Kaihongho/Powder_model_design/README.md

1. 目前最新的三轴平台是GANTRY44_AUTO_BUCKET.SLDPRT
