Kaihongho/Powder_model_design/drawings/B-001_overall.png

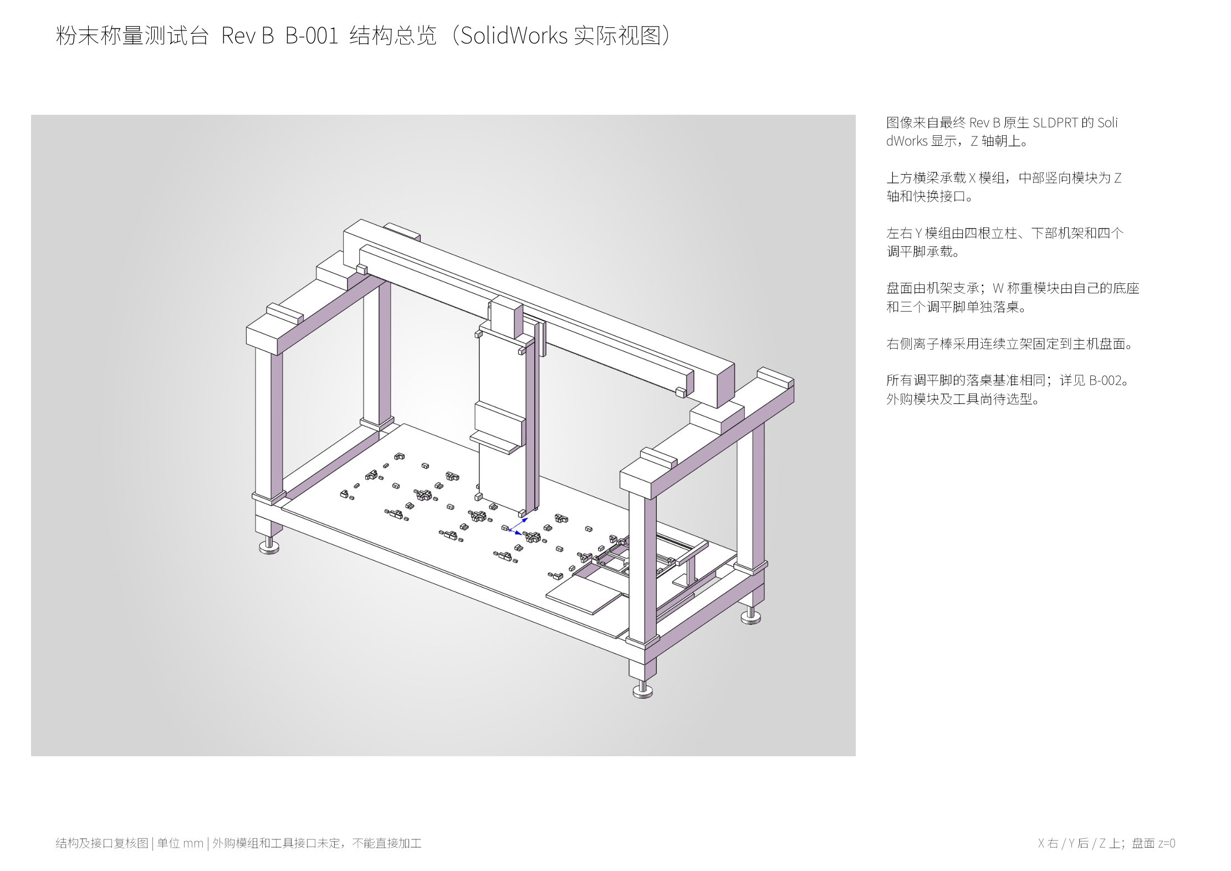
drawings/B-001_overall.png
