Kaihongho/Powder_model_design/drawings/B-002_support.png

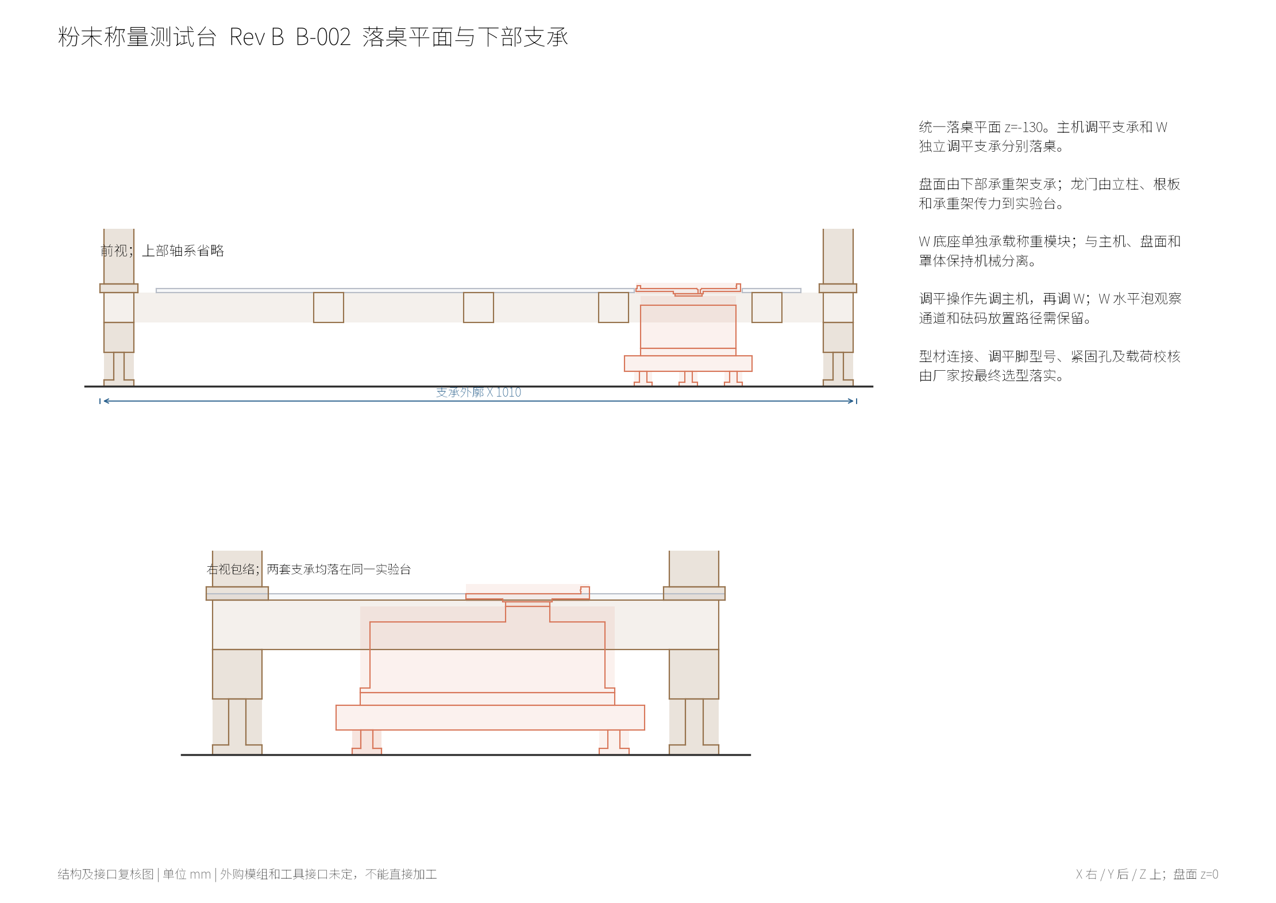
drawings/B-002_support.png
