Kaihongho/Powder_model_design/drawings/B-003_layout.png

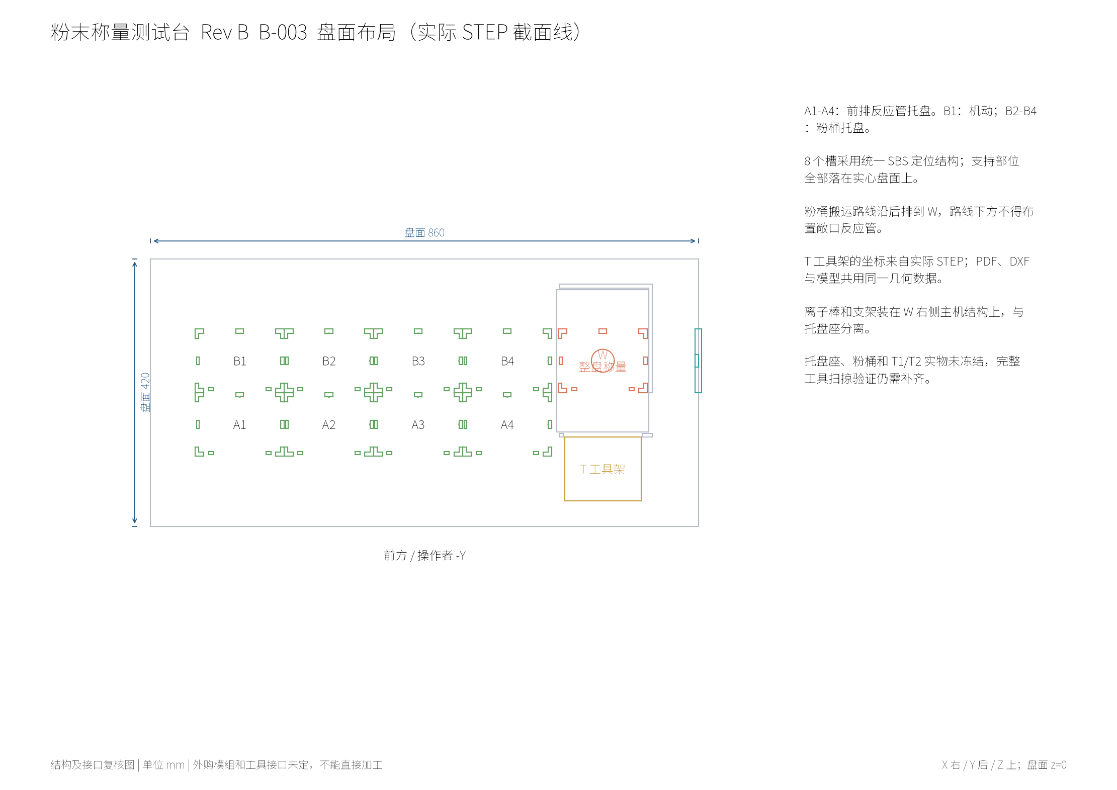
drawings/B-003_layout.png
