Kaihongho/Powder_model_design/drawings/B-004_weighing.png

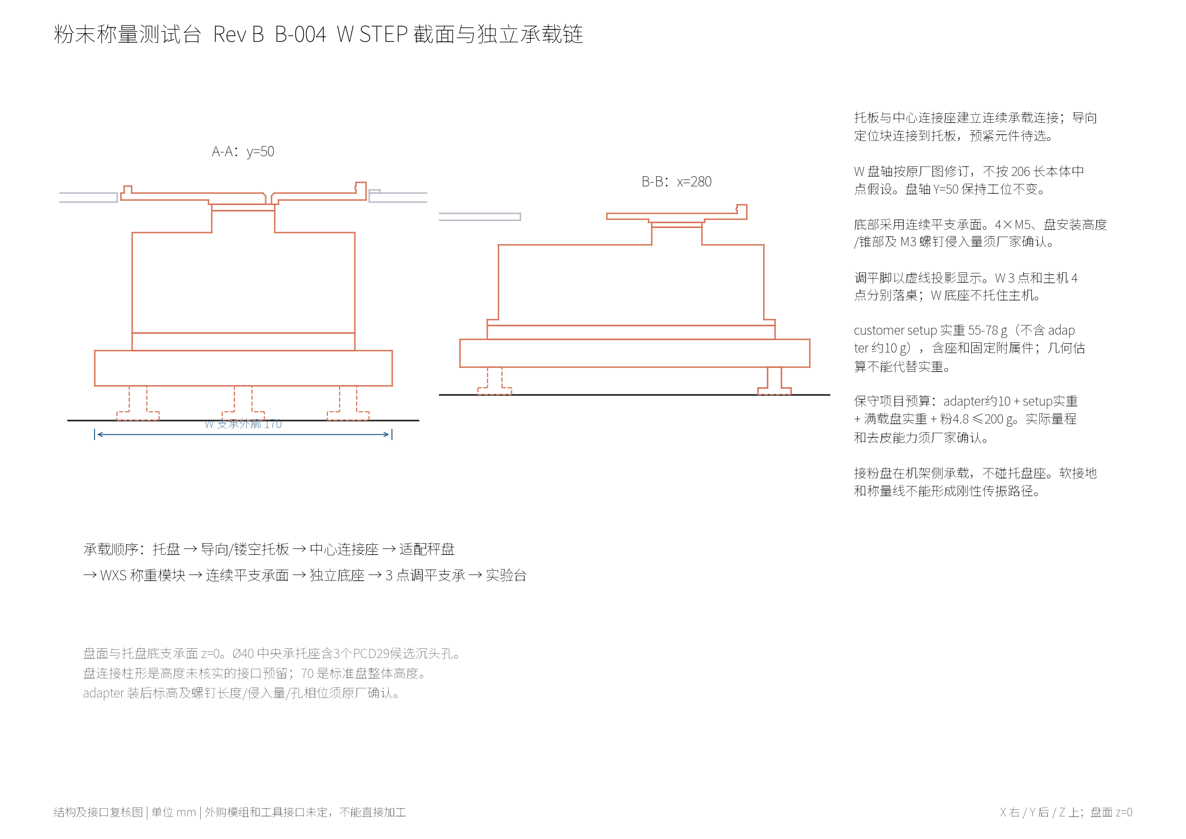
drawings/B-004_weighing.png
