Kaihongho/Powder_model_design/drawings/B-005_motion.png

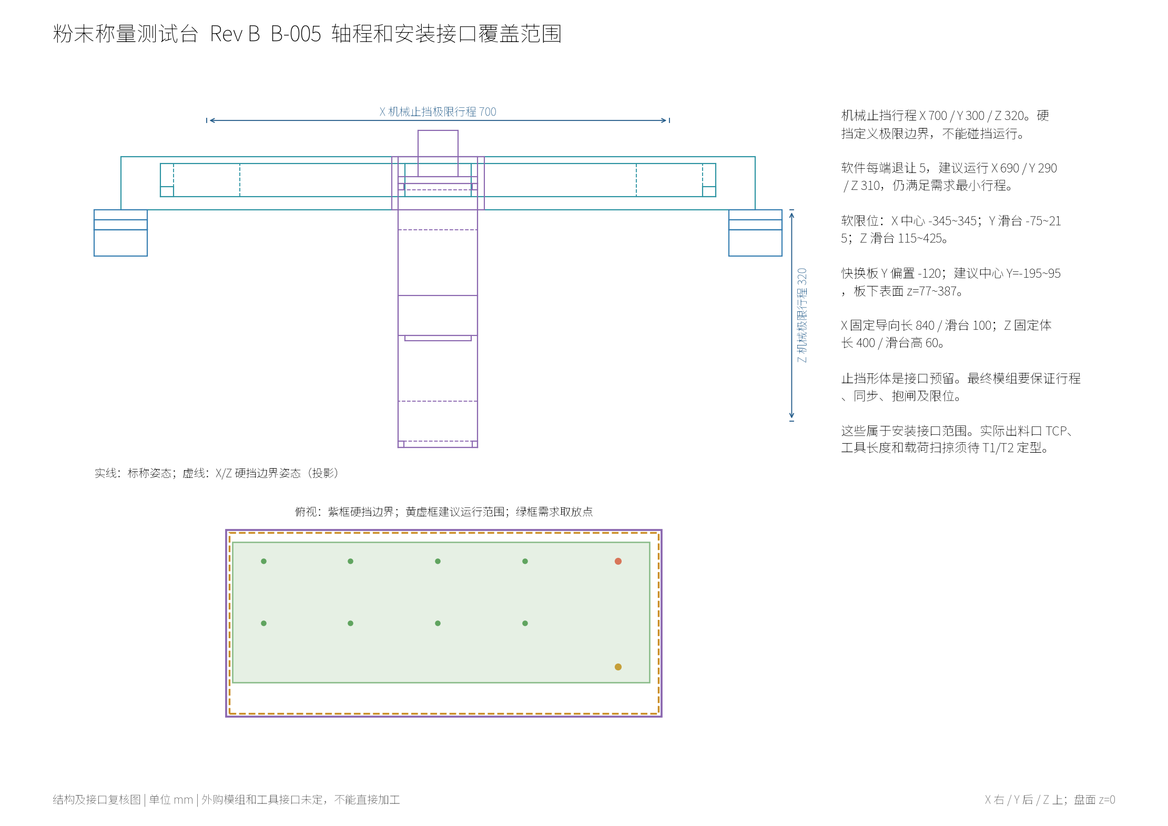
drawings/B-005_motion.png
