Kaihongho/Powder_model_design/drawings/B-006_connections.png

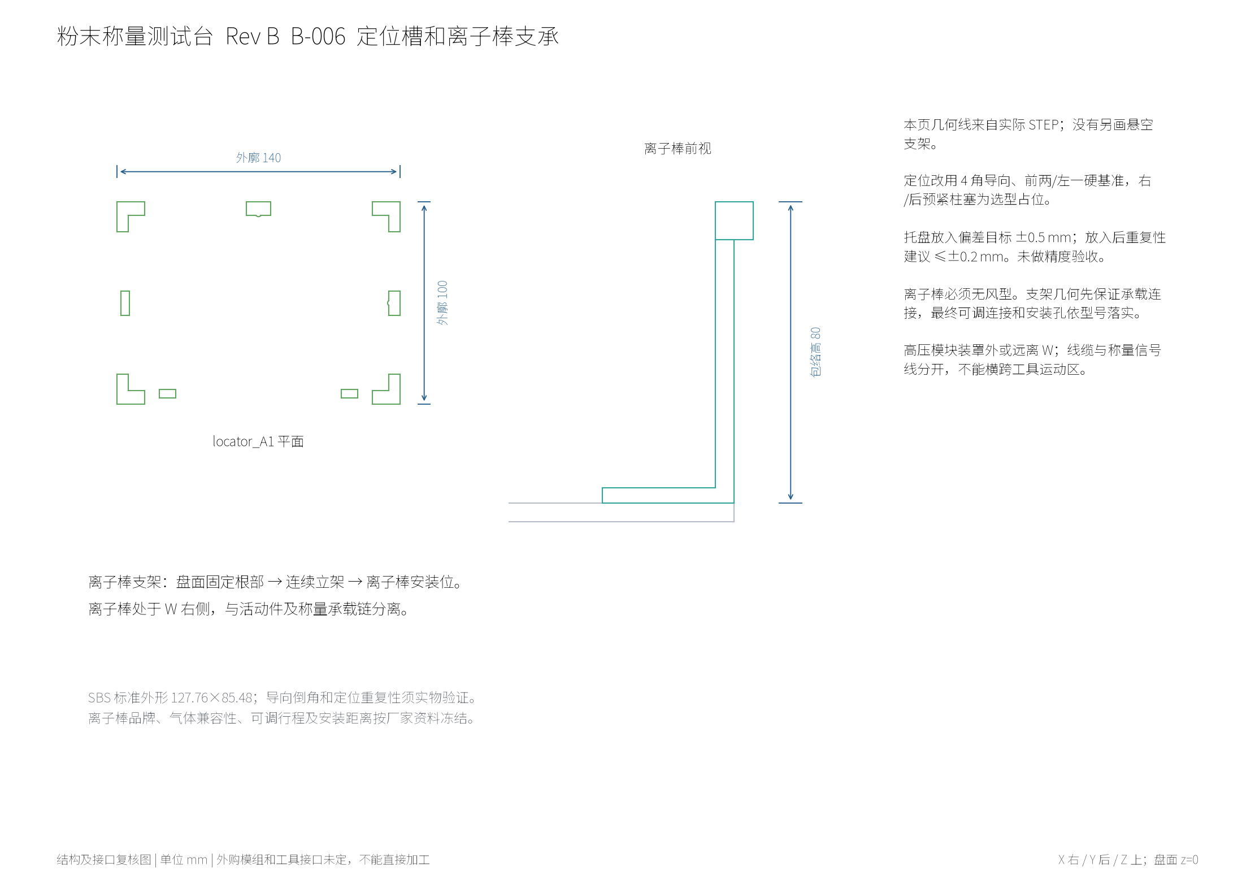
drawings/B-006_connections.png
