Kaihongho/Powder_model_design/drawings/B-007_review.png

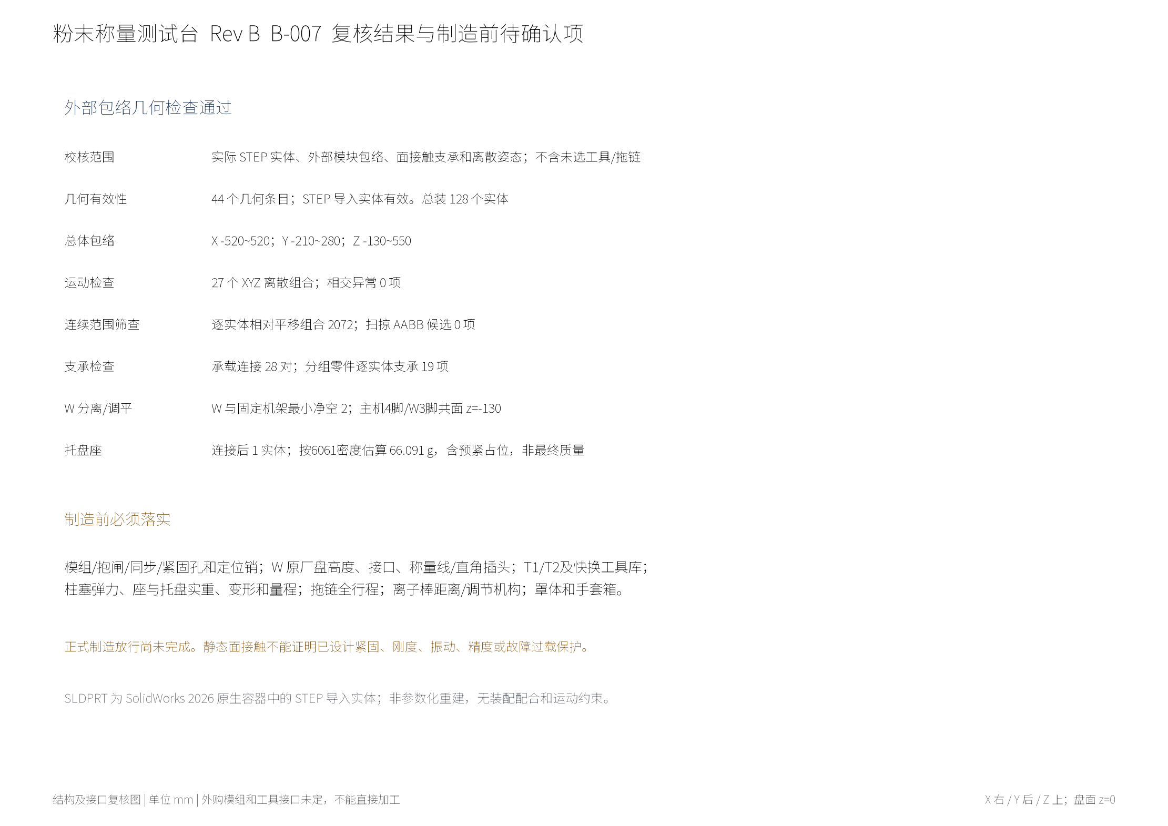
drawings/B-007_review.png
