Kaihongho/Powder_model_design/drawings/native_overall.png

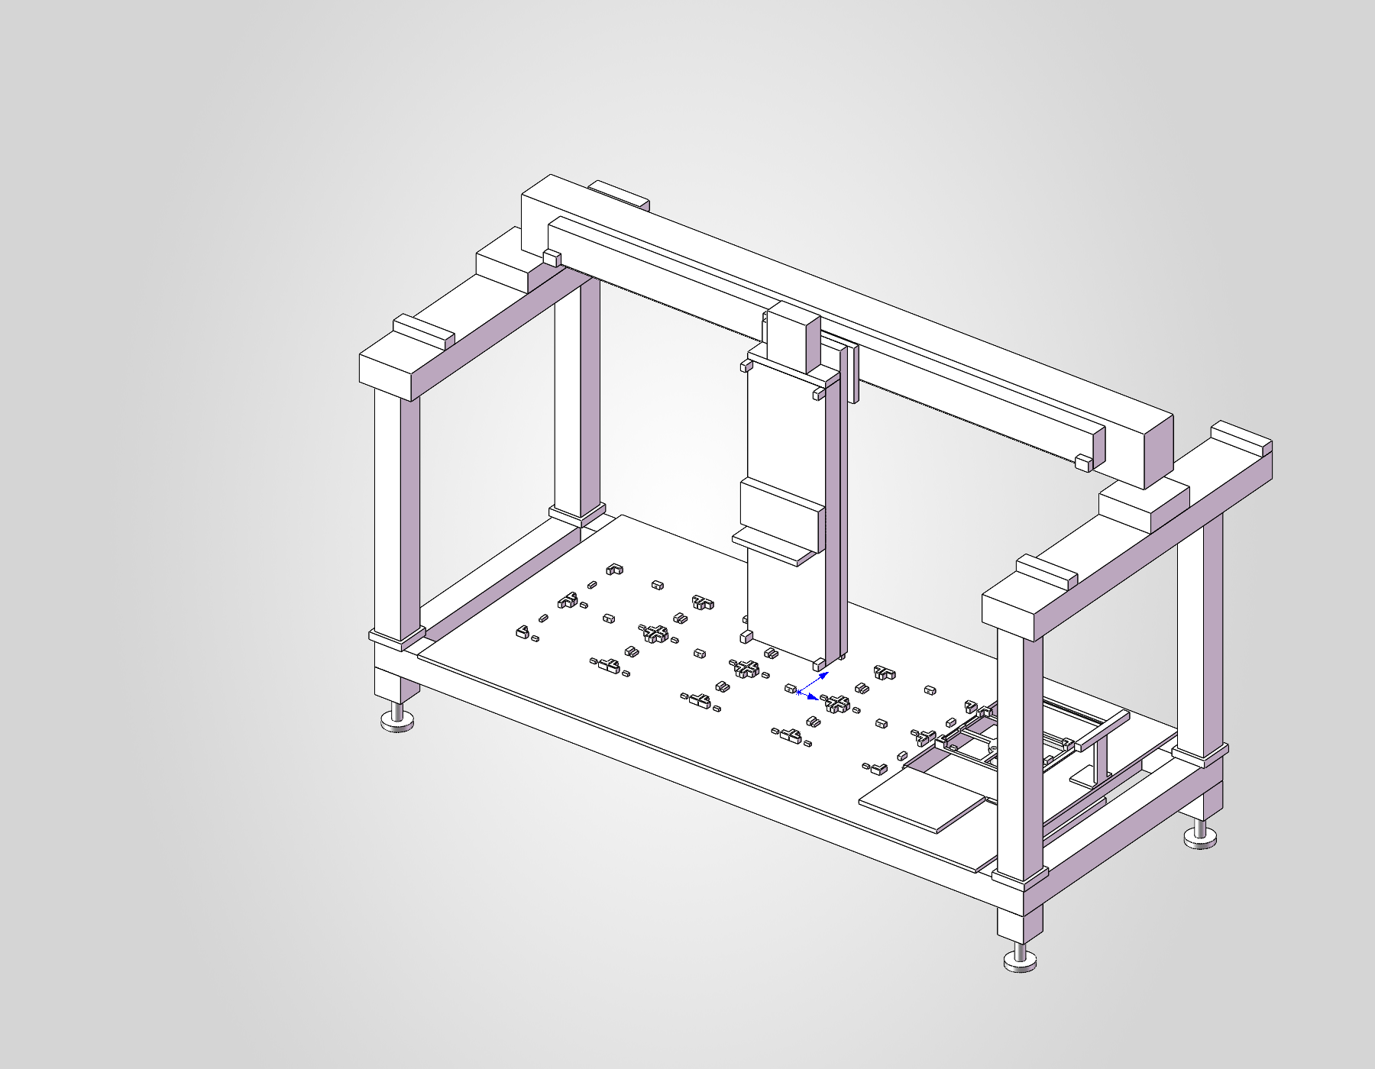
drawings/native_overall.png
