Kaihongho/Powder_model_design/粉桶图纸与说明/T2_取放步骤.png

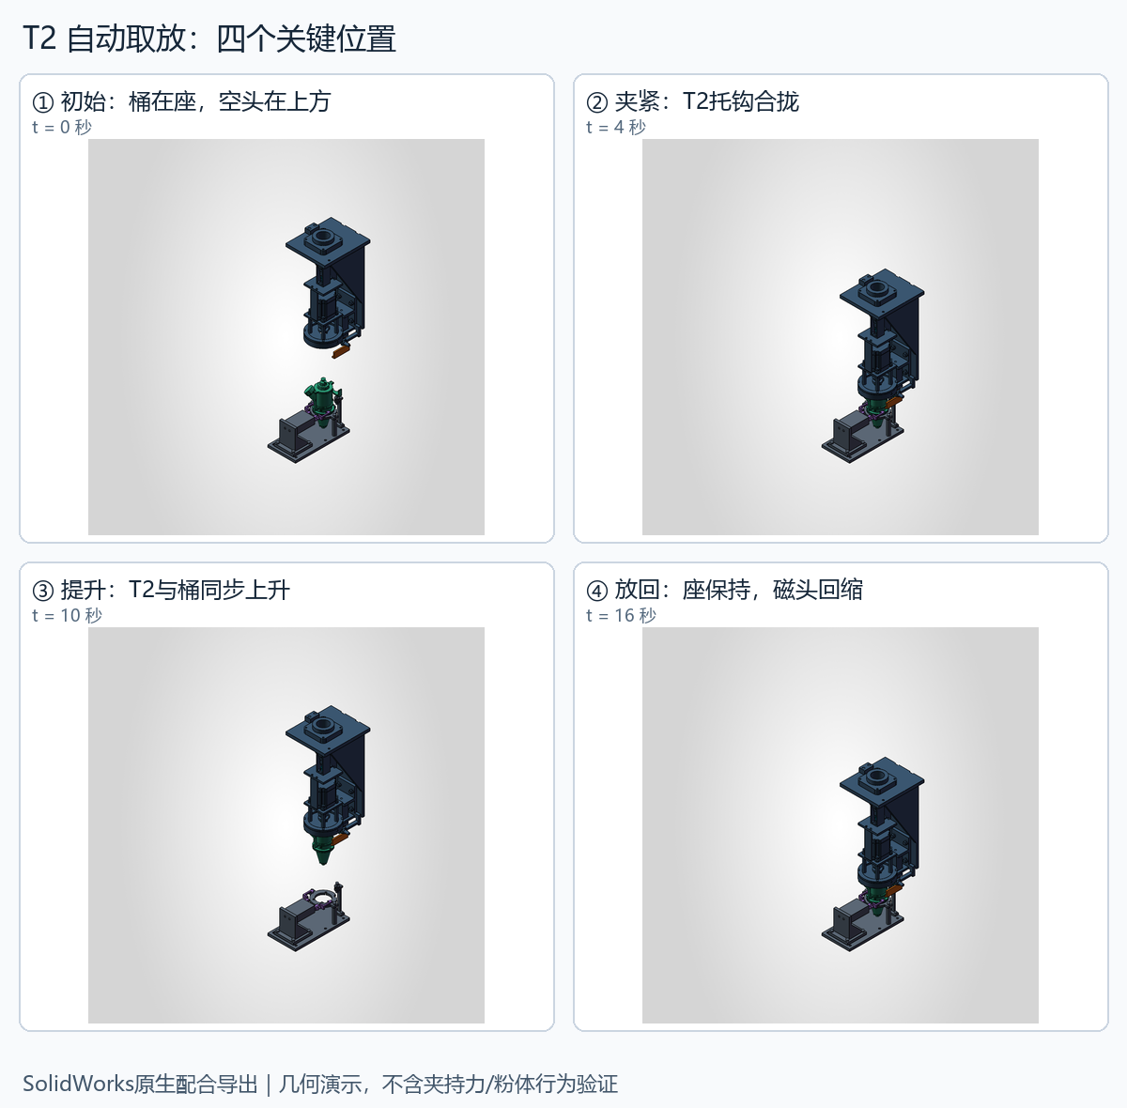
粉桶图纸与说明/T2_取放步骤.png
