Kaihongho/Powder_model_design/粉桶图纸与说明/T2_自动取放演示.gif

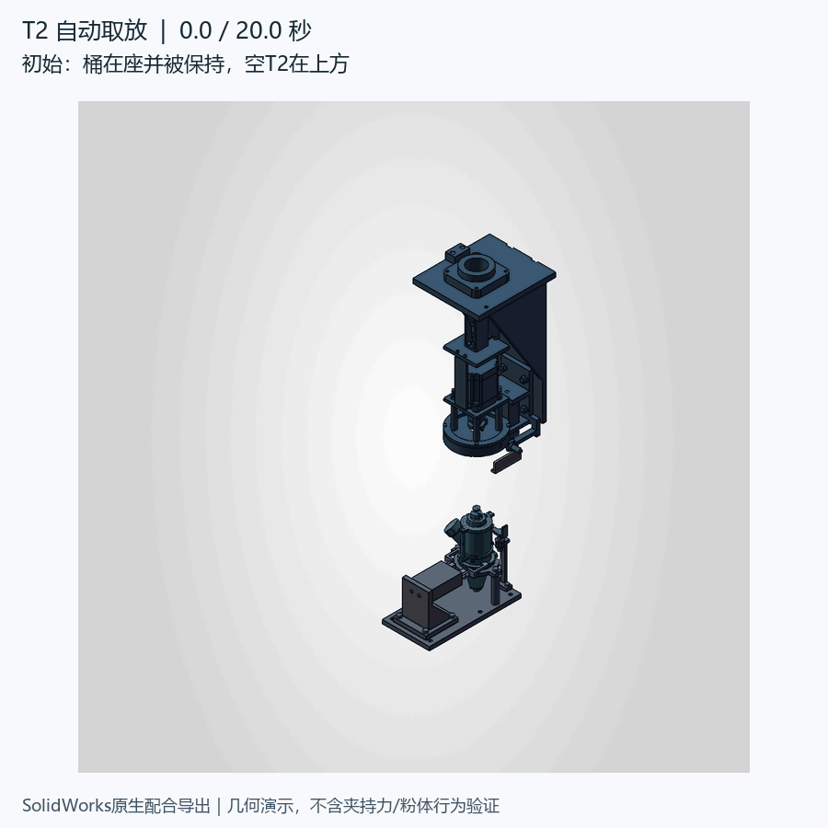
粉桶图纸与说明/T2_自动取放演示.gif
