Kaihongho/Powder_model_design/粉桶图纸与说明/T2接口承载架.png

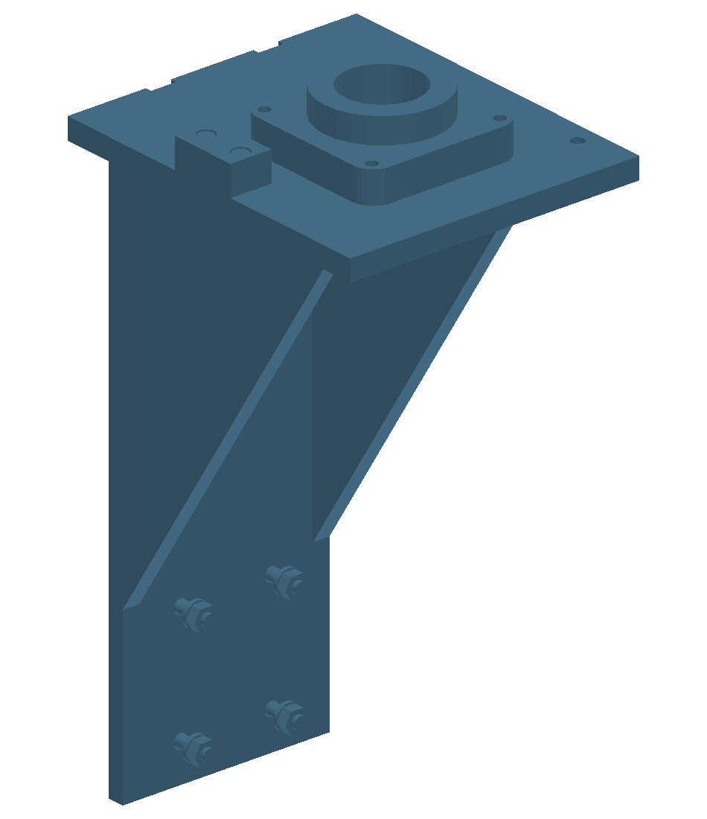
粉桶图纸与说明/T2接口承载架.png
