Kaihongho/Powder_model_design/粉桶图纸与说明/valve_rotation_overview.png

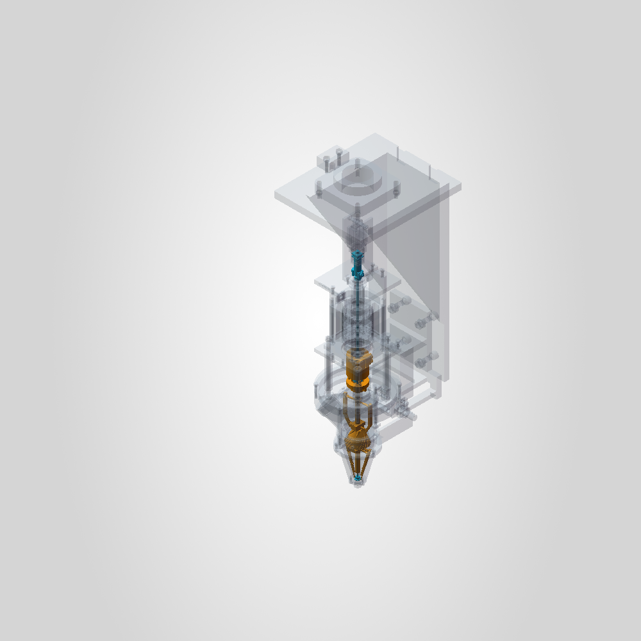
粉桶图纸与说明/valve_rotation_overview.png
