Kaihongho/Powder_model_design/粉桶图纸与说明/上部驱动与夹持.png

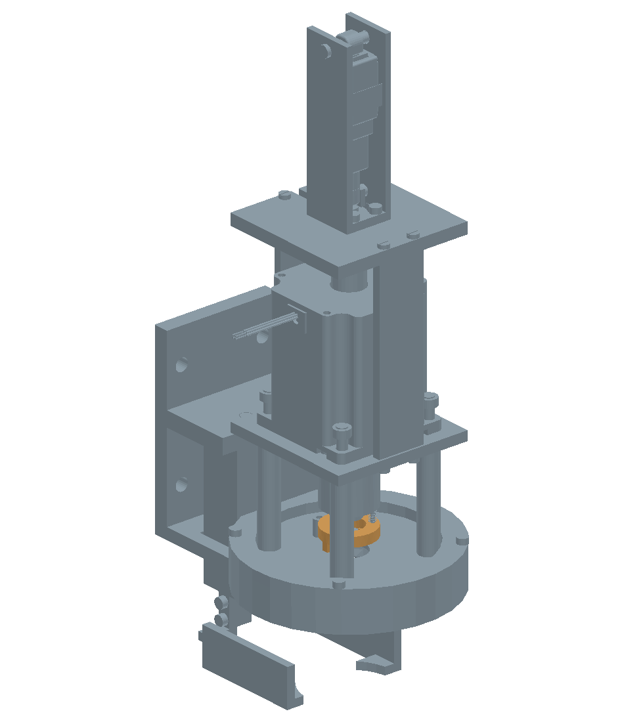
粉桶图纸与说明/上部驱动与夹持.png
