Kaihongho/Powder_model_design/粉桶图纸与说明/下部粉桶闭盖.png

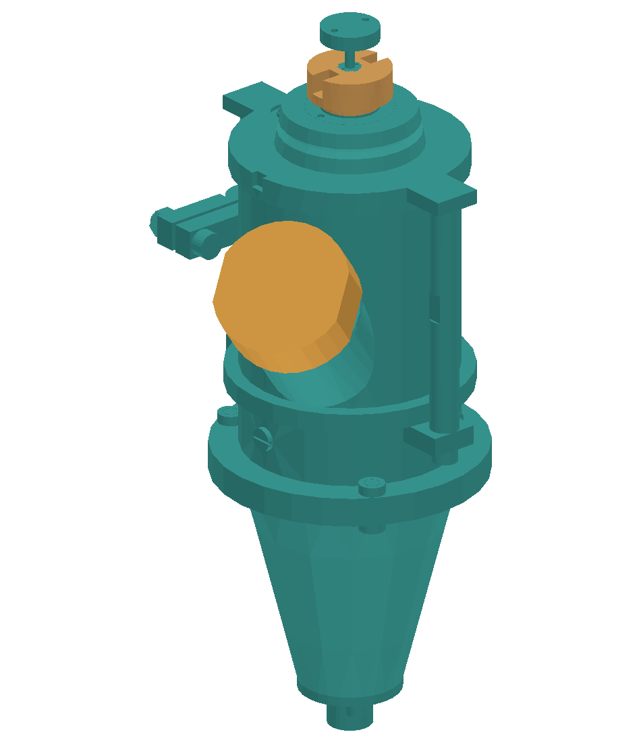
粉桶图纸与说明/下部粉桶闭盖.png
