Kaihongho/Powder_model_design/粉桶图纸与说明/对接总成.png

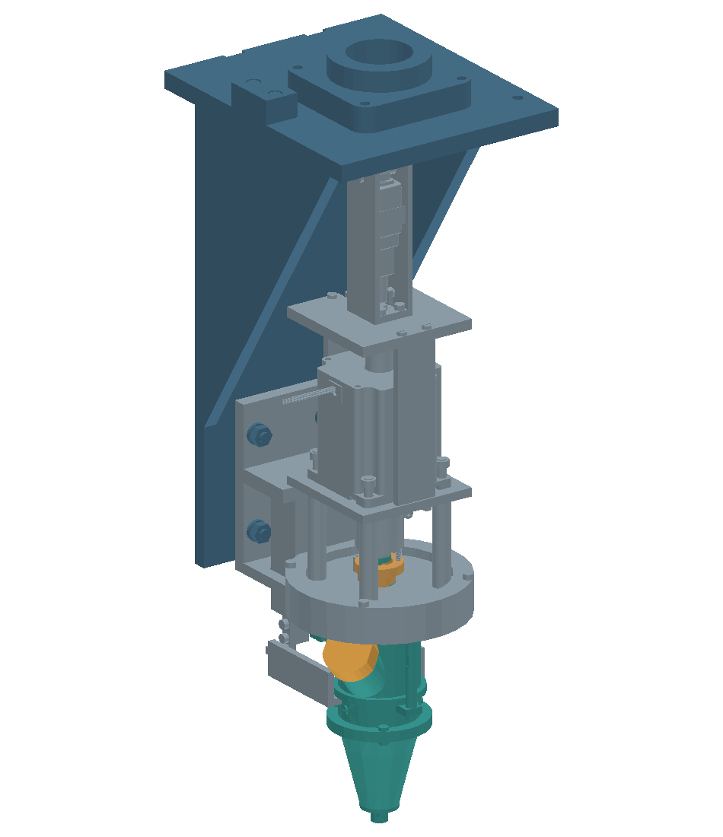
粉桶图纸与说明/对接总成.png
