Kaihongho/Powder_model_design/龙门架_BOM.xlsx

Sheet: 整机BOM
4.4 三轴龙门架 BOM
范围：龙门架、随Z驱动头支承、自动夹桶及随桶保持件。内部摆盘不在本次范围。
数量按采购件/套统计。模组固定体与滑台合为成套；原桶原件不与夹具聚合STEP重复计数。
机架定制项 | 21 | 轴模组成套数 | 4 |  | 原桶保留件成套数 | 1
分类 | 编号 | 名称 | 数量 | 单位 | 规格与接口（mm） | 材料 | 制造/采购状态 | 来源与模型编号
机架定制 | F_side_lower_L | 侧框下横管（左） | 1 | 件 | 外廓 X/Y/Z：60 × 969 × 60 mm。焊接侧框;焊缝详图定义, 不用贴面代替连接 | Q235B矩形管60×60×4 | 名义几何；工艺公差待冻结 | gantry44_manifest.json；F_side_lower_L.step
机架定制 | F_post_L_front | 立柱（前） | 1 | 件 | 外廓 X/Y/Z：60 × 60 × 528 mm。四周连续角焊缝a4;组焊去应力后精加工顶面 | Q235B矩形管60×60×4 | 名义几何；工艺公差待冻结 | gantry44_manifest.json；F_post_L_front.step
机架定制 | F_post_L_rear | 立柱（后） | 1 | 件 | 外廓 X/Y/Z：60 × 60 × 528 mm。四周连续角焊缝a4;组焊去应力后精加工顶面 | Q235B矩形管60×60×4 | 名义几何；工艺公差待冻结 | gantry44_manifest.json；F_post_L_rear.step
机架定制 | F_top_rail_L | Y轴上承梁（左） | 1 | 件 | 外廓 X/Y/Z：80 × 700 × 80 mm。与两柱焊接, 前后柱均承载 | Q235B矩形管80×80×4 | 名义几何；工艺公差待冻结 | gantry44_manifest.json；F_top_rail_L.step
机架定制 | F_top_cap_L | Y轴安装盖板（左） | 1 | 件 | 外廓 X/Y/Z：120 × 720 × 12 mm。焊后同装夹加工两侧安装平面;槽母/螺栓实装固定模组 | Q235B机加工盖板 | 名义几何；工艺公差待冻结 | gantry44_manifest.json；F_top_cap_L.step
机架定制 | F_foot_boss_L_front | 调平脚螺母套（前） | 1 | 件 | 外廓 X/Y/Z：24 × 24 × 20 mm。 | 钢焊接M12螺母套 | 名义几何；工艺公差待冻结 | gantry44_manifest.json；F_foot_boss_L_front.step
机架定制 | F_foot_boss_L_rear | 调平脚螺母套（后） | 1 | 件 | 外廓 X/Y/Z：24 × 24 × 20 mm。 | 钢焊接M12螺母套 | 名义几何；工艺公差待冻结 | gantry44_manifest.json；F_foot_boss_L_rear.step
机架定制 | F_side_lower_R | 侧框下横管（右） | 1 | 件 | 外廓 X/Y/Z：60 × 969 × 60 mm。焊接侧框;焊缝详图定义, 不用贴面代替连接 | Q235B矩形管60×60×4 | 名义几何；工艺公差待冻结 | gantry44_manifest.json；F_side_lower_R.step
机架定制 | F_post_R_front | 立柱（前） | 1 | 件 | 外廓 X/Y/Z：60 × 60 × 528 mm。四周连续角焊缝a4;组焊去应力后精加工顶面 | Q235B矩形管60×60×4 | 名义几何；工艺公差待冻结 | gantry44_manifest.json；F_post_R_front.step
机架定制 | F_post_R_rear | 立柱（后） | 1 | 件 | 外廓 X/Y/Z：60 × 60 × 528 mm。四周连续角焊缝a4;组焊去应力后精加工顶面 | Q235B矩形管60×60×4 | 名义几何；工艺公差待冻结 | gantry44_manifest.json；F_post_R_rear.step
机架定制 | F_top_rail_R | Y轴上承梁（右） | 1 | 件 | 外廓 X/Y/Z：80 × 700 × 80 mm。与两柱焊接, 前后柱均承载 | Q235B矩形管80×80×4 | 名义几何；工艺公差待冻结 | gantry44_manifest.json；F_top_rail_R.step
机架定制 | F_top_cap_R | Y轴安装盖板（右） | 1 | 件 | 外廓 X/Y/Z：120 × 720 × 12 mm。焊后同装夹加工两侧安装平面;槽母/螺栓实装固定模组 | Q235B机加工盖板 | 名义几何；工艺公差待冻结 | gantry44_manifest.json；F_top_cap_R.step
机架定制 | F_foot_boss_R_front | 调平脚螺母套（前） | 1 | 件 | 外廓 X/Y/Z：24 × 24 × 20 mm。 | 钢焊接M12螺母套 | 名义几何；工艺公差待冻结 | gantry44_manifest.json；F_foot_boss_R_front.step
机架定制 | F_foot_boss_R_rear | 调平脚螺母套（后） | 1 | 件 | 外廓 X/Y/Z：24 × 24 × 20 mm。 | 钢焊接M12螺母套 | 名义几何；工艺公差待冻结 | gantry44_manifest.json；F_foot_boss_R_rear.step
机架定制 | F_cross_lower_front | 底部横梁（前） | 1 | 件 | 外廓 X/Y/Z：1140 × 60 × 60 mm。两端a4连续角焊缝 | Q235B矩形管60×60×4 | 名义几何；工艺公差待冻结 | gantry44_manifest.json；F_cross_lower_front.step
机架定制 | F_cross_lower_rear | 底部横梁（后） | 1 | 件 | 外廓 X/Y/Z：1140 × 60 × 60 mm。两端a4连续角焊缝 | Q235B矩形管60×60×4 | 名义几何；工艺公差待冻结 | gantry44_manifest.json；F_cross_lower_rear.step
机架定制 | B_sole_L | X横梁端底板（左） | 1 | 件 | 外廓 X/Y/Z：140 × 150 × 12 mm。6061焊接箱梁端底板;沉孔M5从箱梁贯通工具孔安装 | 6061-T6 | 名义几何；工艺公差待冻结 | gantry44_manifest.json；B_sole_L.step
机架定制 | B_sole_R | X横梁端底板（右） | 1 | 件 | 外廓 X/Y/Z：140 × 150 × 12 mm。6061焊接箱梁端底板;沉孔M5从箱梁贯通工具孔安装 | 6061-T6 | 名义几何；工艺公差待冻结 | gantry44_manifest.json；B_sole_R.step
机架定制 | B_crossbeam | X轴承载箱梁 | 1 | 件 | 外廓 X/Y/Z：1330 × 80 × 120 mm。箱形截面120×80×5;6061焊接区按退火强度校核,去应力后加工安装面;两端底板a4焊接 | 6061-T6 | 名义几何；工艺公差待冻结 | gantry44_manifest.json；B_crossbeam.step
机架定制 | A_Z_fixed_backplate | Z固定背板 | 1 | 件 | 外廓 X/Y/Z：110 × 12 × 575 mm。110×575×12;两列Z底槽M6,4×M5连接X滑台;无需重钻厂家件 | 6061-T6 | 名义几何；工艺公差待冻结 | gantry44_manifest.json；A_Z_fixed_backplate.step
机架定制 | A_Z_tool_drop | Z端带筋下伸座 | 1 | 件 | 外廓 X/Y/Z：100 × 30 × 290 mm。整体铣削带筋下伸座,不以零件悬空获得工作高度;全行程端点TCP=25..345 | 6061-T6 | 名义几何；工艺公差待冻结 | gantry44_manifest.json；A_Z_tool_drop.step
机架标准件 | Ybase_M6x18 | Y模组底座圆柱头螺钉 | 12 | 件 | M6 × 18 | 钢 | 等级/表面处理/扭矩待冻结 | gantry44_manifest.json：Ybase_M6x18；按实例计数
外购待定 | F_level_foot | 调平支脚 | 4 | 件 | M12脚杆、脚垫Ø60；需按整机重量选额定载荷 | 钢/防滑脚垫 | 供应商型号/承载待确认 | gantry44_manifest.json：F_level_foot；按实例计数
机架标准件 | F_locknut_M12 | 调平脚锁紧螺母 | 4 | 件 | M12 | 钢 | 等级/表面处理/扭矩待冻结 | gantry44_manifest.json：F_locknut_M12；按实例计数
机架标准件 | Yslide_M5x20 | Y滑台连接螺钉 | 12 | 件 | M5 × 20 | 钢 | 等级/表面处理/扭矩待冻结 | gantry44_manifest.json：Yslide_M5x20；按实例计数
机架标准件 | Xbase_M6x12 | X模组底座螺钉 | 10 | 件 | M6 × 12 | 钢 | 等级/表面处理/扭矩待冻结 | gantry44_manifest.json：Xbase_M6x12；按实例计数
机架标准件 | Xbase_washer | X模组底座平垫 | 10 | 件 | M6；几何尺寸以分件STEP为准 | 钢 | 等级/表面处理/扭矩待冻结 | gantry44_manifest.json：Xbase_washer；按实例计数
机架标准件 | XZ_M5x25 | X滑台与Z背板连接螺钉 | 4 | 件 | M5 × 25 | 钢 | 等级/表面处理/扭矩待冻结 | gantry44_manifest.json：XZ_M5x25；按实例计数
机架标准件 | Zbase_M6x18 | Z模组底座螺钉 | 8 | 件 | M6 × 18 | 钢 | 等级/表面处理/扭矩待冻结 | gantry44_manifest.json：Zbase_M6x18；按实例计数
机架标准件 | Zslide_M4x20 | Z滑台与下伸座螺钉 | 6 | 件 | M4 × 20 | 钢 | 等级/表面处理/扭矩待冻结 | gantry44_manifest.json：Zslide_M4x20；按实例计数
机架标准件 | Tool_M6x40 | 夹具背板与下伸座螺钉 | 4 | 件 | M6 × 40 | 钢 | 等级/表面处理/扭矩待冻结 | gantry44_manifest.json：Tool_M6x40；按实例计数
机架标准件 | Tool_M6_nut | 夹具接口螺母 | 4 | 件 | M6 | 钢 | 等级/表面处理/扭矩待冻结 | gantry44_manifest.json：Tool_M6_nut；按实例计数
机架标准件 | Tool_M6_washer | 夹具接口平垫 | 4 | 件 | M6；几何尺寸以分件STEP为准 | 钢 | 等级/表面处理/扭矩待冻结 | gantry44_manifest.json：Tool_M6_washer；按实例计数
接口定制 | FSL80_slot_nut | FSL80轴向装入槽母 | 22 | 件 | M6，20 × 9.4 × 4 mm；厂家装入后封端 | 钢 | 材料/螺纹承载/扭矩待厂家确认 | gantry44_manifest.json：FSL80_slot_nut；按实例计数
接口定制 | FSL60_slot_nut | FSL60轴向装入槽母 | 8 | 件 | M6，长20/肩宽14.4/背宽10/厚4 mm；厂家装入 | 钢 | 材料/螺纹承载/扭矩待厂家确认 | gantry44_manifest.json：FSL60_slot_nut；按实例计数
外购轴模组 | AX-X | X轴成套模组 | 1 | 套 | FSL80 E800 10C7-BC-B60参考；工作行程700 mm；含壳体、滑台及配套电机 | 原厂混合材料 | 订货配置/力矩/原点限位待确认 | FSL80 E800 10C7-BC-B60.STEP；FUYU手册v3.1
外购轴模组 | AX-Y | 双Y轴成套模组 | 2 | 套 | 每套FSL80 E400参考；工作行程260 mm；两侧中心跨距1200 mm | 原厂混合材料 | 双Y同步/回零/电机配置待确认 | FSL80 E400 10C7-BC-B60.STEP；FUYU手册v3.1
外购轴模组 | AX-Z | Z轴成套模组（抱闸必选） | 1 | 套 | FSL60 E400参考；工作行程320 mm；订货必须带常闭失电制动 | 原厂混合材料 | 当前STEP未验证抱闸版；不可据此下单 | FSL60 E400 10C7-BC-B60.STEP；FUYU手册v3.1
原桶成套来源 | SRC-BUCKET | 原粉桶及驱动头保留部件 | 1 | 套 | 源有59种SLDPRT。装入时扣除原lid、dock_lock_ring、dock_lock_toggle，新增B/C件另列。 | 源混合材料未冻结 | 成套来源；内部驱动连接仍待验证 | burr_mill_doser_improved.SLDASM；原桶来源与替换表
夹具标准件 | C-F01 | 压盖圆柱头螺钉 | 4 | 件 | M3 × 18。 | 按采购 | 等级/扭矩待冻结 | clamp_manufacturing_dimensions.json；C-F01_cap_M3x18_0、C-F01_cap_M3x18_1、C-F01_cap_M3x18_2、C-F01_cap_M3x18_3
夹具标准件 | C-F02 | 电爪安装螺钉 | 2 | 件 | M3 × 10。 | 按采购 | 按Zimmer安装要求 | clamp_manufacturing_dimensions.json；C-F02_GEP_M3x10_-8、C-F02_GEP_M3x10_8
夹具标准件 | C-F03 | 电爪定位套 | 2 | 件 | Ø5 / 内Ø3.2 × 2.4 mm；两面各嵌1.2。 | 按采购 | 订货确认是否随电爪供货 | clamp_manufacturing_dimensions.json；C-F03_GEP_D5_sleeve_-8、C-F03_GEP_D5_sleeve_8
夹具标准件 | C-F07 | 平端内六角紧定螺钉 | 1 | 件 | ISO4026 M6 × 12；内六角3；进入原机头径向孔外段。 | 按采购 | 等级/防松扭矩待冻结 | clamp_manufacturing_dimensions.json；C-F07_ISO4026_M6x12_anti_rotation
夹具定制 | C-A01 | 头盘一体托座及电爪承载后背 | 1 | 件 | 内Ø90.2定位环，外Ø100；后面Y90；4×Ø6.6孔距44×55。 | 6061-T6候选 | 名义几何；制造公差待冻结 | clamp_manufacturing_dimensions.json；C-A01_head_capture_and_rear_bracket
夹具定制 | C-A02 | 头盘外缘压盖 | 1 | 件 | 内Ø78/外Ø100×5；4×Ø3.2孔PCD95。 | 6061-T6候选 | 名义几何；制造公差待冻结 | clamp_manufacturing_dimensions.json；C-A02_head_capture_cap
外购电爪 | C-P01 | 电动平行夹爪成套 | 1 | 套 | Zimmer GEP2006IL-03-B；含本体与两原爪；每爪行程6 mm。 | 按采购 | 二维接口建模；型号/负载最终核对 | clamp_manufacturing_dimensions.json；C-P01_GEP2006IL03_2D_INTERFACE（C-P03两原爪随套，不重复采购）
外购待定 | C-P02 | 桶在位M5探头 | 1 | 件 | CAD仅包络。端面中心线距桶2.104 mm，最小边缘间隙0.960 mm。 | 按采购 | 实际有效检测距离/型号未定 | clamp_manufacturing_dimensions.json；C-P02_M5_presence_sensor_PROCUREMENT_ENVELOPE
夹具标准件 | C-F04 | M5传感器锁母 | 2 | 件 | M5；配最终传感器外螺纹。 | 按采购 | 订货确认是否随传感器供货 | clamp_manufacturing_dimensions.json；C-F04_M5_sensor_nut_front、C-F04_M5_sensor_nut_rear
夹具定制 | C-A03_positive_capture_finger_-1 | 正向承托夹指（左） | 1 | 件 | 两件镜像；闭合内弧Ø44.6，托Ø50法兰；每爪开6 mm。 | 6061-T6候选 | 指长/偏心负载待Zimmer确认 | clamp_manufacturing_dimensions.json；C-A03_positive_capture_finger_-1
夹具标准件 | C-F05 | 夹指安装螺钉 | 4 | 件 | M3 × 10，每指2颗。 | 按采购 | 按Zimmer安装要求 | clamp_manufacturing_dimensions.json；C-F05_finger_M3x10_-1_0、C-F05_finger_M3x10_-1_1、C-F05_finger_M3x10_1_0、C-F05_finger_M3x10_1_1
夹具标准件 | C-F06 | 夹指定位套 | 4 | 件 | Ø5 / 内Ø3.2 × 2.4 mm，每指2件。 | 按采购 | 订货确认是否随电爪供货 | clamp_manufacturing_dimensions.json；C-F06_finger_D5_sleeve_-1_0、C-F06_finger_D5_sleeve_-1_1、C-F06_finger_D5_sleeve_1_0、C-F06_finger_D5_sleeve_1_1
夹具定制 | C-A03_positive_capture_finger_1 | 正向承托夹指（右） | 1 | 件 | 两件镜像；闭合内弧Ø44.6，托Ø50法兰；每爪开6 mm。 | 6061-T6候选 | 指长/偏心负载待Zimmer确认 | clamp_manufacturing_dimensions.json；C-A03_positive_capture_finger_1
随桶配套 | B-A02 | 随桶拉柱 | 2 | 件 | Ø6 × 48.5825；上下M3深10；扳手对边5。 | 304不锈钢候选 | 304候选；公差/防松待冻结 | clamp_manufacturing_dimensions.json；B-A02_bucket_tie_post_-1、B-A02_bucket_tie_post_1
随桶配套 | B-A03 | 随桶法兰保持托脚 | 2 | 件 | 10 × 9.7 × 4 mm；Ø3.2通孔；两件镜像，正向托法兰。 | 6061-T6候选 | 名义几何；制造公差待冻结 | clamp_manufacturing_dimensions.json；B-A03_bucket_retention_foot_-1、B-A03_bucket_retention_foot_1
随桶配套 | B-F01 | 上盖齐平沉头螺钉 | 2 | 件 | M3 × 10，90°沉头，顶面不得高于原盖贴合面。 | 按采购 | 材料/防松扭矩待冻结 | clamp_manufacturing_dimensions.json；B-F01_flush_M3x10_-1、B-F01_flush_M3x10_1
随桶配套 | B-F02 | 拉柱底部圆柱头螺钉 | 2 | 件 | M3 × 12。 | 按采购 | 材料/防松扭矩待冻结 | clamp_manufacturing_dimensions.json；B-F02_bottom_M3x12_-1、B-F02_bottom_M3x12_1
随桶配套 | B-A01 | AUTO-SWAP派生上盖 | 1 | 件 | 保留源内型/锥面/气孔；新增±Y外耳与2×M3沉头连接。 | 原粉路材料未冻结 | 替换原lid；粉路材料待确认 | clamp_manufacturing_dimensions.json；B-A01_lid_AUTO_SWAP_derived

Sheet: 独立停车座
独立单桶停车座 BOM
下表为一个停车座的独立物料，不装入本次龙门架总装。自动释放前必须先由停车座承载粉桶。
停车座位置、安装基础及4颗底座安装螺钉的长度/配套螺母待安装现场确定，不虚填。
分类 | 编号 | 名称 | 数量 | 单位 | 规格与接口（mm） | 材料 | 制造/采购状态 | 来源与模型编号
停车座定制 | D-A03 | 停车座立柱 | 2 | 件 | Ø12 × 53.3556；上下M5螺纹。 | 6061-T6候选 | 名义几何；公差待冻结 | clamp_manufacturing_dimensions.json；D-A03_support_post_-1、D-A03_support_post_1
停车座标准件 | D-F01 | 停车座顶部圆柱头螺钉 | 2 | 件 | M5 × 16。 | 按采购 | 等级/扭矩待冻结 | clamp_manufacturing_dimensions.json；D-F01_top_M5x16_-1、D-F01_top_M5x16_1
停车座标准件 | D-F02 | 停车座底部沉孔螺钉 | 2 | 件 | M5 × 16圆柱头；底板沉孔内，不得凸出底面。 | 按采购 | 等级/扭矩待冻结 | clamp_manufacturing_dimensions.json；D-F02_bottom_M5x16_-1、D-F02_bottom_M5x16_1
停车座定制 | D-A01 | 独立停车底板 | 1 | 件 | 100 × 90 × 8；4×Ø6.6安装孔，中心(±40,±32)。 | 6061-T6候选 | 名义几何；安装位置另定 | clamp_manufacturing_dimensions.json；D-A01_dock_base
停车座定制 | D-A02 | 停车法兰承托座 | 1 | 件 | 内Ø44.4/外Ø70×6；托原Ø56下法兰；3×Ø6避螺钉头。 | 6061-T6候选 | 名义几何；公差待冻结 | clamp_manufacturing_dimensions.json；D-A02_flange_support_seat

Sheet: 待确认采购
制造前需要冻结的采购与验收项
本表是BOM采购状态补充，已有编号不重复计数；新增未定项数量留空，不虚构品牌和型号。
供应商答复填入J列。未获得真实型号和接口图前，相关几何不得标记为已验证。
编号 | 对应BOM | 功能项目 | 要求 | 必须确认的参数 | 当前缺口 | 接口/验收约束 | 依据 | 供应商答复
P01 | AX-Z（不另计套数） | Z轴常闭失电抱闸 | 必选 | 制动器或抱闸电机真实外形、失电保持力矩、额定负载和制动接线 | 缺厂家抱闸版图纸及断电实测 | 匹配Z整套配置 | 需求G4；axis_module_interfaces.json
P02 | AX-Y（不另计模组） | 双Y同步与独立回零 | 必选 | 闭环反馈、龙门校正、故障停机与回零策略；厂家决定具体电气配置 | 缺同步控制方案及带载验收 | 不得仅给两个电机相同脉冲 | 需求G1/G3；gantry_reference_audit.json
P03 | 新增电气成套 | 电机驱动器与运动控制器 | 必选 | 按X、双Y、Z及原桶电机的最终配置统一匹配；数量与型号暂无 | 缺轴电机选型/电气系统定义 | 热源远离天平W | 需求G6
P04 | C-P01（已计1套） | GEP夹爪采购与IO-Link | 必选 | 核对GEP2006IL-03-B；每爪6 mm；包括两原爪，定位套/螺钉供货范围需确认 | 缺指长定义/偏心力矩确认 | 每指CAD14.588 g，空间最远59.380 mm，仅几何参考 | Zimmer官方二维接口；clamp_manufacturing_dimensions.json
P05 | C-P02（已计1件） | 桶在位M5传感器 | 必选 | 最终型号取决于桶材料、有效检测距离、粉尘及接线；外形仅采购包络 | 中心线间隙2.104 mm；不能默认1 mm探头能检测 | 必须与爪位置形成双条件确认 | clamp_manufacturing_dimensions.json
P06 | 新增电气成套 | 原点、限位与故障检测 | 必选 | 清点模组现有接近开关，再确定补充数量/型号及安全接口 | 真实限位位置与控制原点尚未冻结 | 避免把STEP中一个开关当全套限位 | axis_module_interfaces.json
P07 | 新增安装配套 | 拖链、支架与运动电缆 | 必选 | 按实际线径、数量、弯曲半径和行程选择；不能只依空外廓下单 | 型号、长度、布线路径尚未定义 | 需追加全行程干涉核对 | 需求G1/G6；本轮未建模
P08 | SRC-BUCKET（成套内） | 原桶内部驱动与开阀执行器 | 待验证 | 旋转轴/联轴器正连接、轴向杆连接、实际执行器型号、出粉嘴固定 | 暂无开阀力/行程/阻力矩实测 | 不把原桶功能包络当已完工驱动 | new_bucket_audit.json
P09 | AX-X/Y/Z及夹具 | 整头载荷与重心验收 | 待验证 | C模块驱动头+夹具+满桶/附件暂按5 kg，另加下伸座/紧固件1.226 kg，Z外载预算6.226 kg | 缺实称；5 kg仅C模块采购目标，不是整个Z末端 | 不得用CAD统一密度估整套质量 | 需求G2；preliminary_load_budget.json
P10 | FSL80/60_slot_nut | 槽母强度及装入工艺 | 必选 | 20 mm长、4 mm厚；轴向封端前装入。厂家确认钢号/镀层/M6承载和扭矩 | 已有净空几何，承载未验证 | 不能按普通厚M6螺母扭矩直接拧紧 | axis_tnut_interfaces.json
P11 | 独立停车座 | 底座安装固定件 | 必选 | 4×Ø6.6安装孔，配M6；现场基础厚度决定长度及螺母/锚固形式 | 安装基础/位置暂无 | 不得悬空自动松爪 | clamp_manufacturing_dimensions.json
P12 | 整机验收 | 重复定位与热稳定性 | 待验证 | 热态末端重复定位目标≤±0.05 mm；按真实TCP、负载、行程现场测量 | 原轴目录±0.02 mm不等于整机验收 | 驱动器外置；电机热影响需实测 | 需求G3/G6；FUYU手册v3.1

Sheet: 原桶来源与替换
原桶成套来源与三项替换
59行为源SLDPRT种类清单。实例数来自装入派生模型的映射，既不是CAD实体数，也不是额外采购量。
原lid、dock_lock_ring、dock_lock_toggle在本方案装入数为0；新增B件与C夹具只在整机BOM计一次。
序号 | 原件编号 | 本方案处理 | 装入实例数 | 数量口径 | 采购归属 | 状态 | 源文件快照
1 | bm4_ring_burr | 保留原件 | 1 | 成套内实例 | SRC-BUCKET 已含，不另计采购 | 源几何参考；材料/功能未全验 | DISK_20261011_bm4_ring_burr.SLDPRT
2 | bm4_rotor_burr | 保留原件 | 1 | 成套内实例 | SRC-BUCKET 已含，不另计采购 | 源几何参考；材料/功能未全验 | DISK_20261011_bm4_rotor_burr.SLDPRT
3 | bm4_hopper | 保留原件 | 1 | 成套内实例 | SRC-BUCKET 已含，不另计采购 | 源几何参考；材料/功能未全验 | DISK_20261011_bm4_hopper.SLDPRT
4 | bm4_mill_carrier | 保留原件 | 1 | 成套内实例 | SRC-BUCKET 已含，不另计采购 | 源几何参考；材料/功能未全验 | DISK_20261011_bm4_mill_carrier.SLDPRT
5 | bm4_outlet_cone | 保留原件 | 1 | 成套内实例 | SRC-BUCKET 已含，不另计采购 | 源几何参考；材料/功能未全验 | DISK_20261011_bm4_outlet_cone.SLDPRT
6 | bm4_valve_seat | 保留原件 | 1 | 成套内实例 | SRC-BUCKET 已含，不另计采购 | 源几何参考；材料/功能未全验 | DISK_20261011_bm4_valve_seat.SLDPRT
7 | bm4_tube_adapter | 保留原件 | 1 | 成套内实例 | SRC-BUCKET 已含，不另计采购 | 源几何参考；材料/功能未全验 | DISK_20261011_bm4_tube_adapter.SLDPRT
8 | bm4_flange_bolt | 保留原件 | 3 | 成套内实例 | SRC-BUCKET 已含，不另计采购 | 源几何参考；材料/功能未全验 | DISK_20261011_bm4_flange_bolt.SLDPRT
9 | bm4_flange_nut | 保留原件 | 3 | 成套内实例 | SRC-BUCKET 已含，不另计采购 | 源几何参考；材料/功能未全验 | DISK_20261011_bm4_flange_nut.SLDPRT
10 | bm4_seat_bolt | 保留原件 | 3 | 成套内实例 | SRC-BUCKET 已含，不另计采购 | 源几何参考；材料/功能未全验 | DISK_20261011_bm4_seat_bolt.SLDPRT
11 | bm4_poppet | 保留原件 | 1 | 成套内实例 | SRC-BUCKET 已含，不另计采购 | 源几何参考；材料/功能未全验 | DISK_20261011_bm4_poppet.SLDPRT
12 | bm4_stem | 保留原件 | 1 | 成套内实例 | SRC-BUCKET 已含，不另计采购 | 源几何参考；材料/功能未全验 | DISK_20261011_bm4_stem.SLDPRT
13 | bm4_steel_head | 保留原件 | 1 | 成套内实例 | SRC-BUCKET 已含，不另计采购 | 源几何参考；材料/功能未全验 | DISK_20261011_bm4_steel_head.SLDPRT
14 | bm4_drive_sleeve | 保留原件 | 1 | 成套内实例 | SRC-BUCKET 已含，不另计采购 | 源几何参考；材料/功能未全验 | DISK_20261011_bm4_drive_sleeve.SLDPRT
15 | bm4_rotary_spindle | 保留原件 | 1 | 成套内实例 | SRC-BUCKET 已含，不另计采购 | 源几何参考；材料/功能未全验 | DISK_20261011_bm4_rotary_spindle.SLDPRT
16 | bm4_rotary_coupler | 保留原件 | 1 | 成套内实例 | SRC-BUCKET 已含，不另计采购 | 源几何参考；材料/功能未全验 | DISK_20261011_bm4_rotary_coupler.SLDPRT
17 | bm4_stem_lower_wiper | 保留原件 | 1 | 成套内实例 | SRC-BUCKET 已含，不另计采购 | 源几何参考；材料/功能未全验 | DISK_20261011_bm4_stem_lower_wiper.SLDPRT
18 | bm4_spring_cap | 保留原件 | 1 | 成套内实例 | SRC-BUCKET 已含，不另计采购 | 源几何参考；材料/功能未全验 | DISK_20261011_bm4_spring_cap.SLDPRT
19 | bm4_spring_lower_washer | 保留原件 | 1 | 成套内实例 | SRC-BUCKET 已含，不另计采购 | 源几何参考；材料/功能未全验 | DISK_20261011_bm4_spring_lower_washer.SLDPRT
20 | bm4_spring_upper_washer | 保留原件 | 1 | 成套内实例 | SRC-BUCKET 已含，不另计采购 | 源几何参考；材料/功能未全验 | DISK_20261011_bm4_spring_upper_washer.SLDPRT
21 | bm4_return_spring | 保留原件 | 1 | 成套内实例 | SRC-BUCKET 已含，不另计采购 | 源几何参考；材料/功能未全验 | DISK_20261011_bm4_return_spring.SLDPRT
22 | bm4_lid | 替换为 B-A01 | 0 | 成套内实例 | SRC-BUCKET 已含，不另计采购 | 源文件保留 | DISK_20261011_bm4_lid.SLDPRT
23 | bm4_sleeve_bushing | 保留原件 | 1 | 成套内实例 | SRC-BUCKET 已含，不另计采购 | 源几何参考；材料/功能未全验 | DISK_20261011_bm4_sleeve_bushing.SLDPRT
24 | bm4_sleeve_lip_seal | 保留原件 | 1 | 成套内实例 | SRC-BUCKET 已含，不另计采购 | 源几何参考；材料/功能未全验 | DISK_20261011_bm4_sleeve_lip_seal.SLDPRT
25 | bm4_thrust_washer | 保留原件 | 1 | 成套内实例 | SRC-BUCKET 已含，不另计采购 | 源几何参考；材料/功能未全验 | DISK_20261011_bm4_thrust_washer.SLDPRT
26 | bm4_lower_thrust_washer | 保留原件 | 1 | 成套内实例 | SRC-BUCKET 已含，不另计采购 | 源几何参考；材料/功能未全验 | DISK_20261011_bm4_lower_thrust_washer.SLDPRT
27 | bm4_axial_retainer | 保留原件 | 1 | 成套内实例 | SRC-BUCKET 已含，不另计采购 | 源几何参考；材料/功能未全验 | DISK_20261011_bm4_axial_retainer.SLDPRT
28 | bm4_rotor_lower_nut | 保留原件 | 1 | 成套内实例 | SRC-BUCKET 已含，不另计采购 | 源几何参考；材料/功能未全验 | DISK_20261011_bm4_rotor_lower_nut.SLDPRT
29 | bm4_rotor_upper_nut | 保留原件 | 1 | 成套内实例 | SRC-BUCKET 已含，不另计采购 | 源几何参考；材料/功能未全验 | DISK_20261011_bm4_rotor_upper_nut.SLDPRT
30 | bm4_blade_screw | 保留原件 | 12 | 成套内实例 | SRC-BUCKET 已含，不另计采购 | 源几何参考；材料/功能未全验 | DISK_20261011_bm4_blade_screw.SLDPRT
31 | bm4_hopper_blade | 保留原件 | 2 | 成套内实例 | SRC-BUCKET 已含，不另计采购 | 源几何参考；材料/功能未全验 | DISK_20261011_bm4_hopper_blade.SLDPRT
32 | bm4_hopper_frame | 保留原件 | 2 | 成套内实例 | SRC-BUCKET 已含，不另计采购 | 源几何参考；材料/功能未全验 | DISK_20261011_bm4_hopper_frame.SLDPRT
33 | bm4_nozzle_blade | 保留原件 | 2 | 成套内实例 | SRC-BUCKET 已含，不另计采购 | 源几何参考；材料/功能未全验 | DISK_20261011_bm4_nozzle_blade.SLDPRT
34 | bm4_nozzle_frame | 保留原件 | 2 | 成套内实例 | SRC-BUCKET 已含，不另计采购 | 源几何参考；材料/功能未全验 | DISK_20261011_bm4_nozzle_frame.SLDPRT
35 | bm4_head_plate | 保留原件 | 1 | 成套内实例 | SRC-BUCKET 已含，不另计采购 | 源几何参考；材料/功能未全验 | DISK_20261011_bm4_head_plate.SLDPRT
36 | bm4_ball_plunger | 保留原件 | 3 | 成套内实例 | SRC-BUCKET 已含，不另计采购 | 源几何参考；材料/功能未全验 | DISK_20261011_bm4_ball_plunger.SLDPRT
37 | bm4_latch_ball | 保留原件 | 3 | 成套内实例 | SRC-BUCKET 已含，不另计采购 | 源几何参考；材料/功能未全验 | DISK_20261011_bm4_latch_ball.SLDPRT
38 | bm4_vent_adapter | 保留原件 | 1 | 成套内实例 | SRC-BUCKET 已含，不另计采购 | 源几何参考；材料/功能未全验 | DISK_20261011_bm4_vent_adapter.SLDPRT
39 | bm4_dock_lock_ring | 由 C 正锁夹具替换 | 0 | 成套内实例 | SRC-BUCKET 已含，不另计采购 | 源文件保留 | DISK_20261011_bm4_dock_lock_ring.SLDPRT
40 | bm4_dock_lock_toggle | 由 C 正锁夹具替换 | 0 | 成套内实例 | SRC-BUCKET 已含，不另计采购 | 源文件保留 | DISK_20261011_bm4_dock_lock_toggle.SLDPRT
41 | bm4_motor_23HS2065 | 保留原件 | 1 | 成套内实例 | SRC-BUCKET 已含，不另计采购 | 源几何参考；材料/功能未全验 | DISK_20261011_bm4_motor_23HS2065.SLDPRT
42 | bm4_motor_mount | 保留原件 | 1 | 成套内实例 | SRC-BUCKET 已含，不另计采购 | 源几何参考；材料/功能未全验 | DISK_20261011_bm4_motor_mount.SLDPRT
43 | bm4_motor_post | 保留原件 | 4 | 成套内实例 | SRC-BUCKET 已含，不另计采购 | 源几何参考；材料/功能未全验 | DISK_20261011_bm4_motor_post.SLDPRT
44 | bm4_motor_bolt | 保留原件 | 4 | 成套内实例 | SRC-BUCKET 已含，不另计采购 | 源几何参考；材料/功能未全验 | DISK_20261011_bm4_motor_bolt.SLDPRT
45 | bm4_motor_nut | 保留原件 | 4 | 成套内实例 | SRC-BUCKET 已含，不另计采购 | 源几何参考；材料/功能未全验 | DISK_20261011_bm4_motor_nut.SLDPRT
46 | bm4_floating_jaw | 保留原件 | 1 | 成套内实例 | SRC-BUCKET 已含，不另计采购 | 源几何参考；材料/功能未全验 | DISK_20261011_bm4_floating_jaw.SLDPRT
47 | bm4_motor_clamp | 保留原件 | 1 | 成套内实例 | SRC-BUCKET 已含，不另计采购 | 源几何参考；材料/功能未全验 | DISK_20261011_bm4_motor_clamp.SLDPRT
48 | bm4_clamp_bolt | 保留原件 | 1 | 成套内实例 | SRC-BUCKET 已含，不另计采购 | 源几何参考；材料/功能未全验 | DISK_20261011_bm4_clamp_bolt.SLDPRT
49 | bm4_clamp_nut | 保留原件 | 1 | 成套内实例 | SRC-BUCKET 已含，不另计采购 | 源几何参考；材料/功能未全验 | DISK_20261011_bm4_clamp_nut.SLDPRT
50 | bm4_guide_pin | 保留原件 | 3 | 成套内实例 | SRC-BUCKET 已含，不另计采购 | 源几何参考；材料/功能未全验 | DISK_20261011_bm4_guide_pin.SLDPRT
51 | bm4_jaw_spring | 保留原件 | 3 | 成套内实例 | SRC-BUCKET 已含，不另计采购 | 源几何参考；材料/功能未全验 | DISK_20261011_bm4_jaw_spring.SLDPRT
52 | bm4_actuator_bridge | 保留原件 | 1 | 成套内实例 | SRC-BUCKET 已含，不另计采购 | 源几何参考；材料/功能未全验 | DISK_20261011_bm4_actuator_bridge.SLDPRT
53 | bm4_bridge_rail | 保留原件 | 2 | 成套内实例 | SRC-BUCKET 已含，不另计采购 | 源几何参考；材料/功能未全验 | DISK_20261011_bm4_bridge_rail.SLDPRT
54 | bm4_bridge_bolt | 保留原件 | 8 | 成套内实例 | SRC-BUCKET 已含，不另计采购 | 源几何参考；材料/功能未全验 | DISK_20261011_bm4_bridge_bolt.SLDPRT
55 | bm4_z_actuator | 保留原件 | 1 | 成套内实例 | SRC-BUCKET 已含，不另计采购 | 源几何参考；材料/功能未全验 | DISK_20261011_bm4_z_actuator.SLDPRT
56 | bm4_hopper_rod | 保留原件 | 1 | 成套内实例 | SRC-BUCKET 已含，不另计采购 | 源几何参考；材料/功能未全验 | DISK_20261011_bm4_hopper_rod.SLDPRT
57 | bm4_axial_rod_socket | 保留原件 | 1 | 成套内实例 | SRC-BUCKET 已含，不另计采购 | 源几何参考；材料/功能未全验 | DISK_20261011_bm4_axial_rod_socket.SLDPRT
58 | bm4_actuator_rod | 保留原件 | 1 | 成套内实例 | SRC-BUCKET 已含，不另计采购 | 源几何参考；材料/功能未全验 | DISK_20261011_bm4_actuator_rod.SLDPRT
59 | bm4_ring_lock_screw | 保留原件 | 3 | 成套内实例 | SRC-BUCKET 已含，不另计采购 | 源几何参考；材料/功能未全验 | DISK_20261011_bm4_ring_lock_screw.SLDPRT
