Kaihongho/Powder_model_design/粉桶图纸与说明/PB15_BOM与待确认参数.xlsx

Sheet: 全分件BOM
PB15 粉桶装置分件 BOM
每行代表一个组件实例，数量均为1。多实体采购组件仍按1个组件计；各装配共用分件不重复累加。
组件实例合计 |  | 237 | 本轮日期 | 2026-10-15T00:00:00.000Z
来源：本轮冻结分件清单；旧BOM仅补充名称。文件列为相对此工作簿目录的路径，材料状态以E列为准。
分组 | 件号／实例 | 数量 | 名称／用途 | 材料及确认状态 | 来源 | STEP文件 | SLDPRT文件
T2接口承载结构 | T2_B_locator_-31_-31 | 1 | EQC20-B定位套 | 待确认：原件材料、牌号与表面处理 | 沿用 T214/PB12 分件 | ..\CAD\STEP\parts\T2_B_locator_-31_-31.step | ..\CAD\SolidWorks\parts\N15_T2_B_locator_-31_-31.SLDPRT
T2接口承载结构 | T2_B_locator_31_31 | 1 | EQC20-B定位套 | 待确认：原件材料、牌号与表面处理 | 沿用 T214/PB12 分件 | ..\CAD\STEP\parts\T2_B_locator_31_31.step | ..\CAD\SolidWorks\parts\N15_T2_B_locator_31_31.SLDPRT
T2接口承载结构 | T2_EQC20_B | 1 | EQC20-B快换工具侧 | 待确认：原件材料、牌号与表面处理 | 沿用 T214/PB12 分件 | ..\CAD\STEP\parts\T2_EQC20_B.step | ..\CAD\SolidWorks\parts\N15_T2_EQC20_B.SLDPRT
T2接口承载结构 | T2_presence_target | 1 | 工具在位钢靶块 | 待确认：原件材料、牌号与表面处理 | 沿用 T214/PB12 分件 | ..\CAD\STEP\parts\T2_presence_target.step | ..\CAD\SolidWorks\parts\N15_T2_presence_target.SLDPRT
T2接口承载结构 | T2_target_M4x16_10 | 1 | 工具在位靶M4×16螺钉 | 待确认：原件材料、牌号与表面处理 | 沿用 T214/PB12 分件 | ..\CAD\STEP\parts\T2_target_M4x16_10.step | ..\CAD\SolidWorks\parts\N15_T2_target_M4x16_10.SLDPRT
T2接口承载结构 | T2_target_M4x16_30 | 1 | 工具在位靶M4×16螺钉 | 待确认：原件材料、牌号与表面处理 | 沿用 T214/PB12 分件 | ..\CAD\STEP\parts\T2_target_M4x16_30.step | ..\CAD\SolidWorks\parts\N15_T2_target_M4x16_30.SLDPRT
T2接口承载结构 | T214_carrier | 1 | 加长T2承载架 | 候选：6061焊后加工；牌号与处理未冻结 | 沿用 T214/PB12 分件 | ..\CAD\STEP\parts\T214_carrier.step | ..\CAD\SolidWorks\parts\N15_T214_carrier.SLDPRT
T2接口承载结构 | T214_M6x25_-22_253 | 1 | M6×25圆柱头螺钉 | 候选：钢；牌号与处理未冻结 | 沿用 T214/PB12 分件 | ..\CAD\STEP\parts\T214_M6x25_-22_253.step | ..\CAD\SolidWorks\parts\N15_T214_M6x25_-22_253.SLDPRT
T2接口承载结构 | T214_M6x25_-22_308 | 1 | M6×25圆柱头螺钉 | 候选：钢；牌号与处理未冻结 | 沿用 T214/PB12 分件 | ..\CAD\STEP\parts\T214_M6x25_-22_308.step | ..\CAD\SolidWorks\parts\N15_T214_M6x25_-22_308.SLDPRT
T2接口承载结构 | T214_M6x25_22_253 | 1 | M6×25圆柱头螺钉 | 候选：钢；牌号与处理未冻结 | 沿用 T214/PB12 分件 | ..\CAD\STEP\parts\T214_M6x25_22_253.step | ..\CAD\SolidWorks\parts\N15_T214_M6x25_22_253.SLDPRT
T2接口承载结构 | T214_M6x25_22_308 | 1 | M6×25圆柱头螺钉 | 候选：钢；牌号与处理未冻结 | 沿用 T214/PB12 分件 | ..\CAD\STEP\parts\T214_M6x25_22_308.step | ..\CAD\SolidWorks\parts\N15_T214_M6x25_22_308.SLDPRT
T2接口承载结构 | T214_nut_-22_253 | 1 | 螺母 | 候选：钢；牌号与处理未冻结 | 沿用 T214/PB12 分件 | ..\CAD\STEP\parts\T214_nut_-22_253.step | ..\CAD\SolidWorks\parts\N15_T214_nut_-22_253.SLDPRT
T2接口承载结构 | T214_nut_-22_308 | 1 | 螺母 | 候选：钢；牌号与处理未冻结 | 沿用 T214/PB12 分件 | ..\CAD\STEP\parts\T214_nut_-22_308.step | ..\CAD\SolidWorks\parts\N15_T214_nut_-22_308.SLDPRT
T2接口承载结构 | T214_nut_22_253 | 1 | 螺母 | 候选：钢；牌号与处理未冻结 | 沿用 T214/PB12 分件 | ..\CAD\STEP\parts\T214_nut_22_253.step | ..\CAD\SolidWorks\parts\N15_T214_nut_22_253.SLDPRT
T2接口承载结构 | T214_nut_22_308 | 1 | 螺母 | 候选：钢；牌号与处理未冻结 | 沿用 T214/PB12 分件 | ..\CAD\STEP\parts\T214_nut_22_308.step | ..\CAD\SolidWorks\parts\N15_T214_nut_22_308.SLDPRT
T2接口承载结构 | T214_washer_-22_253 | 1 | 平垫圈 | 候选：钢；牌号与处理未冻结 | 沿用 T214/PB12 分件 | ..\CAD\STEP\parts\T214_washer_-22_253.step | ..\CAD\SolidWorks\parts\N15_T214_washer_-22_253.SLDPRT
T2接口承载结构 | T214_washer_-22_308 | 1 | 平垫圈 | 候选：钢；牌号与处理未冻结 | 沿用 T214/PB12 分件 | ..\CAD\STEP\parts\T214_washer_-22_308.step | ..\CAD\SolidWorks\parts\N15_T214_washer_-22_308.SLDPRT
T2接口承载结构 | T214_washer_22_253 | 1 | 平垫圈 | 候选：钢；牌号与处理未冻结 | 沿用 T214/PB12 分件 | ..\CAD\STEP\parts\T214_washer_22_253.step | ..\CAD\SolidWorks\parts\N15_T214_washer_22_253.SLDPRT
T2接口承载结构 | T214_washer_22_308 | 1 | 平垫圈 | 候选：钢；牌号与处理未冻结 | 沿用 T214/PB12 分件 | ..\CAD\STEP\parts\T214_washer_22_308.step | ..\CAD\SolidWorks\parts\N15_T214_washer_22_308.SLDPRT
上部驱动及夹持 | CL_C-A01_head_capture_and_rear_bracket | 1 | 机头承托环与M8探头支架 | 待确认：原件材料、牌号与表面处理 | 沿用 T214/PB12 分件 | ..\CAD\STEP\parts\CL_C-A01_head_capture_and_rear_bracket.step | ..\CAD\SolidWorks\parts\N15_CL_C-A01_head_capture_and_rear_bracket.SLDPRT
上部驱动及夹持 | CL_C-A02_head_capture_cap | 1 | 机头承托上盖 | 待确认：原件材料、牌号与表面处理 | 沿用 T214/PB12 分件 | ..\CAD\STEP\parts\CL_C-A02_head_capture_cap.step | ..\CAD\SolidWorks\parts\N15_CL_C-A02_head_capture_cap.SLDPRT
上部驱动及夹持 | CL_C-A03_positive_capture_finger_-1 | 1 | T2正向托钩 | 待确认：原件材料、牌号与表面处理 | 沿用 T214/PB12 分件 | ..\CAD\STEP\parts\CL_C-A03_positive_capture_finger_-1.step | ..\CAD\SolidWorks\parts\N15_CL_C-A03_positive_capture_finger_-1.SLDPRT
上部驱动及夹持 | CL_C-A03_positive_capture_finger_1 | 1 | T2正向托钩 | 待确认：原件材料、牌号与表面处理 | 沿用 T214/PB12 分件 | ..\CAD\STEP\parts\CL_C-A03_positive_capture_finger_1.step | ..\CAD\SolidWorks\parts\N15_CL_C-A03_positive_capture_finger_1.SLDPRT
上部驱动及夹持 | CL_C-F01_cap_M3x18_0 | 1 | M3×18圆柱头螺钉 | 待确认：原件材料、牌号与表面处理 | 沿用 T214/PB12 分件 | ..\CAD\STEP\parts\CL_C-F01_cap_M3x18_0.step | ..\CAD\SolidWorks\parts\N15_CL_C-F01_cap_M3x18_0.SLDPRT
上部驱动及夹持 | CL_C-F01_cap_M3x18_1 | 1 | M3×18圆柱头螺钉 | 待确认：原件材料、牌号与表面处理 | 沿用 T214/PB12 分件 | ..\CAD\STEP\parts\CL_C-F01_cap_M3x18_1.step | ..\CAD\SolidWorks\parts\N15_CL_C-F01_cap_M3x18_1.SLDPRT
上部驱动及夹持 | CL_C-F01_cap_M3x18_2 | 1 | M3×18圆柱头螺钉 | 待确认：原件材料、牌号与表面处理 | 沿用 T214/PB12 分件 | ..\CAD\STEP\parts\CL_C-F01_cap_M3x18_2.step | ..\CAD\SolidWorks\parts\N15_CL_C-F01_cap_M3x18_2.SLDPRT
上部驱动及夹持 | CL_C-F01_cap_M3x18_3 | 1 | M3×18圆柱头螺钉 | 待确认：原件材料、牌号与表面处理 | 沿用 T214/PB12 分件 | ..\CAD\STEP\parts\CL_C-F01_cap_M3x18_3.step | ..\CAD\SolidWorks\parts\N15_CL_C-F01_cap_M3x18_3.SLDPRT
上部驱动及夹持 | CL_C-F02_GEP_M3x10_-8 | 1 | M3×10圆柱头螺钉 | 待确认：原件材料、牌号与表面处理 | 沿用 T214/PB12 分件 | ..\CAD\STEP\parts\CL_C-F02_GEP_M3x10_-8.step | ..\CAD\SolidWorks\parts\N15_CL_C-F02_GEP_M3x10_-8.SLDPRT
上部驱动及夹持 | CL_C-F02_GEP_M3x10_8 | 1 | M3×10圆柱头螺钉 | 待确认：原件材料、牌号与表面处理 | 沿用 T214/PB12 分件 | ..\CAD\STEP\parts\CL_C-F02_GEP_M3x10_8.step | ..\CAD\SolidWorks\parts\N15_CL_C-F02_GEP_M3x10_8.SLDPRT
上部驱动及夹持 | CL_C-F03_GEP_D5_sleeve_-8 | 1 | 定位套 | 待确认：原件材料、牌号与表面处理 | 沿用 T214/PB12 分件 | ..\CAD\STEP\parts\CL_C-F03_GEP_D5_sleeve_-8.step | ..\CAD\SolidWorks\parts\N15_CL_C-F03_GEP_D5_sleeve_-8.SLDPRT
上部驱动及夹持 | CL_C-F03_GEP_D5_sleeve_8 | 1 | 定位套 | 待确认：原件材料、牌号与表面处理 | 沿用 T214/PB12 分件 | ..\CAD\STEP\parts\CL_C-F03_GEP_D5_sleeve_8.step | ..\CAD\SolidWorks\parts\N15_CL_C-F03_GEP_D5_sleeve_8.SLDPRT
上部驱动及夹持 | CL_C-F05_finger_M3x10_-1_0 | 1 | M3×10圆柱头螺钉 | 待确认：原件材料、牌号与表面处理 | 沿用 T214/PB12 分件 | ..\CAD\STEP\parts\CL_C-F05_finger_M3x10_-1_0.step | ..\CAD\SolidWorks\parts\N15_CL_C-F05_finger_M3x10_-1_0.SLDPRT
上部驱动及夹持 | CL_C-F05_finger_M3x10_-1_1 | 1 | M3×10圆柱头螺钉 | 待确认：原件材料、牌号与表面处理 | 沿用 T214/PB12 分件 | ..\CAD\STEP\parts\CL_C-F05_finger_M3x10_-1_1.step | ..\CAD\SolidWorks\parts\N15_CL_C-F05_finger_M3x10_-1_1.SLDPRT
上部驱动及夹持 | CL_C-F05_finger_M3x10_1_0 | 1 | M3×10圆柱头螺钉 | 待确认：原件材料、牌号与表面处理 | 沿用 T214/PB12 分件 | ..\CAD\STEP\parts\CL_C-F05_finger_M3x10_1_0.step | ..\CAD\SolidWorks\parts\N15_CL_C-F05_finger_M3x10_1_0.SLDPRT
上部驱动及夹持 | CL_C-F05_finger_M3x10_1_1 | 1 | M3×10圆柱头螺钉 | 待确认：原件材料、牌号与表面处理 | 沿用 T214/PB12 分件 | ..\CAD\STEP\parts\CL_C-F05_finger_M3x10_1_1.step | ..\CAD\SolidWorks\parts\N15_CL_C-F05_finger_M3x10_1_1.SLDPRT
上部驱动及夹持 | CL_C-F06_finger_D5_sleeve_-1_0 | 1 | 定位套 | 待确认：原件材料、牌号与表面处理 | 沿用 T214/PB12 分件 | ..\CAD\STEP\parts\CL_C-F06_finger_D5_sleeve_-1_0.step | ..\CAD\SolidWorks\parts\N15_CL_C-F06_finger_D5_sleeve_-1_0.SLDPRT
上部驱动及夹持 | CL_C-F06_finger_D5_sleeve_-1_1 | 1 | 定位套 | 待确认：原件材料、牌号与表面处理 | 沿用 T214/PB12 分件 | ..\CAD\STEP\parts\CL_C-F06_finger_D5_sleeve_-1_1.step | ..\CAD\SolidWorks\parts\N15_CL_C-F06_finger_D5_sleeve_-1_1.SLDPRT
上部驱动及夹持 | CL_C-F06_finger_D5_sleeve_1_0 | 1 | 定位套 | 待确认：原件材料、牌号与表面处理 | 沿用 T214/PB12 分件 | ..\CAD\STEP\parts\CL_C-F06_finger_D5_sleeve_1_0.step | ..\CAD\SolidWorks\parts\N15_CL_C-F06_finger_D5_sleeve_1_0.SLDPRT
上部驱动及夹持 | CL_C-F06_finger_D5_sleeve_1_1 | 1 | 定位套 | 待确认：原件材料、牌号与表面处理 | 沿用 T214/PB12 分件 | ..\CAD\STEP\parts\CL_C-F06_finger_D5_sleeve_1_1.step | ..\CAD\SolidWorks\parts\N15_CL_C-F06_finger_D5_sleeve_1_1.SLDPRT
上部驱动及夹持 | CL_C-F07_ISO4026_M6x12_anti_rotation | 1 | M6×12防转紧定螺钉 | 待确认：原件材料、牌号与表面处理 | 沿用 T214/PB12 分件 | ..\CAD\STEP\parts\CL_C-F07_ISO4026_M6x12_anti_rotation.step | ..\CAD\SolidWorks\parts\N15_CL_C-F07_ISO4026_M6x12_anti_rotation.SLDPRT
上部驱动及夹持 | CL_C-P01_GEP2006IL03_2D_INTERFACE | 1 | GEP2006IL-03-B电爪成套 | 待确认：原件材料、牌号与表面处理 | 沿用 T214/PB12 分件 | ..\CAD\STEP\parts\CL_C-P01_GEP2006IL03_2D_INTERFACE.step | ..\CAD\SolidWorks\parts\N15_CL_C-P01_GEP2006IL03_2D_INTERFACE.SLDPRT
上部驱动及夹持 | CL_C-P03_original_jaw_-1 | 1 | GEP原厂活动爪 | 待确认：原件材料、牌号与表面处理 | 沿用 T214/PB12 分件 | ..\CAD\STEP\parts\CL_C-P03_original_jaw_-1.step | ..\CAD\SolidWorks\parts\N15_CL_C-P03_original_jaw_-1.SLDPRT
上部驱动及夹持 | CL_C-P03_original_jaw_1 | 1 | GEP原厂活动爪 | 待确认：原件材料、牌号与表面处理 | 沿用 T214/PB12 分件 | ..\CAD\STEP\parts\CL_C-P03_original_jaw_1.step | ..\CAD\SolidWorks\parts\N15_CL_C-P03_original_jaw_1.SLDPRT
上部驱动及夹持 | CL_C14_IES215_M8_30_INTERFACE | 1 | IES215桶在位探头 | 待确认：原件材料、牌号与表面处理 | 沿用 T214/PB12 分件 | ..\CAD\STEP\parts\CL_C14_IES215_M8_30_INTERFACE.step | ..\CAD\SolidWorks\parts\N15_CL_C14_IES215_M8_30_INTERFACE.SLDPRT
上部驱动及夹持 | CL_C14_probe_M8_nut_inner | 1 | M8探头安装螺母 | 待确认：原件材料、牌号与表面处理 | 沿用 T214/PB12 分件 | ..\CAD\STEP\parts\CL_C14_probe_M8_nut_inner.step | ..\CAD\SolidWorks\parts\N15_CL_C14_probe_M8_nut_inner.SLDPRT
上部驱动及夹持 | CL_C14_probe_M8_nut_outer | 1 | M8探头安装螺母 | 待确认：原件材料、牌号与表面处理 | 沿用 T214/PB12 分件 | ..\CAD\STEP\parts\CL_C14_probe_M8_nut_outer.step | ..\CAD\SolidWorks\parts\N15_CL_C14_probe_M8_nut_outer.SLDPRT
上部驱动及夹持 | PB_actuator_bridge | 1 | 轴向上跨接板 | 待确认：原件材料、牌号与表面处理 | 沿用 T214/PB12 分件 | ..\CAD\STEP\parts\PB_actuator_bridge.step | ..\CAD\SolidWorks\parts\N15_PB_actuator_bridge.SLDPRT
上部驱动及夹持 | PB_ball_plunger_0 | 1 | 原球头柱塞 | 待确认：原件材料、牌号与表面处理 | 沿用 T214/PB12 分件 | ..\CAD\STEP\parts\PB_ball_plunger_0.step | ..\CAD\SolidWorks\parts\N15_PB_ball_plunger_0.SLDPRT
上部驱动及夹持 | PB_ball_plunger_120 | 1 | 原球头柱塞 | 待确认：原件材料、牌号与表面处理 | 沿用 T214/PB12 分件 | ..\CAD\STEP\parts\PB_ball_plunger_120.step | ..\CAD\SolidWorks\parts\N15_PB_ball_plunger_120.SLDPRT
上部驱动及夹持 | PB_ball_plunger_240 | 1 | 原球头柱塞 | 待确认：原件材料、牌号与表面处理 | 沿用 T214/PB12 分件 | ..\CAD\STEP\parts\PB_ball_plunger_240.step | ..\CAD\SolidWorks\parts\N15_PB_ball_plunger_240.SLDPRT
上部驱动及夹持 | PB_bridge_bolt_lower_0_0 | 1 | 上桥连接螺钉 | 待确认：原件材料、牌号与表面处理 | 沿用 T214/PB12 分件 | ..\CAD\STEP\parts\PB_bridge_bolt_lower_0_0.step | ..\CAD\SolidWorks\parts\N15_PB_bridge_bolt_lower_0_0.SLDPRT
上部驱动及夹持 | PB_bridge_bolt_lower_0_1 | 1 | 上桥连接螺钉 | 待确认：原件材料、牌号与表面处理 | 沿用 T214/PB12 分件 | ..\CAD\STEP\parts\PB_bridge_bolt_lower_0_1.step | ..\CAD\SolidWorks\parts\N15_PB_bridge_bolt_lower_0_1.SLDPRT
上部驱动及夹持 | PB_bridge_bolt_lower_1_0 | 1 | 上桥连接螺钉 | 待确认：原件材料、牌号与表面处理 | 沿用 T214/PB12 分件 | ..\CAD\STEP\parts\PB_bridge_bolt_lower_1_0.step | ..\CAD\SolidWorks\parts\N15_PB_bridge_bolt_lower_1_0.SLDPRT
上部驱动及夹持 | PB_bridge_bolt_lower_1_1 | 1 | 上桥连接螺钉 | 待确认：原件材料、牌号与表面处理 | 沿用 T214/PB12 分件 | ..\CAD\STEP\parts\PB_bridge_bolt_lower_1_1.step | ..\CAD\SolidWorks\parts\N15_PB_bridge_bolt_lower_1_1.SLDPRT
上部驱动及夹持 | PB_bridge_bolt_upper_0_0 | 1 | 上桥连接螺钉 | 待确认：原件材料、牌号与表面处理 | 沿用 T214/PB12 分件 | ..\CAD\STEP\parts\PB_bridge_bolt_upper_0_0.step | ..\CAD\SolidWorks\parts\N15_PB_bridge_bolt_upper_0_0.SLDPRT
上部驱动及夹持 | PB_bridge_bolt_upper_0_1 | 1 | 上桥连接螺钉 | 待确认：原件材料、牌号与表面处理 | 沿用 T214/PB12 分件 | ..\CAD\STEP\parts\PB_bridge_bolt_upper_0_1.step | ..\CAD\SolidWorks\parts\N15_PB_bridge_bolt_upper_0_1.SLDPRT
上部驱动及夹持 | PB_bridge_bolt_upper_1_0 | 1 | 上桥连接螺钉 | 待确认：原件材料、牌号与表面处理 | 沿用 T214/PB12 分件 | ..\CAD\STEP\parts\PB_bridge_bolt_upper_1_0.step | ..\CAD\SolidWorks\parts\N15_PB_bridge_bolt_upper_1_0.SLDPRT
上部驱动及夹持 | PB_bridge_bolt_upper_1_1 | 1 | 上桥连接螺钉 | 待确认：原件材料、牌号与表面处理 | 沿用 T214/PB12 分件 | ..\CAD\STEP\parts\PB_bridge_bolt_upper_1_1.step | ..\CAD\SolidWorks\parts\N15_PB_bridge_bolt_upper_1_1.SLDPRT
上部驱动及夹持 | PB_bridge_rail_0 | 1 | 上桥侧轨 | 待确认：原件材料、牌号与表面处理 | 沿用 T214/PB12 分件 | ..\CAD\STEP\parts\PB_bridge_rail_0.step | ..\CAD\SolidWorks\parts\N15_PB_bridge_rail_0.SLDPRT
上部驱动及夹持 | PB_bridge_rail_1 | 1 | 上桥侧轨 | 待确认：原件材料、牌号与表面处理 | 沿用 T214/PB12 分件 | ..\CAD\STEP\parts\PB_bridge_rail_1.step | ..\CAD\SolidWorks\parts\N15_PB_bridge_rail_1.SLDPRT
上部驱动及夹持 | PB_floating_jaw | 1 | 弹性浮动端面爪 | 待确认：原件材料、牌号与表面处理 | 沿用 T214/PB12 分件 | ..\CAD\STEP\parts\PB_floating_jaw.step | ..\CAD\SolidWorks\parts\N15_PB_floating_jaw.SLDPRT
上部驱动及夹持 | PB_guide_pin_0 | 1 | 浮动爪肩销 | 待确认：原件材料、牌号与表面处理 | 沿用 T214/PB12 分件 | ..\CAD\STEP\parts\PB_guide_pin_0.step | ..\CAD\SolidWorks\parts\N15_PB_guide_pin_0.SLDPRT
上部驱动及夹持 | PB_guide_pin_1 | 1 | 浮动爪肩销 | 待确认：原件材料、牌号与表面处理 | 沿用 T214/PB12 分件 | ..\CAD\STEP\parts\PB_guide_pin_1.step | ..\CAD\SolidWorks\parts\N15_PB_guide_pin_1.SLDPRT
上部驱动及夹持 | PB_guide_pin_2 | 1 | 浮动爪肩销 | 待确认：原件材料、牌号与表面处理 | 沿用 T214/PB12 分件 | ..\CAD\STEP\parts\PB_guide_pin_2.step | ..\CAD\SolidWorks\parts\N15_PB_guide_pin_2.SLDPRT
上部驱动及夹持 | PB_head_plate | 1 | 快换机头基板 | 待确认：原件材料、牌号与表面处理 | 沿用 T214/PB12 分件 | ..\CAD\STEP\parts\PB_head_plate.step | ..\CAD\SolidWorks\parts\N15_PB_head_plate.SLDPRT
上部驱动及夹持 | PB_jaw_spring_0 | 1 | 浮动爪弹簧 | 待确认：原件材料、牌号与表面处理 | 沿用 T214/PB12 分件 | ..\CAD\STEP\parts\PB_jaw_spring_0.step | ..\CAD\SolidWorks\parts\N15_PB_jaw_spring_0.SLDPRT
上部驱动及夹持 | PB_jaw_spring_1 | 1 | 浮动爪弹簧 | 待确认：原件材料、牌号与表面处理 | 沿用 T214/PB12 分件 | ..\CAD\STEP\parts\PB_jaw_spring_1.step | ..\CAD\SolidWorks\parts\N15_PB_jaw_spring_1.SLDPRT
上部驱动及夹持 | PB_jaw_spring_2 | 1 | 浮动爪弹簧 | 待确认：原件材料、牌号与表面处理 | 沿用 T214/PB12 分件 | ..\CAD\STEP\parts\PB_jaw_spring_2.step | ..\CAD\SolidWorks\parts\N15_PB_jaw_spring_2.SLDPRT
上部驱动及夹持 | PB_latch_ball_0 | 1 | 原定位球 | 待确认：原件材料、牌号与表面处理 | 沿用 T214/PB12 分件 | ..\CAD\STEP\parts\PB_latch_ball_0.step | ..\CAD\SolidWorks\parts\N15_PB_latch_ball_0.SLDPRT
上部驱动及夹持 | PB_latch_ball_120 | 1 | 原定位球 | 待确认：原件材料、牌号与表面处理 | 沿用 T214/PB12 分件 | ..\CAD\STEP\parts\PB_latch_ball_120.step | ..\CAD\SolidWorks\parts\N15_PB_latch_ball_120.SLDPRT
上部驱动及夹持 | PB_latch_ball_240 | 1 | 原定位球 | 待确认：原件材料、牌号与表面处理 | 沿用 T214/PB12 分件 | ..\CAD\STEP\parts\PB_latch_ball_240.step | ..\CAD\SolidWorks\parts\N15_PB_latch_ball_240.SLDPRT
上部驱动及夹持 | PB_motor_23HS2065 | 1 | 旋转步进电机23HS2065 | 待确认：原件材料、牌号与表面处理 | 沿用 T214/PB12 分件 | ..\CAD\STEP\parts\PB_motor_23HS2065.step | ..\CAD\SolidWorks\parts\N15_PB_motor_23HS2065.SLDPRT
上部驱动及夹持 | PB_motor_bolt_0 | 1 | 加长电机连接螺钉 | 待确认：原件材料、牌号与表面处理 | 沿用 T214/PB12 分件 | ..\CAD\STEP\parts\PB_motor_bolt_0.step | ..\CAD\SolidWorks\parts\N15_PB_motor_bolt_0.SLDPRT
上部驱动及夹持 | PB_motor_bolt_1 | 1 | 加长电机连接螺钉 | 待确认：原件材料、牌号与表面处理 | 沿用 T214/PB12 分件 | ..\CAD\STEP\parts\PB_motor_bolt_1.step | ..\CAD\SolidWorks\parts\N15_PB_motor_bolt_1.SLDPRT
上部驱动及夹持 | PB_motor_bolt_2 | 1 | 加长电机连接螺钉 | 待确认：原件材料、牌号与表面处理 | 沿用 T214/PB12 分件 | ..\CAD\STEP\parts\PB_motor_bolt_2.step | ..\CAD\SolidWorks\parts\N15_PB_motor_bolt_2.SLDPRT
上部驱动及夹持 | PB_motor_bolt_3 | 1 | 加长电机连接螺钉 | 待确认：原件材料、牌号与表面处理 | 沿用 T214/PB12 分件 | ..\CAD\STEP\parts\PB_motor_bolt_3.step | ..\CAD\SolidWorks\parts\N15_PB_motor_bolt_3.SLDPRT
上部驱动及夹持 | PB_motor_clamp | 1 | 加长开缝电机夹毂 | 待确认：原件材料、牌号与表面处理 | 沿用 T214/PB12 分件 | ..\CAD\STEP\parts\PB_motor_clamp.step | ..\CAD\SolidWorks\parts\N15_PB_motor_clamp.SLDPRT
上部驱动及夹持 | PB_motor_mount | 1 | 电机安装板 | 待确认：原件材料、牌号与表面处理 | 沿用 T214/PB12 分件 | ..\CAD\STEP\parts\PB_motor_mount.step | ..\CAD\SolidWorks\parts\N15_PB_motor_mount.SLDPRT
上部驱动及夹持 | PB_motor_nut_0 | 1 | 电机安装螺母 | 待确认：原件材料、牌号与表面处理 | 沿用 T214/PB12 分件 | ..\CAD\STEP\parts\PB_motor_nut_0.step | ..\CAD\SolidWorks\parts\N15_PB_motor_nut_0.SLDPRT
上部驱动及夹持 | PB_motor_nut_1 | 1 | 电机安装螺母 | 待确认：原件材料、牌号与表面处理 | 沿用 T214/PB12 分件 | ..\CAD\STEP\parts\PB_motor_nut_1.step | ..\CAD\SolidWorks\parts\N15_PB_motor_nut_1.SLDPRT
上部驱动及夹持 | PB_motor_nut_2 | 1 | 电机安装螺母 | 待确认：原件材料、牌号与表面处理 | 沿用 T214/PB12 分件 | ..\CAD\STEP\parts\PB_motor_nut_2.step | ..\CAD\SolidWorks\parts\N15_PB_motor_nut_2.SLDPRT
上部驱动及夹持 | PB_motor_nut_3 | 1 | 电机安装螺母 | 待确认：原件材料、牌号与表面处理 | 沿用 T214/PB12 分件 | ..\CAD\STEP\parts\PB_motor_nut_3.step | ..\CAD\SolidWorks\parts\N15_PB_motor_nut_3.SLDPRT
上部驱动及夹持 | PB_motor_post_0 | 1 | 加长电机隔柱 | 待确认：原件材料、牌号与表面处理 | 沿用 T214/PB12 分件 | ..\CAD\STEP\parts\PB_motor_post_0.step | ..\CAD\SolidWorks\parts\N15_PB_motor_post_0.SLDPRT
上部驱动及夹持 | PB_motor_post_1 | 1 | 加长电机隔柱 | 待确认：原件材料、牌号与表面处理 | 沿用 T214/PB12 分件 | ..\CAD\STEP\parts\PB_motor_post_1.step | ..\CAD\SolidWorks\parts\N15_PB_motor_post_1.SLDPRT
上部驱动及夹持 | PB_motor_post_2 | 1 | 加长电机隔柱 | 待确认：原件材料、牌号与表面处理 | 沿用 T214/PB12 分件 | ..\CAD\STEP\parts\PB_motor_post_2.step | ..\CAD\SolidWorks\parts\N15_PB_motor_post_2.SLDPRT
上部驱动及夹持 | PB_motor_post_3 | 1 | 加长电机隔柱 | 待确认：原件材料、牌号与表面处理 | 沿用 T214/PB12 分件 | ..\CAD\STEP\parts\PB_motor_post_3.step | ..\CAD\SolidWorks\parts\N15_PB_motor_post_3.SLDPRT
上部驱动及夹持 | PB_PB12_actuator_drawrod_M3 | 1 | M3一体拉杆 | 待确认：原件材料、牌号与表面处理 | 沿用 T214/PB12 分件 | ..\CAD\STEP\parts\PB_PB12_actuator_drawrod_M3.step | ..\CAD\SolidWorks\parts\N15_PB_PB12_actuator_drawrod_M3.SLDPRT
上部驱动及夹持 | PB_PB12_actuator_front_fork | 1 | L12前端叉 | 待确认：原件材料、牌号与表面处理 | 沿用 T214/PB12 分件 | ..\CAD\STEP\parts\PB_PB12_actuator_front_fork.step | ..\CAD\SolidWorks\parts\N15_PB_PB12_actuator_front_fork.SLDPRT
上部驱动及夹持 | PB_PB12_front_pin_locknut | 1 | 前端肩销锁母 | 待确认：原件材料、牌号与表面处理 | 沿用 T214/PB12 分件 | ..\CAD\STEP\parts\PB_PB12_front_pin_locknut.step | ..\CAD\SolidWorks\parts\N15_PB_PB12_front_pin_locknut.SLDPRT
上部驱动及夹持 | PB_PB12_front_shoulder_pin | 1 | 前端Ø4肩销 | 待确认：原件材料、牌号与表面处理 | 沿用 T214/PB12 分件 | ..\CAD\STEP\parts\PB_PB12_front_shoulder_pin.step | ..\CAD\SolidWorks\parts\N15_PB_PB12_front_shoulder_pin.SLDPRT
上部驱动及夹持 | PB_PB12_L12_fixed_01 | 1 | Actuonix L12-10-100-12-P | 待确认：原件材料、牌号与表面处理 | 沿用 T214/PB12 分件 | ..\CAD\STEP\parts\PB_PB12_L12_fixed_01.step | ..\CAD\SolidWorks\parts\N15_PB_PB12_L12_fixed_01.SLDPRT
上部驱动及夹持 | PB_PB12_L12_fixed_02 | 1 | Actuonix L12-10-100-12-P | 待确认：原件材料、牌号与表面处理 | 沿用 T214/PB12 分件 | ..\CAD\STEP\parts\PB_PB12_L12_fixed_02.step | ..\CAD\SolidWorks\parts\N15_PB_PB12_L12_fixed_02.SLDPRT
上部驱动及夹持 | PB_PB12_L12_fixed_03 | 1 | Actuonix L12-10-100-12-P | 待确认：原件材料、牌号与表面处理 | 沿用 T214/PB12 分件 | ..\CAD\STEP\parts\PB_PB12_L12_fixed_03.step | ..\CAD\SolidWorks\parts\N15_PB_PB12_L12_fixed_03.SLDPRT
上部驱动及夹持 | PB_PB12_L12_fixed_04 | 1 | Actuonix L12-10-100-12-P | 待确认：原件材料、牌号与表面处理 | 沿用 T214/PB12 分件 | ..\CAD\STEP\parts\PB_PB12_L12_fixed_04.step | ..\CAD\SolidWorks\parts\N15_PB_PB12_L12_fixed_04.SLDPRT
上部驱动及夹持 | PB_PB12_L12_fixed_05 | 1 | Actuonix L12-10-100-12-P | 待确认：原件材料、牌号与表面处理 | 沿用 T214/PB12 分件 | ..\CAD\STEP\parts\PB_PB12_L12_fixed_05.step | ..\CAD\SolidWorks\parts\N15_PB_PB12_L12_fixed_05.SLDPRT
上部驱动及夹持 | PB_PB12_L12_fixed_06 | 1 | Actuonix L12-10-100-12-P | 待确认：原件材料、牌号与表面处理 | 沿用 T214/PB12 分件 | ..\CAD\STEP\parts\PB_PB12_L12_fixed_06.step | ..\CAD\SolidWorks\parts\N15_PB_PB12_L12_fixed_06.SLDPRT
上部驱动及夹持 | PB_PB12_L12_fixed_07 | 1 | Actuonix L12-10-100-12-P | 待确认：原件材料、牌号与表面处理 | 沿用 T214/PB12 分件 | ..\CAD\STEP\parts\PB_PB12_L12_fixed_07.step | ..\CAD\SolidWorks\parts\N15_PB_PB12_L12_fixed_07.SLDPRT
上部驱动及夹持 | PB_PB12_L12_fixed_08 | 1 | Actuonix L12-10-100-12-P | 待确认：原件材料、牌号与表面处理 | 沿用 T214/PB12 分件 | ..\CAD\STEP\parts\PB_PB12_L12_fixed_08.step | ..\CAD\SolidWorks\parts\N15_PB_PB12_L12_fixed_08.SLDPRT
上部驱动及夹持 | PB_PB12_L12_fixed_12 | 1 | Actuonix L12-10-100-12-P | 待确认：原件材料、牌号与表面处理 | 沿用 T214/PB12 分件 | ..\CAD\STEP\parts\PB_PB12_L12_fixed_12.step | ..\CAD\SolidWorks\parts\N15_PB_PB12_L12_fixed_12.SLDPRT
上部驱动及夹持 | PB_PB12_L12_mount_M3_-6_-10 | 1 | L12桥架M3安装螺钉 | 待确认：原件材料、牌号与表面处理 | 沿用 T214/PB12 分件 | ..\CAD\STEP\parts\PB_PB12_L12_mount_M3_-6_-10.step | ..\CAD\SolidWorks\parts\N15_PB_PB12_L12_mount_M3_-6_-10.SLDPRT
上部驱动及夹持 | PB_PB12_L12_mount_M3_-6_10 | 1 | L12桥架M3安装螺钉 | 待确认：原件材料、牌号与表面处理 | 沿用 T214/PB12 分件 | ..\CAD\STEP\parts\PB_PB12_L12_mount_M3_-6_10.step | ..\CAD\SolidWorks\parts\N15_PB_PB12_L12_mount_M3_-6_10.SLDPRT
上部驱动及夹持 | PB_PB12_L12_mount_M3_6_-10 | 1 | L12桥架M3安装螺钉 | 待确认：原件材料、牌号与表面处理 | 沿用 T214/PB12 分件 | ..\CAD\STEP\parts\PB_PB12_L12_mount_M3_6_-10.step | ..\CAD\SolidWorks\parts\N15_PB_PB12_L12_mount_M3_6_-10.SLDPRT
上部驱动及夹持 | PB_PB12_L12_mount_M3_6_10 | 1 | L12桥架M3安装螺钉 | 待确认：原件材料、牌号与表面处理 | 沿用 T214/PB12 分件 | ..\CAD\STEP\parts\PB_PB12_L12_mount_M3_6_10.step | ..\CAD\SolidWorks\parts\N15_PB_PB12_L12_mount_M3_6_10.SLDPRT
上部驱动及夹持 | PB_PB12_L12_moving_09 | 1 | Actuonix L12-10-100-12-P | 待确认：原件材料、牌号与表面处理 | 沿用 T214/PB12 分件 | ..\CAD\STEP\parts\PB_PB12_L12_moving_09.step | ..\CAD\SolidWorks\parts\N15_PB_PB12_L12_moving_09.SLDPRT
上部驱动及夹持 | PB_PB12_L12_moving_10 | 1 | Actuonix L12-10-100-12-P | 待确认：原件材料、牌号与表面处理 | 沿用 T214/PB12 分件 | ..\CAD\STEP\parts\PB_PB12_L12_moving_10.step | ..\CAD\SolidWorks\parts\N15_PB_PB12_L12_moving_10.SLDPRT
上部驱动及夹持 | PB_PB12_L12_moving_11 | 1 | Actuonix L12-10-100-12-P | 待确认：原件材料、牌号与表面处理 | 沿用 T214/PB12 分件 | ..\CAD\STEP\parts\PB_PB12_L12_moving_11.step | ..\CAD\SolidWorks\parts\N15_PB_PB12_L12_moving_11.SLDPRT
上部驱动及夹持 | PB_PB12_L12_support_bridge | 1 | L12支承桥架 | 待确认：原件材料、牌号与表面处理 | 沿用 T214/PB12 分件 | ..\CAD\STEP\parts\PB_PB12_L12_support_bridge.step | ..\CAD\SolidWorks\parts\N15_PB_PB12_L12_support_bridge.SLDPRT
上部驱动及夹持 | PB_PB12_Magma_4130003 | 1 | Magma 4130003电磁铁 | 待确认：原件材料、牌号与表面处理 | 沿用 T214/PB12 分件 | ..\CAD\STEP\parts\PB_PB12_Magma_4130003.step | ..\CAD\SolidWorks\parts\N15_PB_PB12_Magma_4130003.SLDPRT
上部驱动及夹持 | PB_PB12_rear_pin_locknut | 1 | 后端肩销锁母 | 待确认：原件材料、牌号与表面处理 | 沿用 T214/PB12 分件 | ..\CAD\STEP\parts\PB_PB12_rear_pin_locknut.step | ..\CAD\SolidWorks\parts\N15_PB_PB12_rear_pin_locknut.SLDPRT
上部驱动及夹持 | PB_PB12_rear_shoulder_pin | 1 | 后端Ø4肩销 | 待确认：原件材料、牌号与表面处理 | 沿用 T214/PB12 分件 | ..\CAD\STEP\parts\PB_PB12_rear_shoulder_pin.step | ..\CAD\SolidWorks\parts\N15_PB_PB12_rear_shoulder_pin.SLDPRT
上部驱动及夹持 | PB_PB12_rear_spacing_sleeve_L | 1 | 后销定位隔套 | 待确认：原件材料、牌号与表面处理 | 沿用 T214/PB12 分件 | ..\CAD\STEP\parts\PB_PB12_rear_spacing_sleeve_L.step | ..\CAD\SolidWorks\parts\N15_PB_PB12_rear_spacing_sleeve_L.SLDPRT
上部驱动及夹持 | PB_PB12_rear_spacing_sleeve_R | 1 | 后销定位隔套 | 待确认：原件材料、牌号与表面处理 | 沿用 T214/PB12 分件 | ..\CAD\STEP\parts\PB_PB12_rear_spacing_sleeve_R.step | ..\CAD\SolidWorks\parts\N15_PB_PB12_rear_spacing_sleeve_R.SLDPRT
上部驱动及夹持 | PB_PB12_stationary_wire_tube | 1 | 静止绝缘穿线管 | 待确认：原件材料、牌号与表面处理 | 沿用 T214/PB12 分件 | ..\CAD\STEP\parts\PB_PB12_stationary_wire_tube.step | ..\CAD\SolidWorks\parts\N15_PB_PB12_stationary_wire_tube.SLDPRT
上部驱动及夹持 | PB_PB12_wire_tube_antirotation_pin | 1 | 穿线管Ø2防转销 | 待确认：原件材料、牌号与表面处理 | 沿用 T214/PB12 分件 | ..\CAD\STEP\parts\PB_PB12_wire_tube_antirotation_pin.step | ..\CAD\SolidWorks\parts\N15_PB_PB12_wire_tube_antirotation_pin.SLDPRT
上部驱动及夹持 | PB_PB12_wire_tube_M12_nut | 1 | 穿线管M12锁紧螺母 | 待确认：原件材料、牌号与表面处理 | 沿用 T214/PB12 分件 | ..\CAD\STEP\parts\PB_PB12_wire_tube_M12_nut.step | ..\CAD\SolidWorks\parts\N15_PB_PB12_wire_tube_M12_nut.SLDPRT
上部驱动及夹持 | PB_rotation_clamp_bolt_0 | 1 | 开缝夹毂M3夹紧螺钉 | 待确认：原件材料、牌号与表面处理 | 沿用 T214/PB12 分件 | ..\CAD\STEP\parts\PB_rotation_clamp_bolt_0.step | ..\CAD\SolidWorks\parts\N15_PB_rotation_clamp_bolt_0.SLDPRT
上部驱动及夹持 | PB_rotation_clamp_bolt_1 | 1 | 开缝夹毂M3夹紧螺钉 | 待确认：原件材料、牌号与表面处理 | 沿用 T214/PB12 分件 | ..\CAD\STEP\parts\PB_rotation_clamp_bolt_1.step | ..\CAD\SolidWorks\parts\N15_PB_rotation_clamp_bolt_1.SLDPRT
上部驱动及夹持 | PB_rotation_clamp_nut_0 | 1 | 开缝夹毂M3螺母 | 待确认：原件材料、牌号与表面处理 | 沿用 T214/PB12 分件 | ..\CAD\STEP\parts\PB_rotation_clamp_nut_0.step | ..\CAD\SolidWorks\parts\N15_PB_rotation_clamp_nut_0.SLDPRT
上部驱动及夹持 | PB_rotation_clamp_nut_1 | 1 | 开缝夹毂M3螺母 | 待确认：原件材料、牌号与表面处理 | 沿用 T214/PB12 分件 | ..\CAD\STEP\parts\PB_rotation_clamp_nut_1.step | ..\CAD\SolidWorks\parts\N15_PB_rotation_clamp_nut_1.SLDPRT
上部驱动及夹持 | PB_vent_adapter | 1 | 通气接口 | 待确认：原件材料、牌号与表面处理 | 沿用 T214/PB12 分件 | ..\CAD\STEP\parts\PB_vent_adapter.step | ..\CAD\SolidWorks\parts\N15_PB_vent_adapter.SLDPRT
下部可换粉桶 | CL_B14_steel_presence_target | 1 | 随桶低碳钢夹环靶 | 候选：低碳钢；牌号与处理未冻结 | 沿用 T214/PB12 分件 | ..\CAD\STEP\parts\CL_B14_steel_presence_target.step | ..\CAD\SolidWorks\parts\N15_CL_B14_steel_presence_target.SLDPRT
下部可换粉桶 | CL_B14_target_M3_nut | 1 | 钢靶M3螺母 | 待确认：原件材料、牌号与表面处理 | 沿用 T214/PB12 分件 | ..\CAD\STEP\parts\CL_B14_target_M3_nut.step | ..\CAD\SolidWorks\parts\N15_CL_B14_target_M3_nut.SLDPRT
下部可换粉桶 | CL_B14_target_M3x14 | 1 | 钢靶M3×14夹紧螺钉 | 待确认：原件材料、牌号与表面处理 | 沿用 T214/PB12 分件 | ..\CAD\STEP\parts\CL_B14_target_M3x14.step | ..\CAD\SolidWorks\parts\N15_CL_B14_target_M3x14.SLDPRT
下部可换粉桶 | PB_B-A01_lid_AUTO_SWAP_derived | 1 | 派生外耳上盖及衬套接口 | 待确认：原件材料、牌号与表面处理 | 沿用 T214/PB12 分件 | ..\CAD\STEP\parts\PB_B-A01_lid_AUTO_SWAP_derived.step | ..\CAD\SolidWorks\parts\N15_PB_B-A01_lid_AUTO_SWAP_derived.SLDPRT
下部可换粉桶 | PB_B-A02_bucket_tie_post_-1 | 1 | 随桶拉柱 | 待确认：原件材料、牌号与表面处理 | 沿用 T214/PB12 分件 | ..\CAD\STEP\parts\PB_B-A02_bucket_tie_post_-1.step | ..\CAD\SolidWorks\parts\N15_PB_B-A02_bucket_tie_post_-1.SLDPRT
下部可换粉桶 | PB_B-A02_bucket_tie_post_1 | 1 | 随桶拉柱 | 待确认：原件材料、牌号与表面处理 | 沿用 T214/PB12 分件 | ..\CAD\STEP\parts\PB_B-A02_bucket_tie_post_1.step | ..\CAD\SolidWorks\parts\N15_PB_B-A02_bucket_tie_post_1.SLDPRT
下部可换粉桶 | PB_B-A03_bucket_retention_foot_-1 | 1 | 随桶法兰保持托脚 | 待确认：原件材料、牌号与表面处理 | 沿用 T214/PB12 分件 | ..\CAD\STEP\parts\PB_B-A03_bucket_retention_foot_-1.step | ..\CAD\SolidWorks\parts\N15_PB_B-A03_bucket_retention_foot_-1.SLDPRT
下部可换粉桶 | PB_B-A03_bucket_retention_foot_1 | 1 | 随桶法兰保持托脚 | 待确认：原件材料、牌号与表面处理 | 沿用 T214/PB12 分件 | ..\CAD\STEP\parts\PB_B-A03_bucket_retention_foot_1.step | ..\CAD\SolidWorks\parts\N15_PB_B-A03_bucket_retention_foot_1.SLDPRT
下部可换粉桶 | PB_B-F01_flush_M3x10_-1 | 1 | 上盖M3×10沉头螺钉 | 待确认：原件材料、牌号与表面处理 | 沿用 T214/PB12 分件 | ..\CAD\STEP\parts\PB_B-F01_flush_M3x10_-1.step | ..\CAD\SolidWorks\parts\N15_PB_B-F01_flush_M3x10_-1.SLDPRT
下部可换粉桶 | PB_B-F01_flush_M3x10_1 | 1 | 上盖M3×10沉头螺钉 | 待确认：原件材料、牌号与表面处理 | 沿用 T214/PB12 分件 | ..\CAD\STEP\parts\PB_B-F01_flush_M3x10_1.step | ..\CAD\SolidWorks\parts\N15_PB_B-F01_flush_M3x10_1.SLDPRT
下部可换粉桶 | PB_B-F02_bottom_M3x12_-1 | 1 | 托脚M3×12圆柱头螺钉 | 待确认：原件材料、牌号与表面处理 | 沿用 T214/PB12 分件 | ..\CAD\STEP\parts\PB_B-F02_bottom_M3x12_-1.step | ..\CAD\SolidWorks\parts\N15_PB_B-F02_bottom_M3x12_-1.SLDPRT
下部可换粉桶 | PB_B-F02_bottom_M3x12_1 | 1 | 托脚M3×12圆柱头螺钉 | 待确认：原件材料、牌号与表面处理 | 沿用 T214/PB12 分件 | ..\CAD\STEP\parts\PB_B-F02_bottom_M3x12_1.step | ..\CAD\SolidWorks\parts\N15_PB_B-F02_bottom_M3x12_1.SLDPRT
下部可换粉桶 | PB_drive_sleeve | 1 | 双D传动圆套 | 待确认：原件材料、牌号与表面处理 | 本轮改型，基于原分件 | ..\CAD\STEP\parts\PB_drive_sleeve.step | ..\CAD\SolidWorks\parts\N15_PB_drive_sleeve_R1.SLDPRT
下部可换粉桶 | PB_flange_bolt_0 | 1 | 法兰连接螺钉 | 待确认：原件材料、牌号与表面处理 | 沿用 T214/PB12 分件 | ..\CAD\STEP\parts\PB_flange_bolt_0.step | ..\CAD\SolidWorks\parts\N15_PB_flange_bolt_0.SLDPRT
下部可换粉桶 | PB_flange_bolt_1 | 1 | 法兰连接螺钉 | 待确认：原件材料、牌号与表面处理 | 沿用 T214/PB12 分件 | ..\CAD\STEP\parts\PB_flange_bolt_1.step | ..\CAD\SolidWorks\parts\N15_PB_flange_bolt_1.SLDPRT
下部可换粉桶 | PB_flange_bolt_2 | 1 | 法兰连接螺钉 | 待确认：原件材料、牌号与表面处理 | 沿用 T214/PB12 分件 | ..\CAD\STEP\parts\PB_flange_bolt_2.step | ..\CAD\SolidWorks\parts\N15_PB_flange_bolt_2.SLDPRT
下部可换粉桶 | PB_flange_nut_0 | 1 | 法兰连接螺母 | 待确认：原件材料、牌号与表面处理 | 沿用 T214/PB12 分件 | ..\CAD\STEP\parts\PB_flange_nut_0.step | ..\CAD\SolidWorks\parts\N15_PB_flange_nut_0.SLDPRT
下部可换粉桶 | PB_flange_nut_1 | 1 | 法兰连接螺母 | 待确认：原件材料、牌号与表面处理 | 沿用 T214/PB12 分件 | ..\CAD\STEP\parts\PB_flange_nut_1.step | ..\CAD\SolidWorks\parts\N15_PB_flange_nut_1.SLDPRT
下部可换粉桶 | PB_flange_nut_2 | 1 | 法兰连接螺母 | 待确认：原件材料、牌号与表面处理 | 沿用 T214/PB12 分件 | ..\CAD\STEP\parts\PB_flange_nut_2.step | ..\CAD\SolidWorks\parts\N15_PB_flange_nut_2.SLDPRT
下部可换粉桶 | PB_hopper | 1 | 上粉仓 | 待确认：原件材料、牌号与表面处理 | 本轮改型，基于原分件 | ..\CAD\STEP\parts\PB_hopper.step | ..\CAD\SolidWorks\parts\N15_PB_hopper_R1.SLDPRT
下部可换粉桶 | PB_hopper_blade_0 | 1 | 粉仓可换刮片 | 316L 候选，按粉料兼容性确认；本设计为非接触清扫片 | 本轮改型，基于原分件 | ..\CAD\STEP\parts\PB_hopper_blade_0.step | ..\CAD\SolidWorks\parts\N15_PB_hopper_blade_0.SLDPRT
下部可换粉桶 | PB_hopper_blade_180 | 1 | 粉仓可换刮片 | 316L 候选，按粉料兼容性确认；本设计为非接触清扫片 | 本轮改型，基于原分件 | ..\CAD\STEP\parts\PB_hopper_blade_180.step | ..\CAD\SolidWorks\parts\N15_PB_hopper_blade_180.SLDPRT
下部可换粉桶 | PB_hopper_blade_screw_0_0 | 1 | 刮片安装螺钉 | 待确认：原件材料、牌号与表面处理 | 沿用 T214/PB12 分件 | ..\CAD\STEP\parts\PB_hopper_blade_screw_0_0.step | ..\CAD\SolidWorks\parts\N15_PB_hopper_blade_screw_0_0.SLDPRT
下部可换粉桶 | PB_hopper_blade_screw_0_1 | 1 | 刮片安装螺钉 | 待确认：原件材料、牌号与表面处理 | 沿用 T214/PB12 分件 | ..\CAD\STEP\parts\PB_hopper_blade_screw_0_1.step | ..\CAD\SolidWorks\parts\N15_PB_hopper_blade_screw_0_1.SLDPRT
下部可换粉桶 | PB_hopper_blade_screw_0_2 | 1 | 刮片安装螺钉 | 待确认：原件材料、牌号与表面处理 | 沿用 T214/PB12 分件 | ..\CAD\STEP\parts\PB_hopper_blade_screw_0_2.step | ..\CAD\SolidWorks\parts\N15_PB_hopper_blade_screw_0_2.SLDPRT
下部可换粉桶 | PB_hopper_blade_screw_180_0 | 1 | 刮片安装螺钉 | 待确认：原件材料、牌号与表面处理 | 沿用 T214/PB12 分件 | ..\CAD\STEP\parts\PB_hopper_blade_screw_180_0.step | ..\CAD\SolidWorks\parts\N15_PB_hopper_blade_screw_180_0.SLDPRT
下部可换粉桶 | PB_hopper_blade_screw_180_1 | 1 | 刮片安装螺钉 | 待确认：原件材料、牌号与表面处理 | 沿用 T214/PB12 分件 | ..\CAD\STEP\parts\PB_hopper_blade_screw_180_1.step | ..\CAD\SolidWorks\parts\N15_PB_hopper_blade_screw_180_1.SLDPRT
下部可换粉桶 | PB_hopper_blade_screw_180_2 | 1 | 刮片安装螺钉 | 待确认：原件材料、牌号与表面处理 | 沿用 T214/PB12 分件 | ..\CAD\STEP\parts\PB_hopper_blade_screw_180_2.step | ..\CAD\SolidWorks\parts\N15_PB_hopper_blade_screw_180_2.SLDPRT
下部可换粉桶 | PB_hopper_collar_bolt_0 | 1 | 粉仓夹毂M2合拢螺钉 | 待确认：原件材料、牌号与表面处理 | 沿用 T214/PB12 分件 | ..\CAD\STEP\parts\PB_hopper_collar_bolt_0.step | ..\CAD\SolidWorks\parts\N15_PB_hopper_collar_bolt_0.SLDPRT
下部可换粉桶 | PB_hopper_collar_bolt_1 | 1 | 粉仓夹毂M2合拢螺钉 | 待确认：原件材料、牌号与表面处理 | 沿用 T214/PB12 分件 | ..\CAD\STEP\parts\PB_hopper_collar_bolt_1.step | ..\CAD\SolidWorks\parts\N15_PB_hopper_collar_bolt_1.SLDPRT
下部可换粉桶 | PB_hopper_frame_0 | 1 | 粉仓刮架及分半夹毂 | 待确认：原件材料、牌号与表面处理 | 沿用 T214/PB12 分件 | ..\CAD\STEP\parts\PB_hopper_frame_0.step | ..\CAD\SolidWorks\parts\N15_PB_hopper_frame_0.SLDPRT
下部可换粉桶 | PB_hopper_frame_180 | 1 | 粉仓刮架及分半夹毂 | 待确认：原件材料、牌号与表面处理 | 沿用 T214/PB12 分件 | ..\CAD\STEP\parts\PB_hopper_frame_180.step | ..\CAD\SolidWorks\parts\N15_PB_hopper_frame_180.SLDPRT
下部可换粉桶 | PB_lower_thrust_washer | 1 | 下止推垫片 | 待确认：原件材料、牌号与表面处理 | 沿用 T214/PB12 分件 | ..\CAD\STEP\parts\PB_lower_thrust_washer.step | ..\CAD\SolidWorks\parts\N15_PB_lower_thrust_washer.SLDPRT
下部可换粉桶 | PB_mill_carrier | 1 | 磨芯外壳 | 待确认：原件材料、牌号与表面处理 | 沿用 T214/PB12 分件 | ..\CAD\STEP\parts\PB_mill_carrier.step | ..\CAD\SolidWorks\parts\N15_PB_mill_carrier.SLDPRT
下部可换粉桶 | PB_nozzle_blade_0 | 1 | 下锥可换刮片 | 316L 候选，按粉料兼容性确认；本设计为非接触清扫片 | 本轮改型，基于原分件 | ..\CAD\STEP\parts\PB_nozzle_blade_0.step | ..\CAD\SolidWorks\parts\N15_PB_nozzle_blade_0.SLDPRT
下部可换粉桶 | PB_nozzle_blade_180 | 1 | 下锥可换刮片 | 316L 候选，按粉料兼容性确认；本设计为非接触清扫片 | 本轮改型，基于原分件 | ..\CAD\STEP\parts\PB_nozzle_blade_180.step | ..\CAD\SolidWorks\parts\N15_PB_nozzle_blade_180.SLDPRT
下部可换粉桶 | PB_nozzle_blade_screw_0_0 | 1 | 刮片安装螺钉 | 待确认：原件材料、牌号与表面处理 | 沿用 T214/PB12 分件 | ..\CAD\STEP\parts\PB_nozzle_blade_screw_0_0.step | ..\CAD\SolidWorks\parts\N15_PB_nozzle_blade_screw_0_0.SLDPRT
下部可换粉桶 | PB_nozzle_blade_screw_0_1 | 1 | 刮片安装螺钉 | 待确认：原件材料、牌号与表面处理 | 沿用 T214/PB12 分件 | ..\CAD\STEP\parts\PB_nozzle_blade_screw_0_1.step | ..\CAD\SolidWorks\parts\N15_PB_nozzle_blade_screw_0_1.SLDPRT
下部可换粉桶 | PB_nozzle_blade_screw_0_2 | 1 | 刮片安装螺钉 | 待确认：原件材料、牌号与表面处理 | 沿用 T214/PB12 分件 | ..\CAD\STEP\parts\PB_nozzle_blade_screw_0_2.step | ..\CAD\SolidWorks\parts\N15_PB_nozzle_blade_screw_0_2.SLDPRT
下部可换粉桶 | PB_nozzle_blade_screw_180_0 | 1 | 刮片安装螺钉 | 待确认：原件材料、牌号与表面处理 | 沿用 T214/PB12 分件 | ..\CAD\STEP\parts\PB_nozzle_blade_screw_180_0.step | ..\CAD\SolidWorks\parts\N15_PB_nozzle_blade_screw_180_0.SLDPRT
下部可换粉桶 | PB_nozzle_blade_screw_180_1 | 1 | 刮片安装螺钉 | 待确认：原件材料、牌号与表面处理 | 沿用 T214/PB12 分件 | ..\CAD\STEP\parts\PB_nozzle_blade_screw_180_1.step | ..\CAD\SolidWorks\parts\N15_PB_nozzle_blade_screw_180_1.SLDPRT
下部可换粉桶 | PB_nozzle_blade_screw_180_2 | 1 | 刮片安装螺钉 | 待确认：原件材料、牌号与表面处理 | 沿用 T214/PB12 分件 | ..\CAD\STEP\parts\PB_nozzle_blade_screw_180_2.step | ..\CAD\SolidWorks\parts\N15_PB_nozzle_blade_screw_180_2.SLDPRT
下部可换粉桶 | PB_nozzle_collar_bolt_0 | 1 | 下锥夹毂M2合拢螺钉 | 待确认：原件材料、牌号与表面处理 | 沿用 T214/PB12 分件 | ..\CAD\STEP\parts\PB_nozzle_collar_bolt_0.step | ..\CAD\SolidWorks\parts\N15_PB_nozzle_collar_bolt_0.SLDPRT
下部可换粉桶 | PB_nozzle_collar_bolt_1 | 1 | 下锥夹毂M2合拢螺钉 | 待确认：原件材料、牌号与表面处理 | 沿用 T214/PB12 分件 | ..\CAD\STEP\parts\PB_nozzle_collar_bolt_1.step | ..\CAD\SolidWorks\parts\N15_PB_nozzle_collar_bolt_1.SLDPRT
下部可换粉桶 | PB_nozzle_frame_0 | 1 | 下锥刮架及分半夹毂 | 待确认：原件材料、牌号与表面处理 | 沿用 T214/PB12 分件 | ..\CAD\STEP\parts\PB_nozzle_frame_0.step | ..\CAD\SolidWorks\parts\N15_PB_nozzle_frame_0.SLDPRT
下部可换粉桶 | PB_nozzle_frame_180 | 1 | 下锥刮架及分半夹毂 | 待确认：原件材料、牌号与表面处理 | 沿用 T214/PB12 分件 | ..\CAD\STEP\parts\PB_nozzle_frame_180.step | ..\CAD\SolidWorks\parts\N15_PB_nozzle_frame_180.SLDPRT
下部可换粉桶 | PB_outlet_cone | 1 | 下锥桶 | 待确认：原件材料、牌号与表面处理 | 本轮改型，基于原分件 | ..\CAD\STEP\parts\PB_outlet_cone.step | ..\CAD\SolidWorks\parts\N15_PB_outlet_cone.SLDPRT
下部可换粉桶 | PB_PB12_armature_M2 | 1 | Ø12钢衔铁 | 待确认：原件材料、牌号与表面处理 | 本轮改型，基于原分件 | ..\CAD\STEP\parts\PB_PB12_armature_M2.step | ..\CAD\SolidWorks\parts\N15_PB_PB12_armature_M2.SLDPRT
下部可换粉桶 | PB_PB12_nozzle_seat_onepiece | 1 | 一体阀座插嘴 | 316L候选，内壁去毛刺/清洗；兼容性及薄壁耐用性待样机 | 本轮改型，基于原分件 | ..\CAD\STEP\parts\PB_PB12_nozzle_seat_onepiece.step | ..\CAD\SolidWorks\parts\N15_PB_PB12_nozzle_seat_onepiece.SLDPRT
下部可换粉桶 | PB_PB12_poppet_M2 | 1 | M2螺纹阀芯 | 316L候选 | 本轮改型，基于原分件 | ..\CAD\STEP\parts\PB_PB12_poppet_M2.step | ..\CAD\SolidWorks\parts\N15_PB_PB12_poppet_M2.SLDPRT
下部可换粉桶 | PB_PB12_return_spring | 1 | 定制阀杆回位弹簧 | 待确认：原件材料、牌号与表面处理 | 沿用 T214/PB12 分件 | ..\CAD\STEP\parts\PB_PB12_return_spring.step | ..\CAD\SolidWorks\parts\N15_PB_PB12_return_spring.SLDPRT
下部可换粉桶 | PB_PB12_shaft_retaining_ring_DIN471_6 | 1 | DIN471 6×0.7轴用挡圈 | 待确认：原件材料、牌号与表面处理 | 沿用 T214/PB12 分件 | ..\CAD\STEP\parts\PB_PB12_shaft_retaining_ring_DIN471_6.step | ..\CAD\SolidWorks\parts\N15_PB_PB12_shaft_retaining_ring_DIN471_6.SLDPRT
下部可换粉桶 | PB_PB12_spring_upper_washer | 1 | 上弹簧垫圈 | 待确认：原件材料、牌号与表面处理 | 沿用 T214/PB12 分件 | ..\CAD\STEP\parts\PB_PB12_spring_upper_washer.step | ..\CAD\SolidWorks\parts\N15_PB_PB12_spring_upper_washer.SLDPRT
下部可换粉桶 | PB_PB12_valve_stem | 1 | M2一体阀杆 | 待确认：原件材料、牌号与表面处理 | 沿用 T214/PB12 分件 | ..\CAD\STEP\parts\PB_PB12_valve_stem.step | ..\CAD\SolidWorks\parts\N15_PB_PB12_valve_stem.SLDPRT
下部可换粉桶 | PB_ring_burr | 1 | 定磨芯 | 待确认：原件材料、牌号与表面处理 | 沿用 T214/PB12 分件 | ..\CAD\STEP\parts\PB_ring_burr.step | ..\CAD\SolidWorks\parts\N15_PB_ring_burr.SLDPRT
下部可换粉桶 | PB_ring_lock_screw_0 | 1 | 定磨芯锁定螺钉 | 待确认：原件材料、牌号与表面处理 | 沿用 T214/PB12 分件 | ..\CAD\STEP\parts\PB_ring_lock_screw_0.step | ..\CAD\SolidWorks\parts\N15_PB_ring_lock_screw_0.SLDPRT
下部可换粉桶 | PB_ring_lock_screw_1 | 1 | 定磨芯锁定螺钉 | 待确认：原件材料、牌号与表面处理 | 沿用 T214/PB12 分件 | ..\CAD\STEP\parts\PB_ring_lock_screw_1.step | ..\CAD\SolidWorks\parts\N15_PB_ring_lock_screw_1.SLDPRT
下部可换粉桶 | PB_ring_lock_screw_2 | 1 | 定磨芯锁定螺钉 | 待确认：原件材料、牌号与表面处理 | 沿用 T214/PB12 分件 | ..\CAD\STEP\parts\PB_ring_lock_screw_2.step | ..\CAD\SolidWorks\parts\N15_PB_ring_lock_screw_2.SLDPRT
下部可换粉桶 | PB_rotor_burr | 1 | 双D孔动磨芯 | 待确认：原件材料、牌号与表面处理 | 沿用 T214/PB12 分件 | ..\CAD\STEP\parts\PB_rotor_burr.step | ..\CAD\SolidWorks\parts\N15_PB_rotor_burr.SLDPRT
下部可换粉桶 | PB_rotor_lower_nut | 1 | 下分半M6环螺母正半 | 待确认：原件材料、牌号与表面处理 | 沿用 T214/PB12 分件 | ..\CAD\STEP\parts\PB_rotor_lower_nut.step | ..\CAD\SolidWorks\parts\N15_PB_rotor_lower_nut.SLDPRT
下部可换粉桶 | PB_rotor_lower_nut_bolt_0 | 1 | 下分半环螺母M1.6合拢螺钉 | 不锈钢候选，实际紧固等级与锁母材料确认 | 本轮改型，基于原分件 | ..\CAD\STEP\parts\PB_rotor_lower_nut_bolt_0.step | ..\CAD\SolidWorks\parts\N15_PB_rotor_lower_nut_bolt_0.SLDPRT
下部可换粉桶 | PB_rotor_lower_nut_bolt_1 | 1 | 下分半环螺母M1.6合拢螺钉 | 不锈钢候选，实际紧固等级与锁母材料确认 | 本轮改型，基于原分件 | ..\CAD\STEP\parts\PB_rotor_lower_nut_bolt_1.step | ..\CAD\SolidWorks\parts\N15_PB_rotor_lower_nut_bolt_1.SLDPRT
下部可换粉桶 | PB_rotor_lower_nut_half_180 | 1 | 下分半M6环螺母负半 | 待确认：原件材料、牌号与表面处理 | 沿用 T214/PB12 分件 | ..\CAD\STEP\parts\PB_rotor_lower_nut_half_180.step | ..\CAD\SolidWorks\parts\N15_PB_rotor_lower_nut_half_180.SLDPRT
下部可换粉桶 | PB_rotor_upper_nut | 1 | 上分半M6环螺母正半 | 待确认：原件材料、牌号与表面处理 | 沿用 T214/PB12 分件 | ..\CAD\STEP\parts\PB_rotor_upper_nut.step | ..\CAD\SolidWorks\parts\N15_PB_rotor_upper_nut.SLDPRT
下部可换粉桶 | PB_rotor_upper_nut_bolt_0 | 1 | 上分半环螺母M1.6合拢螺钉 | 不锈钢候选，实际紧固等级与锁母材料确认 | 本轮改型，基于原分件 | ..\CAD\STEP\parts\PB_rotor_upper_nut_bolt_0.step | ..\CAD\SolidWorks\parts\N15_PB_rotor_upper_nut_bolt_0.SLDPRT
下部可换粉桶 | PB_rotor_upper_nut_bolt_1 | 1 | 上分半环螺母M1.6合拢螺钉 | 不锈钢候选，实际紧固等级与锁母材料确认 | 本轮改型，基于原分件 | ..\CAD\STEP\parts\PB_rotor_upper_nut_bolt_1.step | ..\CAD\SolidWorks\parts\N15_PB_rotor_upper_nut_bolt_1.SLDPRT
下部可换粉桶 | PB_rotor_upper_nut_half_180 | 1 | 上分半M6环螺母负半 | 待确认：原件材料、牌号与表面处理 | 沿用 T214/PB12 分件 | ..\CAD\STEP\parts\PB_rotor_upper_nut_half_180.step | ..\CAD\SolidWorks\parts\N15_PB_rotor_upper_nut_half_180.SLDPRT
下部可换粉桶 | PB_seat_bolt_0 | 1 | 阀座安装螺钉 | A4 不锈钢，实购按粉料兼容性确认 | 本轮改型，基于原分件 | ..\CAD\STEP\parts\PB_seat_bolt_0.step | ..\CAD\SolidWorks\parts\N15_PB_seat_bolt_0.SLDPRT
下部可换粉桶 | PB_seat_bolt_1 | 1 | 阀座安装螺钉 | A4 不锈钢，实购按粉料兼容性确认 | 本轮改型，基于原分件 | ..\CAD\STEP\parts\PB_seat_bolt_1.step | ..\CAD\SolidWorks\parts\N15_PB_seat_bolt_1.SLDPRT
下部可换粉桶 | PB_seat_bolt_2 | 1 | 阀座安装螺钉 | A4 不锈钢，实购按粉料兼容性确认 | 本轮改型，基于原分件 | ..\CAD\STEP\parts\PB_seat_bolt_2.step | ..\CAD\SolidWorks\parts\N15_PB_seat_bolt_2.SLDPRT
下部可换粉桶 | PB_sleeve_bushing | 1 | 传动套导向衬套 | 待确认：原件材料、牌号与表面处理 | 沿用 T214/PB12 分件 | ..\CAD\STEP\parts\PB_sleeve_bushing.step | ..\CAD\SolidWorks\parts\N15_PB_sleeve_bushing.SLDPRT
下部可换粉桶 | PB_sleeve_lip_seal | 1 | 传动套唇形密封 | 待确认：原件材料、牌号与表面处理 | 沿用 T214/PB12 分件 | ..\CAD\STEP\parts\PB_sleeve_lip_seal.step | ..\CAD\SolidWorks\parts\N15_PB_sleeve_lip_seal.SLDPRT
下部可换粉桶 | PB_spring_lower_washer | 1 | 阀杆下弹簧垫圈 | 待确认：原件材料、牌号与表面处理 | 沿用 T214/PB12 分件 | ..\CAD\STEP\parts\PB_spring_lower_washer.step | ..\CAD\SolidWorks\parts\N15_PB_spring_lower_washer.SLDPRT
下部可换粉桶 | PB_stem_lower_wiper | 1 | 阀杆下刮粉密封 | 待确认：原件材料、牌号与表面处理 | 沿用 T214/PB12 分件 | ..\CAD\STEP\parts\PB_stem_lower_wiper.step | ..\CAD\SolidWorks\parts\N15_PB_stem_lower_wiper.SLDPRT
下部可换粉桶 | PB_thrust_washer | 1 | 上止推垫片 | 待确认：原件材料、牌号与表面处理 | 沿用 T214/PB12 分件 | ..\CAD\STEP\parts\PB_thrust_washer.step | ..\CAD\SolidWorks\parts\N15_PB_thrust_washer.SLDPRT
下部可换粉桶 | PB15_refill_cap_M24x1 | 1 | 独立补粉口旋盖 | 316L候选, 与粉料兼容性待确认 | 本轮新设计 | ..\CAD\STEP\parts\PB15_refill_cap_M24x1.step | ..\CAD\SolidWorks\parts\N15_PB15_refill_cap_M24x1.SLDPRT
下部可换粉桶 | PB15_refill_flat_gasket_20p2x22p4 | 1 | 补粉口平密封垫 | 与粉料兼容的平垫材料待选, 1.0自由厚/0.8安装厚 | 本轮新设计 | ..\CAD\STEP\parts\PB15_refill_flat_gasket_20p2x22p4.step | ..\CAD\SolidWorks\parts\N15_PB15_refill_flat_gasket_20p2x22p4.SLDPRT
下部可换粉桶 | PB15_spring_cap_M5x0p5 | 1 | 可拆卸弹簧顶盖 M5×0.5 | 候选：316L；螺纹咬合与材料兼容性待确认 | 本轮新设计 | ..\CAD\STEP\parts\PB15_spring_cap_M5x0p5.step | ..\CAD\SolidWorks\parts\N15_PB15_spring_cap_M5x0p5.SLDPRT
独立电动停车座 | DOCK_D-A02_flange_support_seat | 1 | 下法兰承托环（PB12修订） | 待确认：原件材料、牌号与表面处理 | 沿用原停车座分件 | ..\CAD\STEP\parts\DOCK_D-A02_flange_support_seat.step | ..\CAD\SolidWorks\parts\N15_DOCK_D-A02_flange_support_seat.SLDPRT
独立电动停车座 | DOCK_D-A03_support_post_-1 | 1 | 停车座支柱 | 待确认：原件材料、牌号与表面处理 | 沿用原停车座分件 | ..\CAD\STEP\parts\DOCK_D-A03_support_post_-1.step | ..\CAD\SolidWorks\parts\N15_DOCK_D-A03_support_post_-1.SLDPRT
独立电动停车座 | DOCK_D-A03_support_post_1 | 1 | 停车座支柱 | 待确认：原件材料、牌号与表面处理 | 沿用原停车座分件 | ..\CAD\STEP\parts\DOCK_D-A03_support_post_1.step | ..\CAD\SolidWorks\parts\N15_DOCK_D-A03_support_post_1.SLDPRT
独立电动停车座 | DOCK_D-F01_top_M5x16_-1 | 1 | M5×16圆柱头螺钉 | 待确认：原件材料、牌号与表面处理 | 沿用原停车座分件 | ..\CAD\STEP\parts\DOCK_D-F01_top_M5x16_-1.step | ..\CAD\SolidWorks\parts\N15_DOCK_D-F01_top_M5x16_-1.SLDPRT
独立电动停车座 | DOCK_D-F01_top_M5x16_1 | 1 | M5×16圆柱头螺钉 | 待确认：原件材料、牌号与表面处理 | 沿用原停车座分件 | ..\CAD\STEP\parts\DOCK_D-F01_top_M5x16_1.step | ..\CAD\SolidWorks\parts\N15_DOCK_D-F01_top_M5x16_1.SLDPRT
独立电动停车座 | DOCK_D-F02_bottom_M5x16_-1 | 1 | M5×16圆柱头螺钉 | 待确认：原件材料、牌号与表面处理 | 沿用原停车座分件 | ..\CAD\STEP\parts\DOCK_D-F02_bottom_M5x16_-1.step | ..\CAD\SolidWorks\parts\N15_DOCK_D-F02_bottom_M5x16_-1.SLDPRT
独立电动停车座 | DOCK_D-F02_bottom_M5x16_1 | 1 | M5×16圆柱头螺钉 | 待确认：原件材料、牌号与表面处理 | 沿用原停车座分件 | ..\CAD\STEP\parts\DOCK_D-F02_bottom_M5x16_1.step | ..\CAD\SolidWorks\parts\N15_DOCK_D-F02_bottom_M5x16_1.SLDPRT
独立电动停车座 | DOCK_ED-A01_extended_flat_base | 1 | 电动停车座加长底板 | 待确认：原件材料、牌号与表面处理 | 沿用原停车座分件 | ..\CAD\STEP\parts\DOCK_ED-A01_extended_flat_base.step | ..\CAD\SolidWorks\parts\N15_DOCK_ED-A01_extended_flat_base.SLDPRT
独立电动停车座 | DOCK_ED-A02_GEP_L_support | 1 | 停车电爪一体L形支架 | 待确认：原件材料、牌号与表面处理 | 沿用原停车座分件 | ..\CAD\STEP\parts\DOCK_ED-A02_GEP_L_support.step | ..\CAD\SolidWorks\parts\N15_DOCK_ED-A02_GEP_L_support.SLDPRT
独立电动停车座 | DOCK_ED-A03_hold_down_finger_-1 | 1 | 停车防提保持指 | 待确认：原件材料、牌号与表面处理 | 沿用原停车座分件 | ..\CAD\STEP\parts\DOCK_ED-A03_hold_down_finger_-1.step | ..\CAD\SolidWorks\parts\N15_DOCK_ED-A03_hold_down_finger_-1.SLDPRT
独立电动停车座 | DOCK_ED-A03_hold_down_finger_1 | 1 | 停车防提保持指 | 待确认：原件材料、牌号与表面处理 | 沿用原停车座分件 | ..\CAD\STEP\parts\DOCK_ED-A03_hold_down_finger_1.step | ..\CAD\SolidWorks\parts\N15_DOCK_ED-A03_hold_down_finger_1.SLDPRT
独立电动停车座 | DOCK_ED-A04_dock_sensor_stand | 1 | 停车探头支架 | 待确认：原件材料、牌号与表面处理 | 沿用原停车座分件 | ..\CAD\STEP\parts\DOCK_ED-A04_dock_sensor_stand.step | ..\CAD\SolidWorks\parts\N15_DOCK_ED-A04_dock_sensor_stand.SLDPRT
独立电动停车座 | DOCK_ED-A05_0_2mm_adjustment_shim | 1 | 停车电爪0.2mm调整垫片 | 待确认：原件材料、牌号与表面处理 | 沿用原停车座分件 | ..\CAD\STEP\parts\DOCK_ED-A05_0_2mm_adjustment_shim.step | ..\CAD\SolidWorks\parts\N15_DOCK_ED-A05_0_2mm_adjustment_shim.SLDPRT
独立电动停车座 | DOCK_ED-F01_stand_M5x16_-28_-136 | 1 | M5×16圆柱头螺钉 | 待确认：原件材料、牌号与表面处理 | 沿用原停车座分件 | ..\CAD\STEP\parts\DOCK_ED-F01_stand_M5x16_-28_-136.step | ..\CAD\SolidWorks\parts\N15_DOCK_ED-F01_stand_M5x16_-28_-136.SLDPRT
独立电动停车座 | DOCK_ED-F01_stand_M5x16_-28_-80 | 1 | M5×16圆柱头螺钉 | 待确认：原件材料、牌号与表面处理 | 沿用原停车座分件 | ..\CAD\STEP\parts\DOCK_ED-F01_stand_M5x16_-28_-80.step | ..\CAD\SolidWorks\parts\N15_DOCK_ED-F01_stand_M5x16_-28_-80.SLDPRT
独立电动停车座 | DOCK_ED-F01_stand_M5x16_28_-136 | 1 | M5×16圆柱头螺钉 | 待确认：原件材料、牌号与表面处理 | 沿用原停车座分件 | ..\CAD\STEP\parts\DOCK_ED-F01_stand_M5x16_28_-136.step | ..\CAD\SolidWorks\parts\N15_DOCK_ED-F01_stand_M5x16_28_-136.SLDPRT
独立电动停车座 | DOCK_ED-F01_stand_M5x16_28_-80 | 1 | M5×16圆柱头螺钉 | 待确认：原件材料、牌号与表面处理 | 沿用原停车座分件 | ..\CAD\STEP\parts\DOCK_ED-F01_stand_M5x16_28_-80.step | ..\CAD\SolidWorks\parts\N15_DOCK_ED-F01_stand_M5x16_28_-80.SLDPRT
独立电动停车座 | DOCK_ED-F02_GEP_M3x10_-8 | 1 | M3×10圆柱头螺钉 | 待确认：原件材料、牌号与表面处理 | 沿用原停车座分件 | ..\CAD\STEP\parts\DOCK_ED-F02_GEP_M3x10_-8.step | ..\CAD\SolidWorks\parts\N15_DOCK_ED-F02_GEP_M3x10_-8.SLDPRT
独立电动停车座 | DOCK_ED-F02_GEP_M3x10_8 | 1 | M3×10圆柱头螺钉 | 待确认：原件材料、牌号与表面处理 | 沿用原停车座分件 | ..\CAD\STEP\parts\DOCK_ED-F02_GEP_M3x10_8.step | ..\CAD\SolidWorks\parts\N15_DOCK_ED-F02_GEP_M3x10_8.SLDPRT
独立电动停车座 | DOCK_ED-F03_GEP_D5_sleeve_-8 | 1 | 定位套 | 待确认：原件材料、牌号与表面处理 | 沿用原停车座分件 | ..\CAD\STEP\parts\DOCK_ED-F03_GEP_D5_sleeve_-8.step | ..\CAD\SolidWorks\parts\N15_DOCK_ED-F03_GEP_D5_sleeve_-8.SLDPRT
独立电动停车座 | DOCK_ED-F03_GEP_D5_sleeve_8 | 1 | 定位套 | 待确认：原件材料、牌号与表面处理 | 沿用原停车座分件 | ..\CAD\STEP\parts\DOCK_ED-F03_GEP_D5_sleeve_8.step | ..\CAD\SolidWorks\parts\N15_DOCK_ED-F03_GEP_D5_sleeve_8.SLDPRT
独立电动停车座 | DOCK_ED-F05_finger_M3x10_-1_0 | 1 | M3×10圆柱头螺钉 | 待确认：原件材料、牌号与表面处理 | 沿用原停车座分件 | ..\CAD\STEP\parts\DOCK_ED-F05_finger_M3x10_-1_0.step | ..\CAD\SolidWorks\parts\N15_DOCK_ED-F05_finger_M3x10_-1_0.SLDPRT
独立电动停车座 | DOCK_ED-F05_finger_M3x10_-1_1 | 1 | M3×10圆柱头螺钉 | 待确认：原件材料、牌号与表面处理 | 沿用原停车座分件 | ..\CAD\STEP\parts\DOCK_ED-F05_finger_M3x10_-1_1.step | ..\CAD\SolidWorks\parts\N15_DOCK_ED-F05_finger_M3x10_-1_1.SLDPRT
独立电动停车座 | DOCK_ED-F05_finger_M3x10_1_0 | 1 | M3×10圆柱头螺钉 | 待确认：原件材料、牌号与表面处理 | 沿用原停车座分件 | ..\CAD\STEP\parts\DOCK_ED-F05_finger_M3x10_1_0.step | ..\CAD\SolidWorks\parts\N15_DOCK_ED-F05_finger_M3x10_1_0.SLDPRT
独立电动停车座 | DOCK_ED-F05_finger_M3x10_1_1 | 1 | M3×10圆柱头螺钉 | 待确认：原件材料、牌号与表面处理 | 沿用原停车座分件 | ..\CAD\STEP\parts\DOCK_ED-F05_finger_M3x10_1_1.step | ..\CAD\SolidWorks\parts\N15_DOCK_ED-F05_finger_M3x10_1_1.SLDPRT
独立电动停车座 | DOCK_ED-F06_finger_D5_sleeve_-1_0 | 1 | 定位套 | 待确认：原件材料、牌号与表面处理 | 沿用原停车座分件 | ..\CAD\STEP\parts\DOCK_ED-F06_finger_D5_sleeve_-1_0.step | ..\CAD\SolidWorks\parts\N15_DOCK_ED-F06_finger_D5_sleeve_-1_0.SLDPRT
独立电动停车座 | DOCK_ED-F06_finger_D5_sleeve_-1_1 | 1 | 定位套 | 待确认：原件材料、牌号与表面处理 | 沿用原停车座分件 | ..\CAD\STEP\parts\DOCK_ED-F06_finger_D5_sleeve_-1_1.step | ..\CAD\SolidWorks\parts\N15_DOCK_ED-F06_finger_D5_sleeve_-1_1.SLDPRT
独立电动停车座 | DOCK_ED-F06_finger_D5_sleeve_1_0 | 1 | 定位套 | 待确认：原件材料、牌号与表面处理 | 沿用原停车座分件 | ..\CAD\STEP\parts\DOCK_ED-F06_finger_D5_sleeve_1_0.step | ..\CAD\SolidWorks\parts\N15_DOCK_ED-F06_finger_D5_sleeve_1_0.SLDPRT
独立电动停车座 | DOCK_ED-F06_finger_D5_sleeve_1_1 | 1 | 定位套 | 待确认：原件材料、牌号与表面处理 | 沿用原停车座分件 | ..\CAD\STEP\parts\DOCK_ED-F06_finger_D5_sleeve_1_1.step | ..\CAD\SolidWorks\parts\N15_DOCK_ED-F06_finger_D5_sleeve_1_1.SLDPRT
独立电动停车座 | DOCK_ED-F07_sensor_stand_M4x12_26 | 1 | 停车探头支架 | 待确认：原件材料、牌号与表面处理 | 沿用原停车座分件 | ..\CAD\STEP\parts\DOCK_ED-F07_sensor_stand_M4x12_26.step | ..\CAD\SolidWorks\parts\N15_DOCK_ED-F07_sensor_stand_M4x12_26.SLDPRT
独立电动停车座 | DOCK_ED-F07_sensor_stand_M4x12_6 | 1 | 停车探头支架 | 待确认：原件材料、牌号与表面处理 | 沿用原停车座分件 | ..\CAD\STEP\parts\DOCK_ED-F07_sensor_stand_M4x12_6.step | ..\CAD\SolidWorks\parts\N15_DOCK_ED-F07_sensor_stand_M4x12_6.SLDPRT
独立电动停车座 | DOCK_ED-F08_sensor_M8_nut_lower | 1 | M8探头安装螺母 | 待确认：原件材料、牌号与表面处理 | 沿用原停车座分件 | ..\CAD\STEP\parts\DOCK_ED-F08_sensor_M8_nut_lower.step | ..\CAD\SolidWorks\parts\N15_DOCK_ED-F08_sensor_M8_nut_lower.SLDPRT
独立电动停车座 | DOCK_ED-F08_sensor_M8_nut_upper | 1 | M8探头安装螺母 | 待确认：原件材料、牌号与表面处理 | 沿用原停车座分件 | ..\CAD\STEP\parts\DOCK_ED-F08_sensor_M8_nut_upper.step | ..\CAD\SolidWorks\parts\N15_DOCK_ED-F08_sensor_M8_nut_upper.SLDPRT
独立电动停车座 | DOCK_ED-P01_GEP2006IL03_2D_INTERFACE | 1 | GEP2006IL-03-B电爪成套 | 待确认：原件材料、牌号与表面处理 | 沿用原停车座分件 | ..\CAD\STEP\parts\DOCK_ED-P01_GEP2006IL03_2D_INTERFACE.step | ..\CAD\SolidWorks\parts\N15_DOCK_ED-P01_GEP2006IL03_2D_INTERFACE.SLDPRT
独立电动停车座 | DOCK_ED-P02_IES215_M8_30_2D_INTERFACE | 1 | IES215桶在位探头 | 待确认：原件材料、牌号与表面处理 | 沿用原停车座分件 | ..\CAD\STEP\parts\DOCK_ED-P02_IES215_M8_30_2D_INTERFACE.step | ..\CAD\SolidWorks\parts\N15_DOCK_ED-P02_IES215_M8_30_2D_INTERFACE.SLDPRT
独立电动停车座 | DOCK_ED-P03_original_jaw_-1 | 1 | GEP原厂活动爪 | 待确认：原件材料、牌号与表面处理 | 沿用原停车座分件 | ..\CAD\STEP\parts\DOCK_ED-P03_original_jaw_-1.step | ..\CAD\SolidWorks\parts\N15_DOCK_ED-P03_original_jaw_-1.SLDPRT
独立电动停车座 | DOCK_ED-P03_original_jaw_1 | 1 | GEP原厂活动爪 | 待确认：原件材料、牌号与表面处理 | 沿用原停车座分件 | ..\CAD\STEP\parts\DOCK_ED-P03_original_jaw_1.step | ..\CAD\SolidWorks\parts\N15_DOCK_ED-P03_original_jaw_1.SLDPRT
补粉与维护附件 | PB15_cap_pin_spanner | 1 | 顶盖双销维护工具 | 候选：可淬硬不锈钢工具材料；销强度须试制确认 | 本轮新设计 | ..\CAD\STEP\parts\PB15_cap_pin_spanner.step | ..\CAD\SolidWorks\parts\N15_PB15_cap_pin_spanner.SLDPRT
补粉与维护附件 | PB15_refill_funnel_20mm | 1 | 可取下补粉漏斗 | 316L候选, 清洁后人工补粉专用 | 本轮新设计 | ..\CAD\STEP\parts\PB15_refill_funnel_20mm.step | ..\CAD\SolidWorks\parts\N15_PB15_refill_funnel_20mm_R1.SLDPRT

Sheet: 待确认参数
待确认参数与试制记录
首版范围为常规干燥、非黏性粉末。暂无样机；黄色结果栏留待实际试制填写，设计值不等于实测值。
类别 | 项目 | 当前设计／已知情况 | 确认办法 | 实测／确认结果 | 状态 | 判定与后续
粉末适用性 | 粉末范围与代表料样 | 首版为常规干燥、非黏性粉末；无样机出粉结果 | 记录品种、批次、粒度、含水状态和研磨允许性，逐料样验证 |  | 待试制 | 超出首版范围的物料单独评估，不能外推为全类型防堵
粉末适用性 | 目标剂量与重复性 | 几 mg 至几百 mg 为试制目标，未测量误差 | 在目标剂量、不同料位下重复称量，记录误差、离散性与残留 |  | 待试制 | 由实际实验需求冻结合格限值与重复次数
粉末适用性 | 启停、低料位与堵塞 | 几何流道已设计，未完成粉体试验 | 满料、中料、低料位连续启停；记录不出粉、架桥、断流及解除方法 |  | 待试制 | 逐粉末给出通过范围，不能用空转代替粉体试验
粉末适用性 | 研磨与样品变化 | 保留原磨齿，软团聚解团为首版用途 | 比较研磨前后粒度、温升和样品性质，检测磨耗污染 |  | 待试制 | 不允许研磨的物料不得直接套用当前磨芯
传动与夹持 | 空桶及满载质量、重心 | 暂无样机实测数据 | 称量各模块与满载桶，测重心和最大偏心距 |  | 待实测 | 用于复核 Z 轴负载、制动和夹持承载
传动与夹持 | 启动、工作及卡滞扭矩 | 暂无实测扭矩与工作转速 | 使用代表料样测启动峰值、稳态与堵转趋势，记录转速和电流 |  | 待实测 | 据此确认电机余量及停机阈值
传动与夹持 | 旋转接头啮合与拔出力 | 有可分离传动接口，未测耐久与拔出力 | 检查错相对接、轴向浮动和重复拔插，测力并检查磨损 |  | 待试制 | 不得通过强拉或偏斜迫使机头脱开
传动与夹持 | 电动托钩保持与松开 | 夹持采用法兰托持，采购夹爪接口沿用 | 用真实夹爪和满载桶确认托持、开闭行程、重复位置及断电状态 |  | 待试制 | 确认真正抓住法兰后才允许停车保持指松开
传动与夹持 | 停车座保持与承托 | 停车座为独立装配，未测机头拔出工况 | 测支承、保持指捕获和拔机头时的桶位变化 |  | 待试制 | 桶受承托且停车保持确认后才允许上部开爪
出粉口开闭 | 阀杆行程、弹簧力与回位 | 当前为设计机构，暂无开闭实测 | 在干净和夹粉条件下测开启力、回位、关闭时间与重复性 |  | 待试制 | 运动前阀必须实际关闭，不能只用动作命令代替
出粉口开闭 | 磁接头拉力与剩磁 | 暂无热态、污染状态与断电实测 | 测冷态/热态/有粉尘时拉力，断电后检查分离和残余吸附 |  | 待试制 | 关阀及真实轴向分离均确认后才允许开爪
出粉口开闭 | 阀座夹粉泄漏 | 接触几何不能作为密封实测依据 | 关阀后静置与移动，测漏粉并检查夹粉、磨损和清洗后复位 |  | 待试制 | 依据最小目标剂量冻结允许漏粉量
制造尺寸 | 喷嘴流道与壁厚 | 名义阀孔 Ø6 mm，出口 Ø7.6 mm | 检验短阀孔、渐扩流道、薄壁、毛刺和装后同轴度 |  | 待确认 | 尺寸以本轮图纸为准，流动效果由料样试验确认
制造尺寸 | 刮片全周运行间隙 | 名义径向间隙 0.2 mm；单边径向总误差预算 0.08 mm；剩余径向目标≥0.12 mm、全周最小法向≥0.1 mm | 计入偏心、轴游隙、形状误差、挠度与热变形，实测全周最小间隙 |  | 待实测 | 非接触刮片不得擦壁，间隙不等于无残粉
制造尺寸 | 补粉口与旋盖螺纹 | M24×1 独立补粉口；螺纹为名义包络，未建螺旋牙型 | 通止规检查；确认至少7圈脱牙、累计轴退12 mm再上提40 mm可顺畅取下 |  | 待确认 | 螺纹公差、配合与去毛刺须制造方确认
材料与密封 | 补粉口平垫材料 | 自由厚 1 mm；安装厚 0.8 mm 为设计值 | 确认盖底与整体外止肩接触时平垫由1.0压到0.8 mm；检查兼容性、回弹、泄漏及重复拆装 |  | 待确认 | 平垫非防丢结构，补粉时须单独收好并检查
材料与密封 | 接粉金属、密封与涂层 | BOM 材料为候选或待核实，未形成最终材料规范 | 确认化学兼容、析出、磨耗、清洗与表面粗糙度要求 |  | 待确认 | 制造前冻结接粉材料和表面处理
材料与密封 | 磨芯材料与硬度 | 沿用原磨齿几何，材料与磨耗尚未验证 | 测硬度、磨耗、碎屑污染及研磨稳定性 |  | 待确认 | 不得把几何继承当作材料已定
电气与反馈 | 电源、驱动和快换穿通 | 针脚、容量与保护尚须按实际采购件确认 | 核对电机、夹爪、推杆、磁接头和传感器的电源及接口 |  | 待确认 | 冻结接线图、针脚分配、接地和过流保护
电气与反馈 | 三个关键实际状态反馈 | 阀实际关闭、磁接头实际分离、停车指实际捕获的硬件待落实 | 选定并安装反馈元件，逐项触发异常验证互锁 |  | 待确认 | 单一在位信号不能替代三个不同的机械状态
电气与反馈 | 失电与异常恢复 | 暂无整机断电试验 | 分别在抓取、运输、出粉和交接阶段断电及恢复，记录保持和关阀 |  | 待试制 | 验证桶不自由落下、阀关闭且恢复不会误释放
制造与维护 | 紧固等级、扭矩与防松 | 紧固件尺寸来源于模型，装配扭矩未实测冻结 | 结合基材、螺纹咬合和拆装频次确定并验证紧固要求 |  | 待确认 | M1.6 刮片连接、喷嘴连接和关键夹持连接需逐项确认
制造与维护 | 补粉容量、料位与清洗 | 补粉通路 Ø20 mm；CAD净腔体约23.09 mL，不等于可用装粉容量 | 标定可用容量，检查补粉后密封；拆洗后测残留及复装重复性 |  | 待试制 | 漏斗仅补粉时使用，自动抓取前移除并装好旋盖
制造与维护 | 弹簧顶盖与阀杆拆洗 | M5×0.5可拆顶盖；双销工具仅检修时使用 | 按维护说明释放弹簧预载、取下顶盖及内件，检查阀杆肩可退出并原位复装 |  | 待试制 | 双销维护工具不装入正常三主装配；复装后重新检验关闭与泄漏
