Kaihongho/Powder_model_design/cad/parts/main_leveling_feet.step

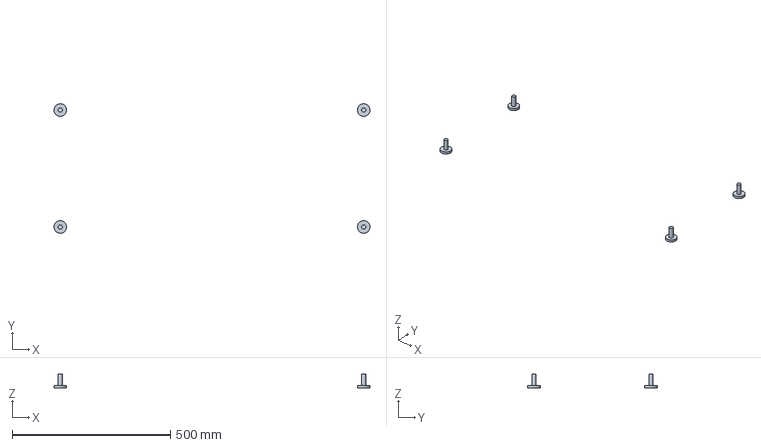
[picture p29: CAD file, 2026-10-09]
cad/parts/main_leveling_feet.step
1000.0 x 410.0 x 45.0 mm
