Kaihongho/Powder_model_design/cad/parts/main_lower_frame.step

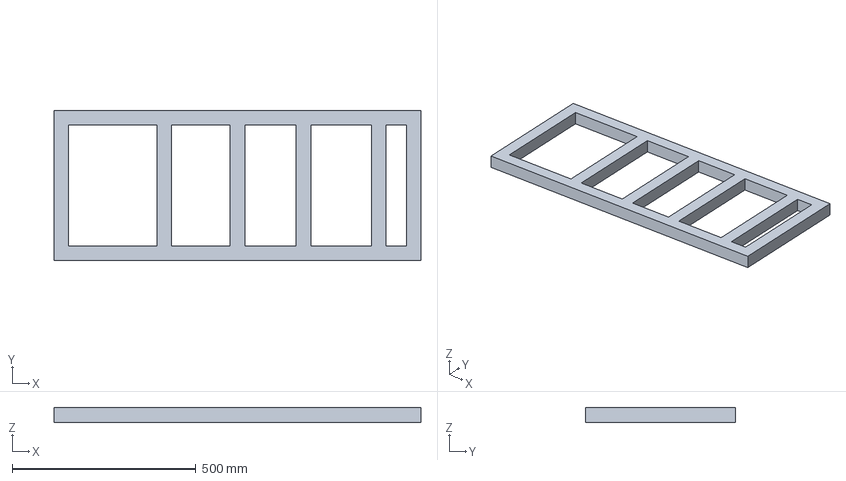
[picture p30: CAD file, 2026-10-09]
cad/parts/main_lower_frame.step
1000.0 x 410.0 x 40.0 mm
