Kaihongho/Powder_model_design/cad/parts/main_frame_risers.step

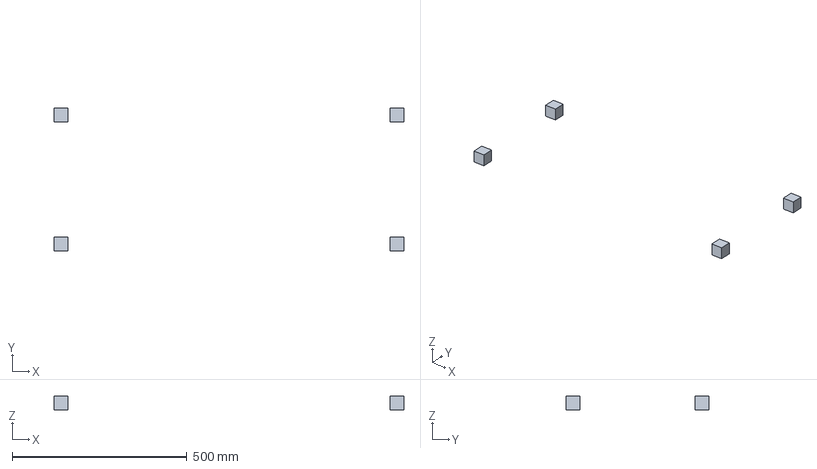
[picture p31: CAD file, 2026-10-09]
cad/parts/main_frame_risers.step
1000.0 x 410.0 x 40.0 mm
