Kaihongho/Powder_model_design/cad/parts/z_mount_adapter.step

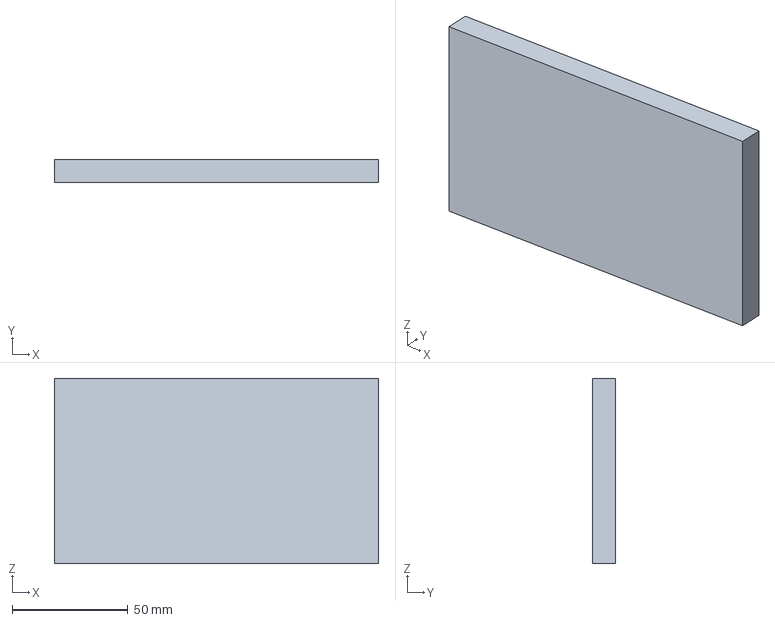
[picture p32: CAD file, 2026-10-09]
cad/parts/z_mount_adapter.step
140.0 x 10.0 x 80.0 mm
