Kaihongho/Powder_model_design/cad/powder_weighing_xyz_platform_RevB.step

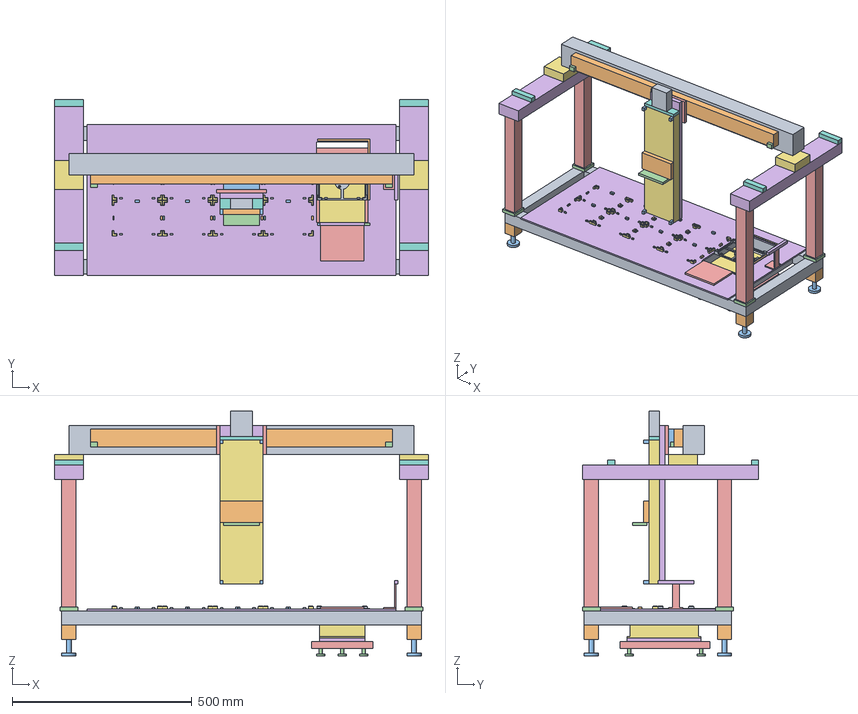
[picture p33: CAD file, 2026-10-09]
cad/powder_weighing_xyz_platform_RevB.step
1040.0 x 490.0 x 680.0 mm
main_lower_frame
deck_plate
wxs_independent_base
wxs_flat_mount_plate
wxs204s_envelope
wxs_adapter_pan_reference
wxs_connected_tray_seat
spill_tray_rear_right
spill_tray_front_left
spill_tray_front_right
tool_rack
y_axis_left
y_carriage_left
y_axis_right
y_carriage_right
x_crossbeam
x_axis_module
x_carriage
z_mount_adapter
z_backplate
z_axis_module
z_motor_mount
z_brake_motor_envelope
z_carriage
quick_change_reserved_plate
ion_bar_supported_bracket
ion_bar_envelope
