Kaihongho/Powder_model_design/drawings/B-003_layout.dxf

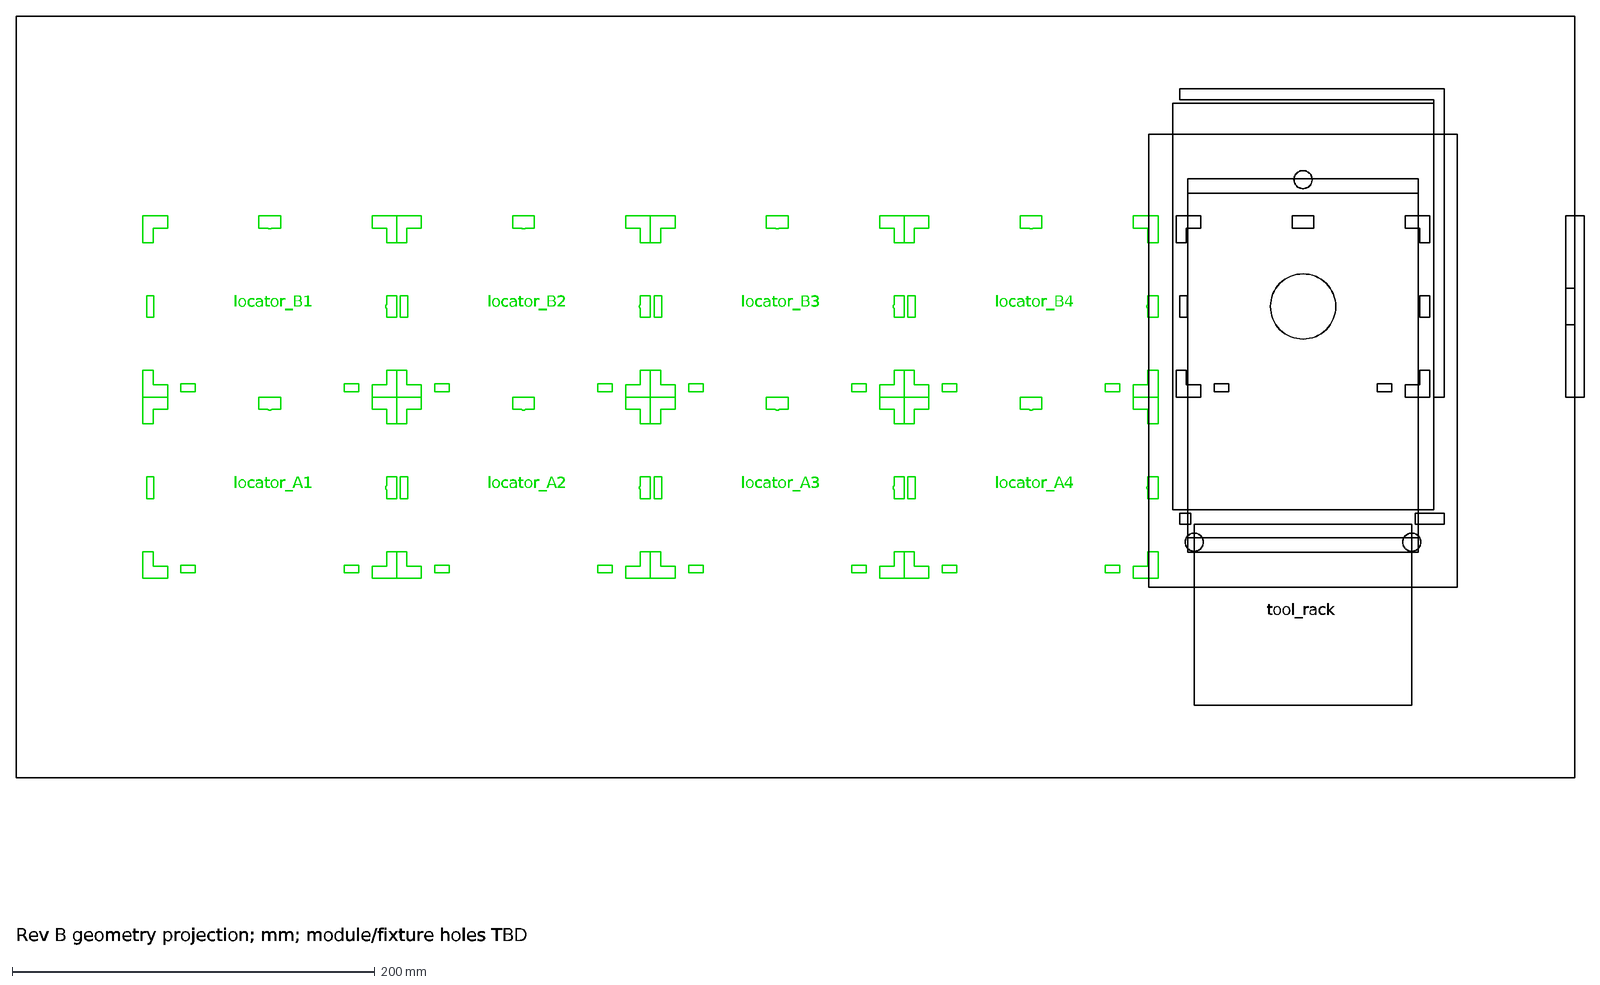
[picture p34: CAD file, 2026-10-09]
drawings/B-003_layout.dxf
locator_A1
locator_A2
locator_A3
locator_A4
locator_B1
locator_B2
locator_B3
locator_B4
tool_rack
Rev B geometry projection; mm; module/fixture holes TBD
