Kaihongho/Powder_model_design/GANTRY44_AUTO_BUCKET.SLDPRT

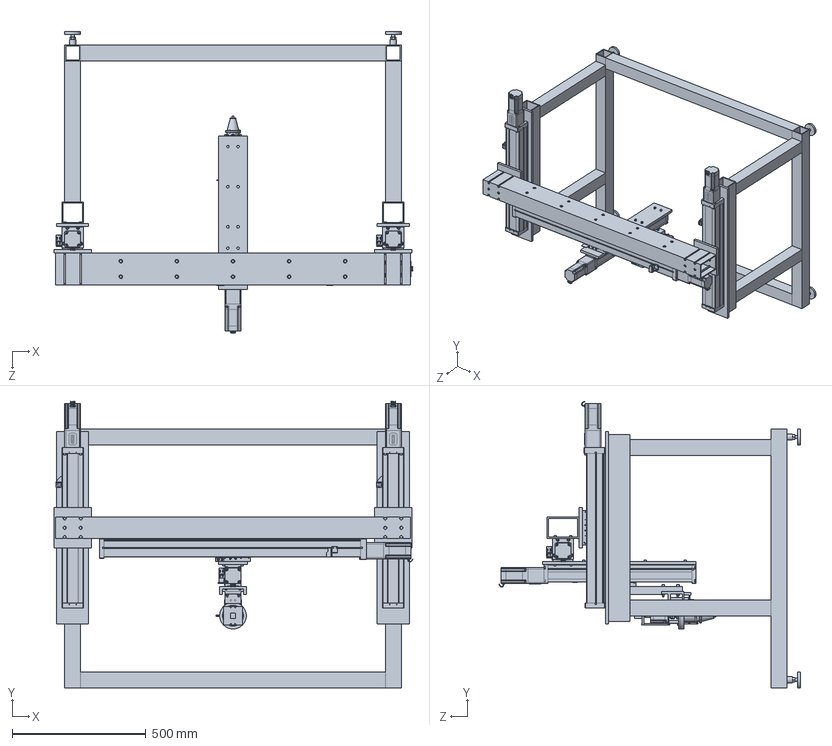
[picture p35: CAD file, 2026-10-11]
GANTRY44_AUTO_BUCKET.SLDPRT
1343.8 x 1072.8 x 1128.8 mm
