Kaihongho/Powder_model_design/分件STEP/夹具与随桶保持件/C-A03_positive_capture_finger_-1.step

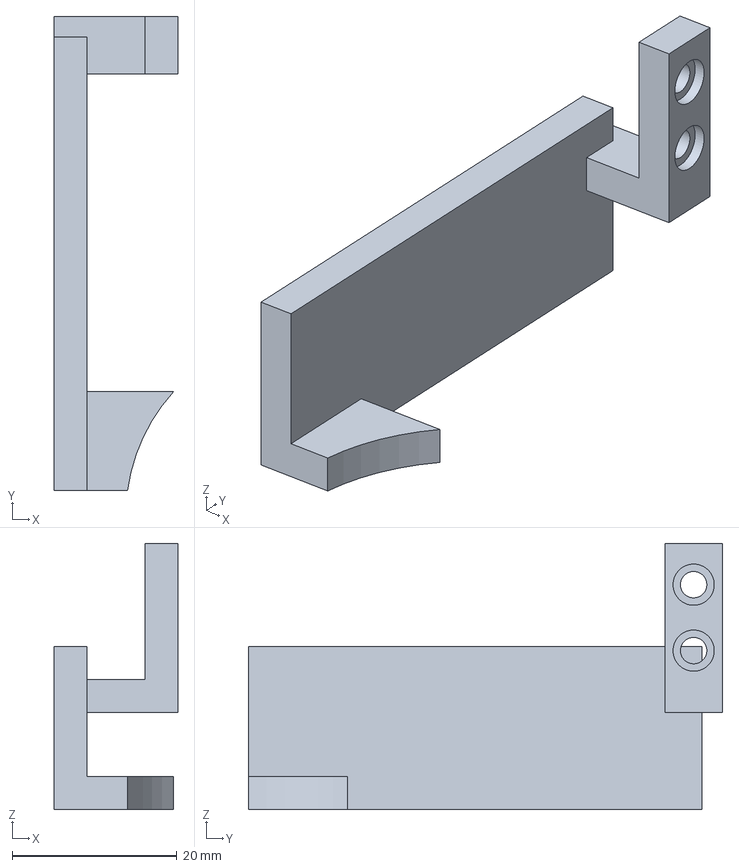
[picture p36: CAD file, 2026-10-11]
分件STEP/夹具与随桶保持件/C-A03_positive_capture_finger_-1.step
15.0 x 57.5 x 32.3 mm
