Kaihongho/Powder_model_design/分件STEP/独立停车座/D-A01_dock_base.step

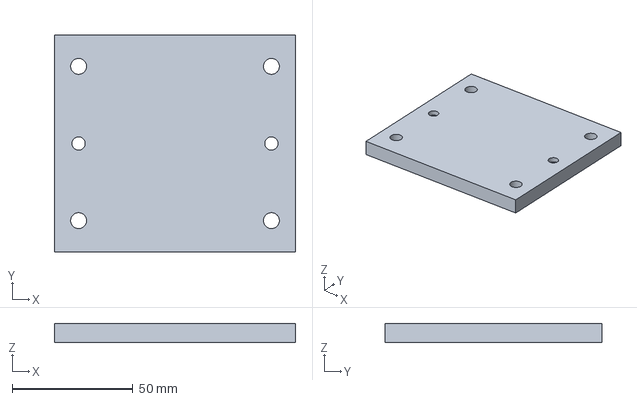
[picture p37: CAD file, 2026-10-11]
分件STEP/独立停车座/D-A01_dock_base.step
100.0 x 90.0 x 8.00 mm
