Kaihongho/Powder_model_design/分件STEP/龙门机架与连接件/F_post_R_rear.step

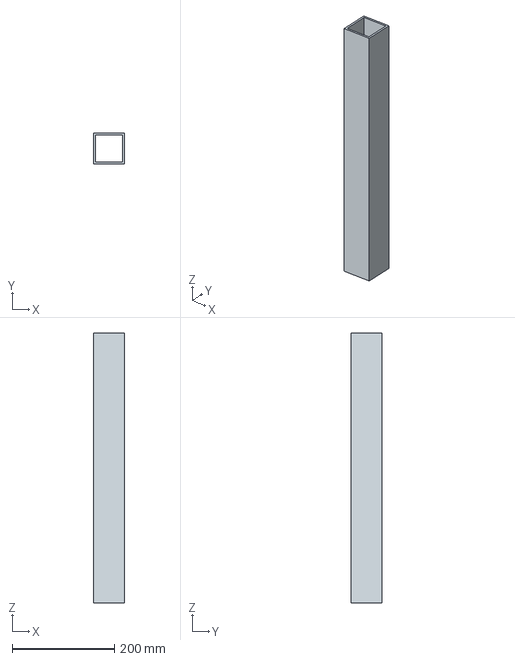
[picture p38: CAD file, 2026-10-11]
分件STEP/龙门机架与连接件/F_post_R_rear.step
60.0 x 60.0 x 528.0 mm
