Kaihongho/Powder_model_design/cad/parts/spill_tray_front_right.step

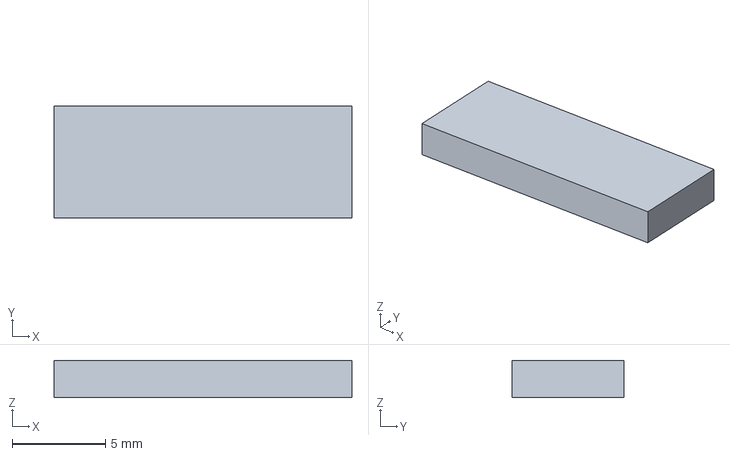
[picture p39: CAD file, 2026-10-09]
cad/parts/spill_tray_front_right.step
16.0 x 6.00 x 2.00 mm
