Kaihongho/Powder_model_design/分件STEP/夹具与随桶保持件/C-A01_head_capture_and_rear_bracket.step

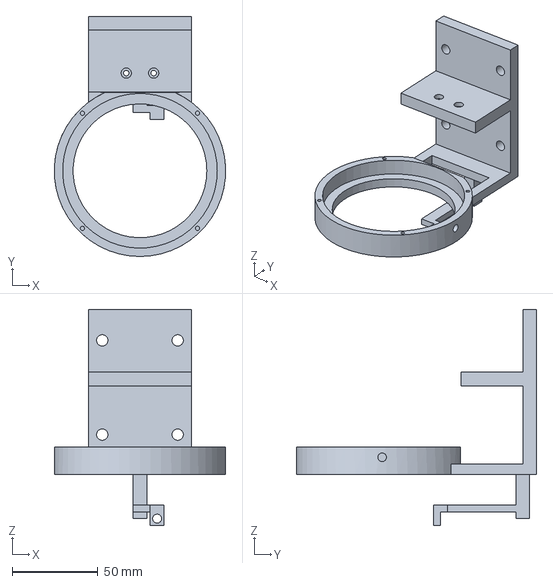
[picture p40: CAD file, 2026-10-11]
分件STEP/夹具与随桶保持件/C-A01_head_capture_and_rear_bracket.step
100.0 x 140.0 x 126.0 mm
