Kaihongho/Powder_model_design/分件STEP/独立停车座/D-A03_support_post_-1.step

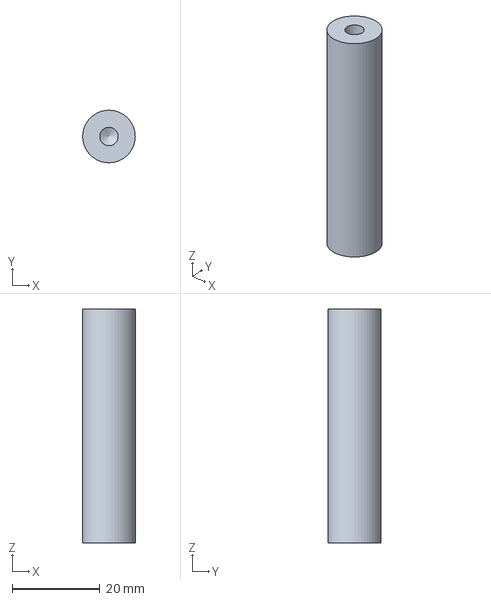
[picture p41: CAD file, 2026-10-11]
分件STEP/独立停车座/D-A03_support_post_-1.step
12.0 x 12.0 x 53.4 mm
