Kaihongho/Powder_model_design/分件STEP/龙门机架与连接件/F_top_rail_R.step

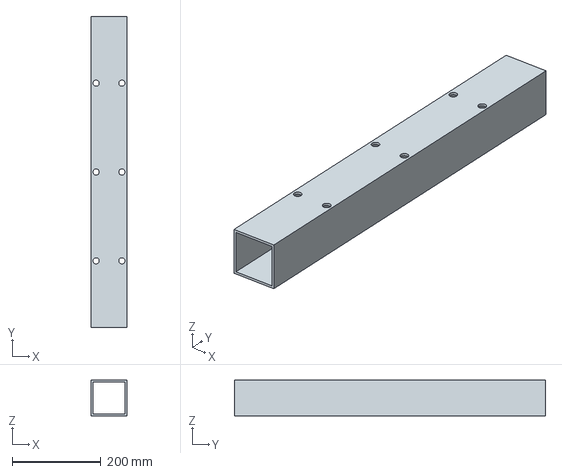
[picture p42: CAD file, 2026-10-11]
分件STEP/龙门机架与连接件/F_top_rail_R.step
80.0 x 700.0 x 80.0 mm
