Kaihongho/Powder_model_design/cad/parts/wxs_flat_mount_plate.step

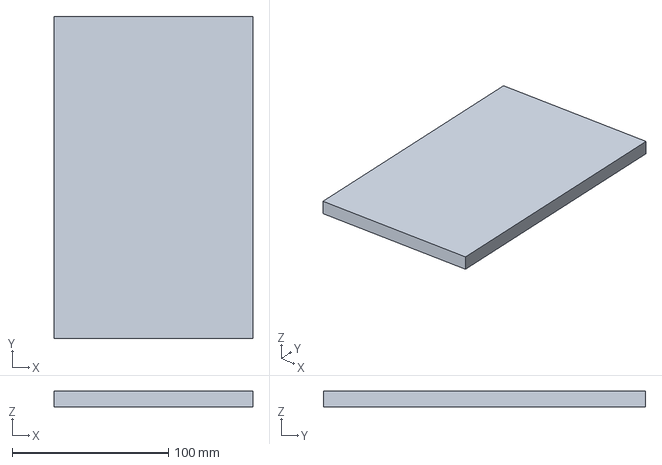
[picture p43: CAD file, 2026-10-09]
cad/parts/wxs_flat_mount_plate.step
127.0 x 206.0 x 10.0 mm
