Kaihongho/Powder_model_design/分件STEP/夹具与随桶保持件/C-A02_head_capture_cap.step

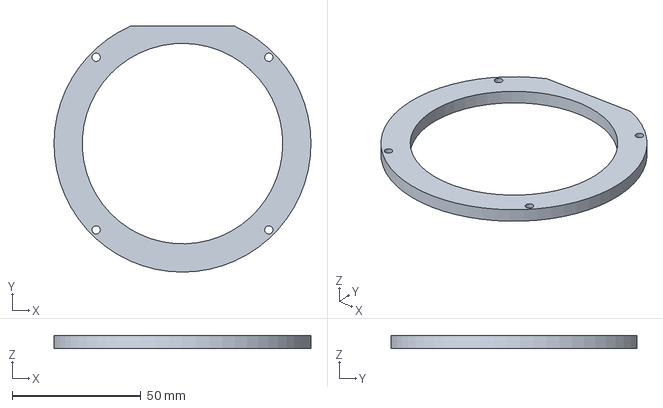
[picture p44: CAD file, 2026-10-11]
分件STEP/夹具与随桶保持件/C-A02_head_capture_cap.step
100.0 x 95.8 x 5.00 mm
