Kaihongho/Powder_model_design/分件STEP/独立停车座/D-A02_flange_support_seat.step

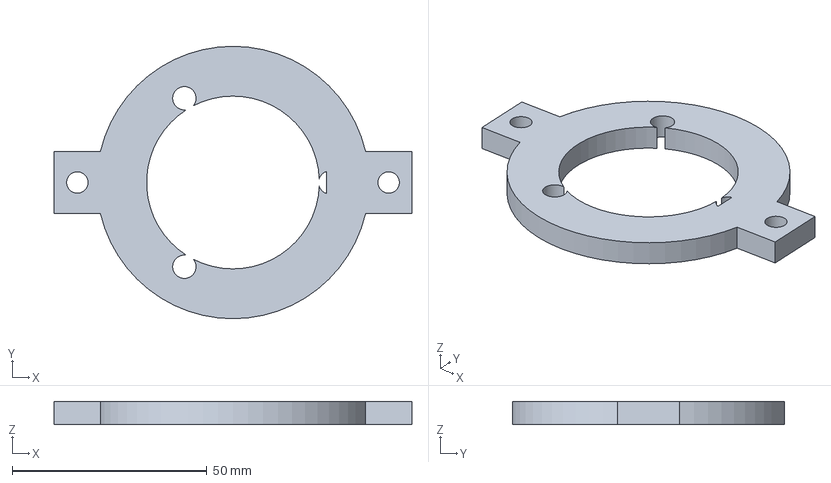
[picture p45: CAD file, 2026-10-11]
分件STEP/独立停车座/D-A02_flange_support_seat.step
92.0 x 70.0 x 6.00 mm
