Kaihongho/Powder_model_design/分件STEP/龙门机架与连接件/F_cross_lower_rear.step

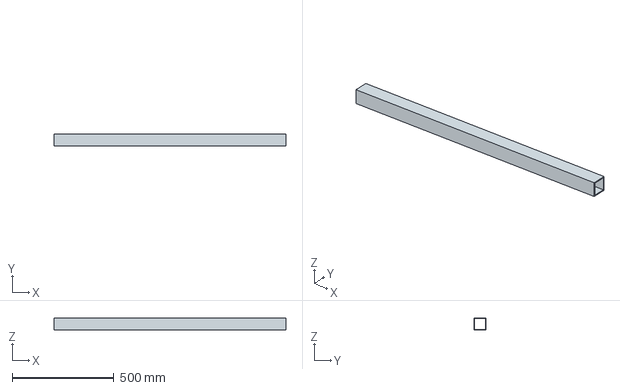
[picture p46: CAD file, 2026-10-11]
分件STEP/龙门机架与连接件/F_cross_lower_rear.step
1140.0 x 60.0 x 60.0 mm
