Kaihongho/Powder_model_design/cad/parts/spill_tray_front_left.step

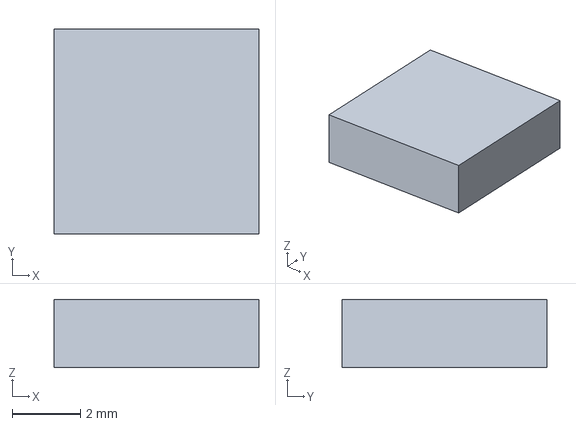
[picture p47: CAD file, 2026-10-09]
cad/parts/spill_tray_front_left.step
6.00 x 6.00 x 2.00 mm
