Kaihongho/Powder_model_design/分件STEP/夹具与随桶保持件/B-A01_lid_AUTO_SWAP_derived.step

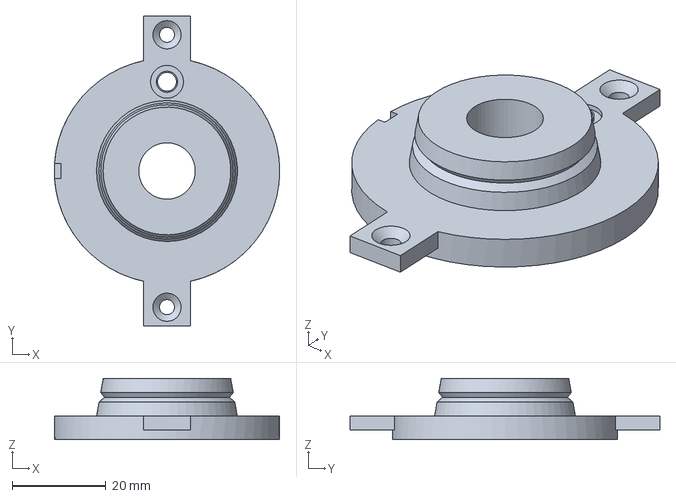
[picture p48: CAD file, 2026-10-11]
分件STEP/夹具与随桶保持件/B-A01_lid_AUTO_SWAP_derived.step
48.0 x 66.0 x 13.0 mm
