Kaihongho/Powder_model_design/分件STEP/龙门机架与连接件/F_top_cap_R.step

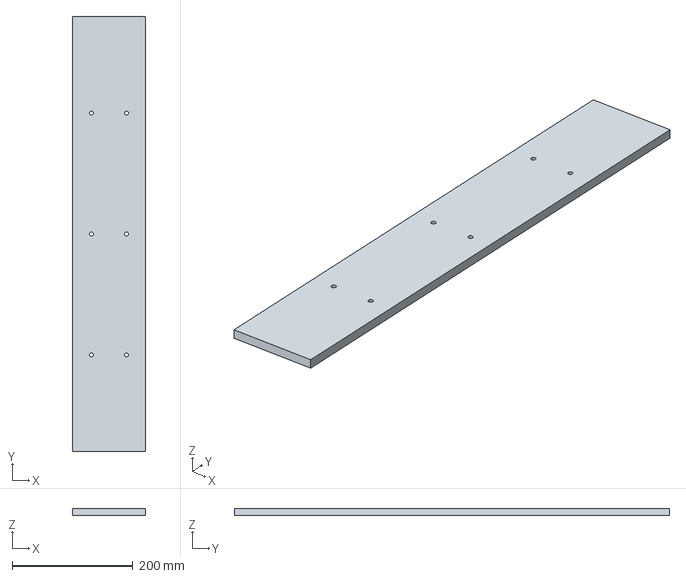
[picture p49: CAD file, 2026-10-11]
分件STEP/龙门机架与连接件/F_top_cap_R.step
120.0 x 720.0 x 12.0 mm
