Kaihongho/Powder_model_design/cad/parts/w_leveling_feet.step

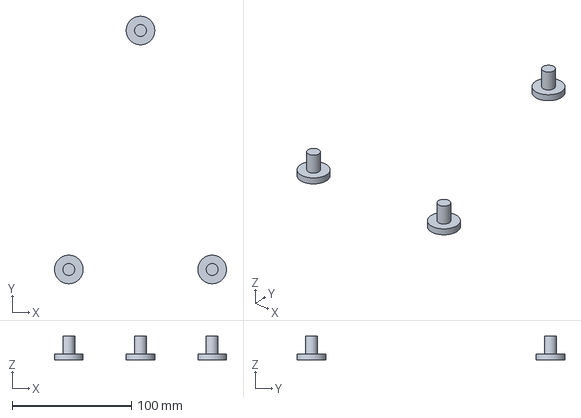
[picture p50: CAD file, 2026-10-09]
cad/parts/w_leveling_feet.step
144.0 x 224.0 x 20.0 mm
