Kaihongho/Powder_model_design/分件STEP/夹具与随桶保持件/B-A03_bucket_retention_foot_-1.step

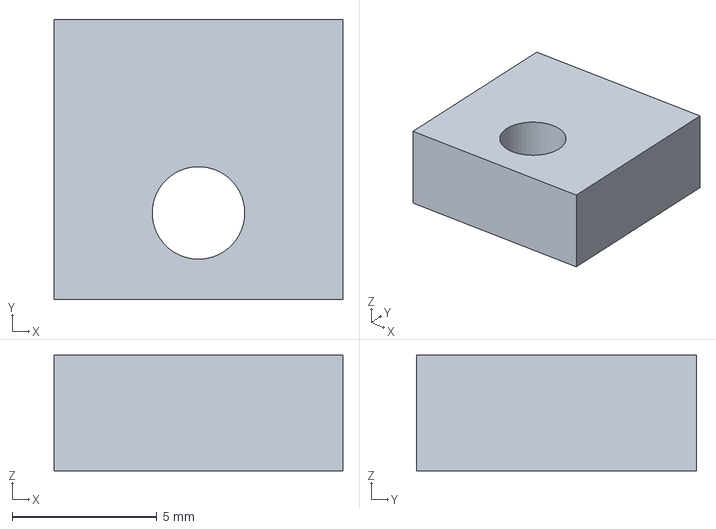
[picture p51: CAD file, 2026-10-11]
分件STEP/夹具与随桶保持件/B-A03_bucket_retention_foot_-1.step
10.0 x 9.70 x 4.00 mm
