Kaihongho/Powder_model_design/cad/parts/y_carriage_left.step

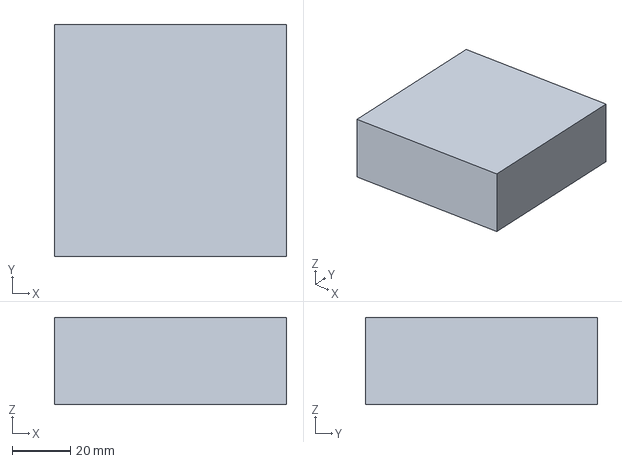
[picture p52: CAD file, 2026-10-09]
cad/parts/y_carriage_left.step
80.0 x 80.0 x 30.0 mm
