Kaihongho/Powder_model_design/分件STEP/夹具与随桶保持件/B-A02_bucket_tie_post_-1.step

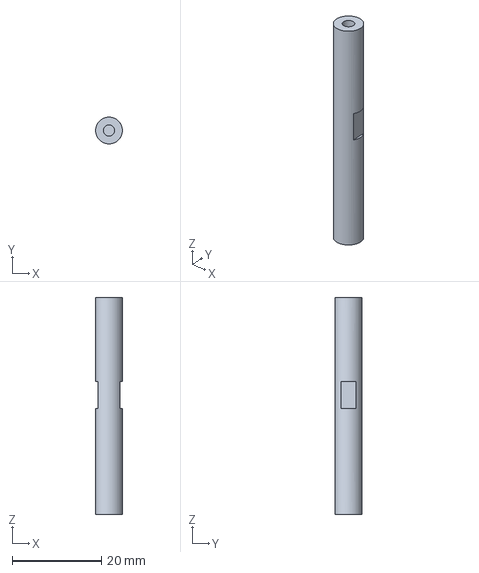
[picture p53: CAD file, 2026-10-11]
分件STEP/夹具与随桶保持件/B-A02_bucket_tie_post_-1.step
6.00 x 6.00 x 48.6 mm
