Kaihongho/Powder_model_design/分件STEP/龙门机架与连接件/F_foot_boss_R_front.step

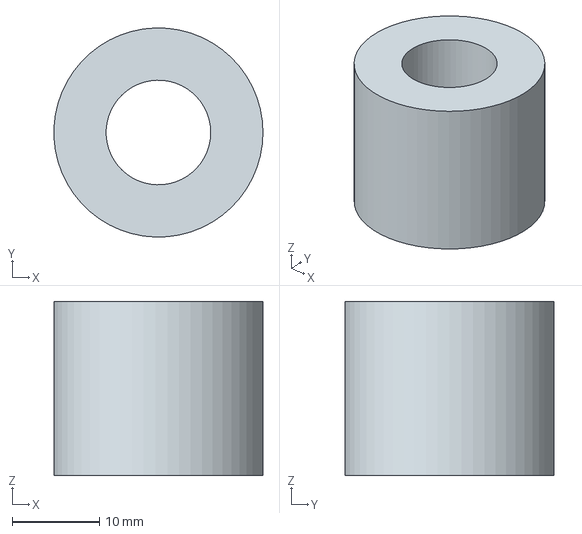
[picture p54: CAD file, 2026-10-11]
分件STEP/龙门机架与连接件/F_foot_boss_R_front.step
24.0 x 24.0 x 20.0 mm
