Kaihongho/Powder_model_design/cad/parts/spill_tray_rear_right.step

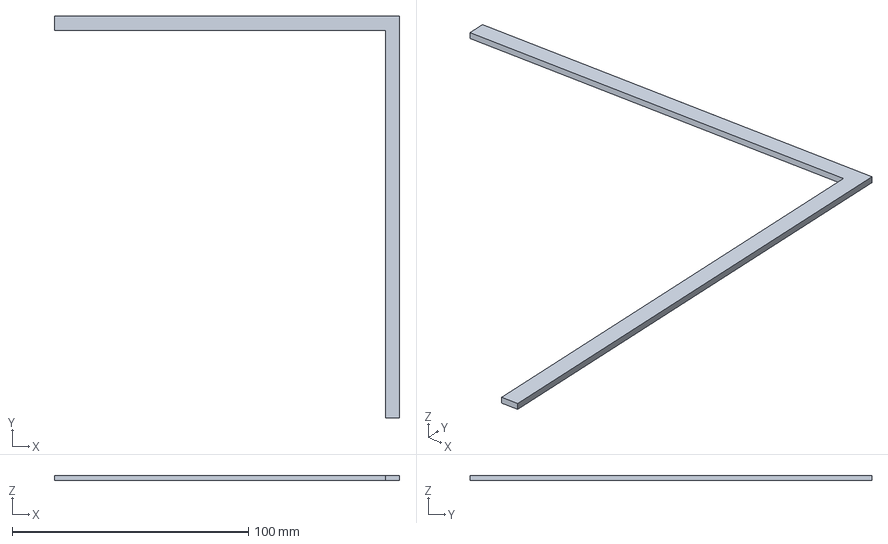
[picture p55: CAD file, 2026-10-09]
cad/parts/spill_tray_rear_right.step
146.0 x 170.0 x 2.00 mm
