Kaihongho/Powder_model_design/cad/parts/locator_B4.step

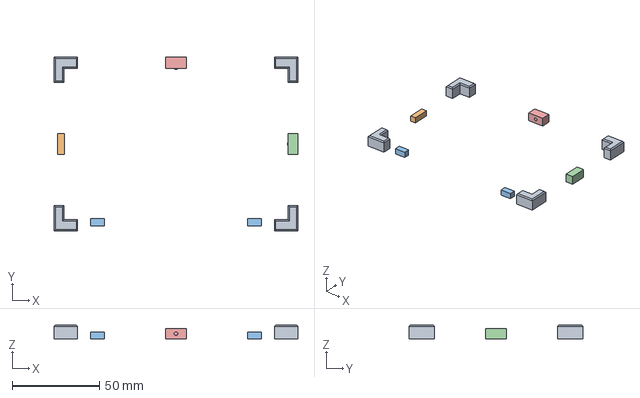
[picture p56: CAD file, 2026-10-09]
cad/parts/locator_B4.step
140.0 x 100.0 x 8.00 mm
