Kaihongho/Powder_model_design/分件STEP/龙门机架与连接件/F_side_lower_L.step

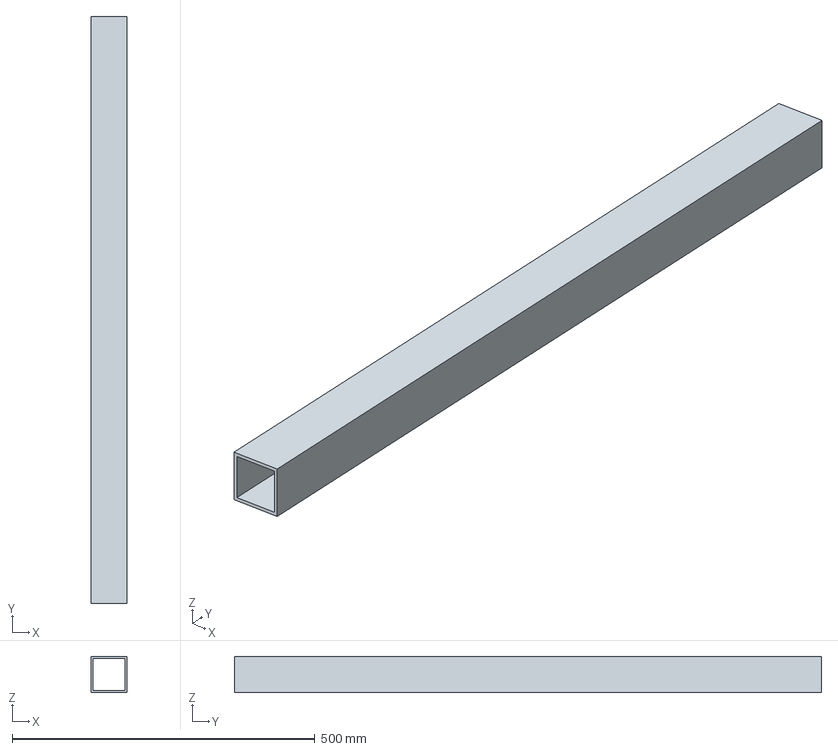
[picture p57: CAD file, 2026-10-11]
分件STEP/龙门机架与连接件/F_side_lower_L.step
60.0 x 969.0 x 60.0 mm
