Kaihongho/Powder_model_design/cad/parts/wxs_adapter_pan_reference.step

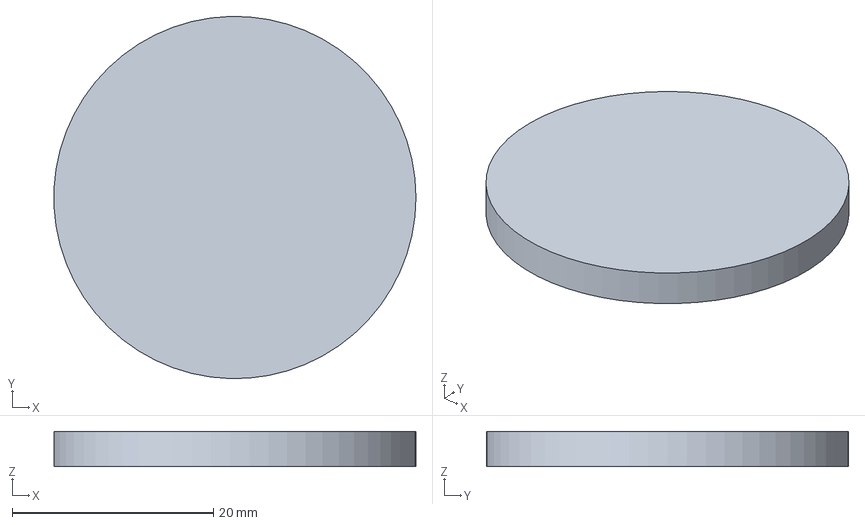
[picture p58: CAD file, 2026-10-09]
cad/parts/wxs_adapter_pan_reference.step
36.0 x 36.0 x 3.50 mm
