Kaihongho/Powder_model_design/分件STEP/龙门机架与连接件/A_Z_tool_drop.step

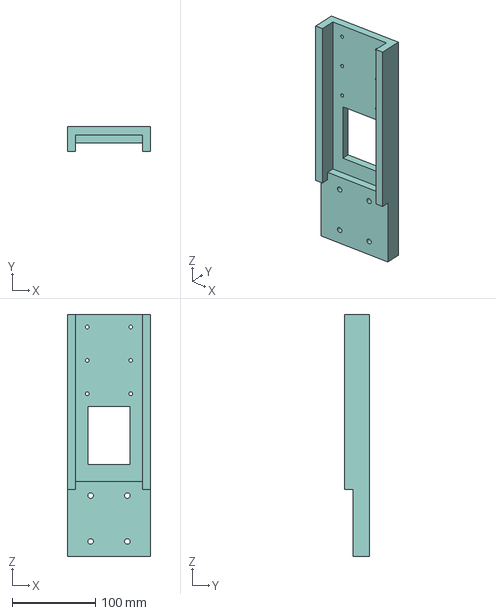
[picture p59: CAD file, 2026-10-11]
分件STEP/龙门机架与连接件/A_Z_tool_drop.step
100.0 x 30.0 x 290.0 mm
