Kaihongho/Powder_model_design/cad/parts/x_axis_module.step

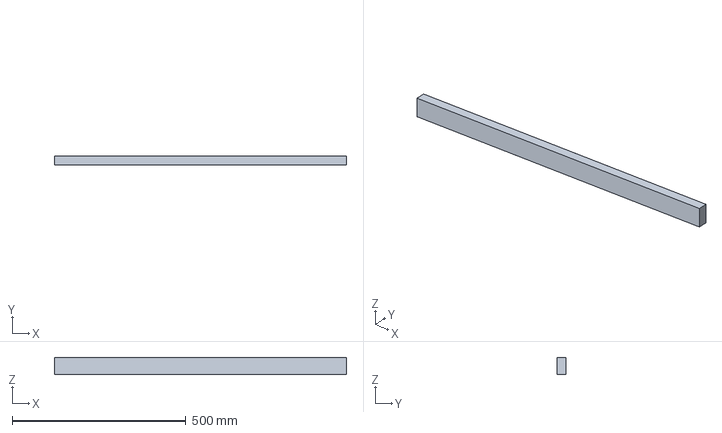
[picture p60: CAD file, 2026-10-09]
cad/parts/x_axis_module.step
840.0 x 25.0 x 50.0 mm
