Kaihongho/Powder_model_design/cad/parts/ion_bar_supported_bracket.step

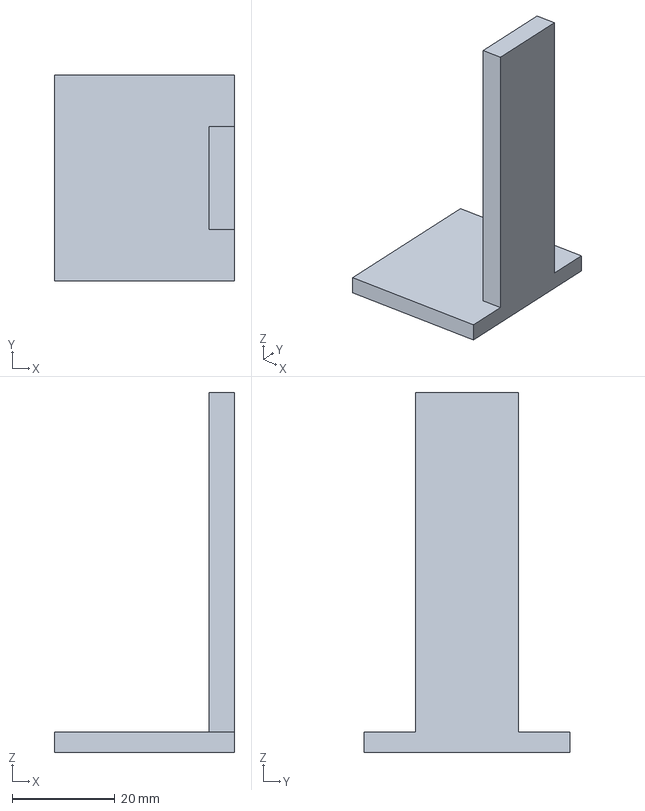
[picture p61: CAD file, 2026-10-09]
cad/parts/ion_bar_supported_bracket.step
35.0 x 40.0 x 70.0 mm
