Kaihongho/Powder_model_design/分件STEP/龙门机架与连接件/B_crossbeam.step

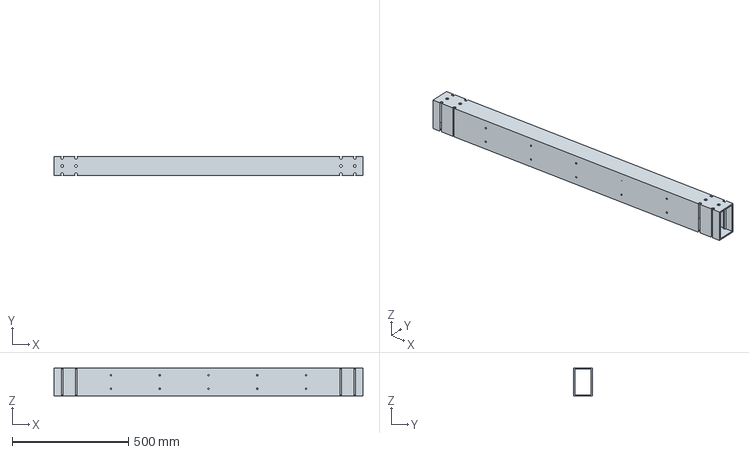
[picture p62: CAD file, 2026-10-11]
分件STEP/龙门机架与连接件/B_crossbeam.step
1330.0 x 80.0 x 120.0 mm
