Kaihongho/Powder_model_design/cad/parts/z_backplate.step

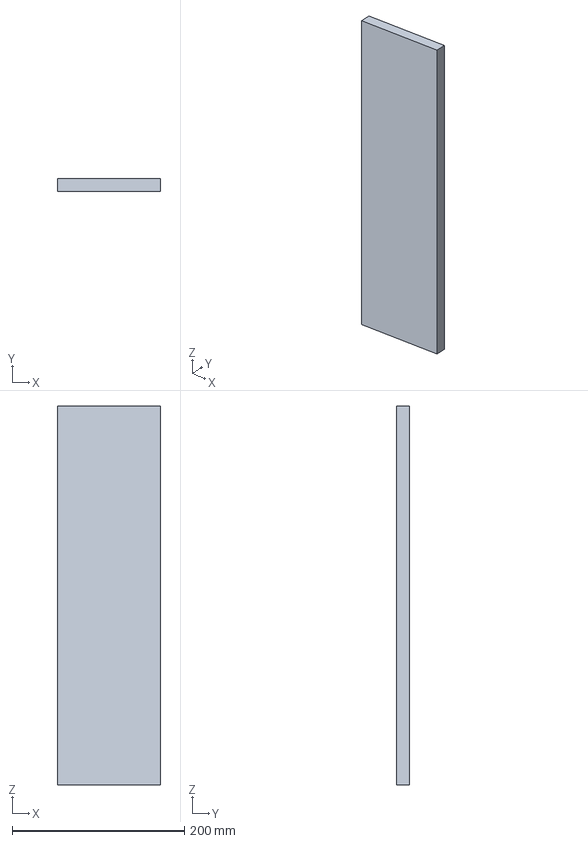
[picture p63: CAD file, 2026-10-09]
cad/parts/z_backplate.step
120.0 x 15.0 x 440.0 mm
