Kaihongho/Powder_model_design/分件STEP/龙门机架与连接件/A_Z_fixed_backplate.step

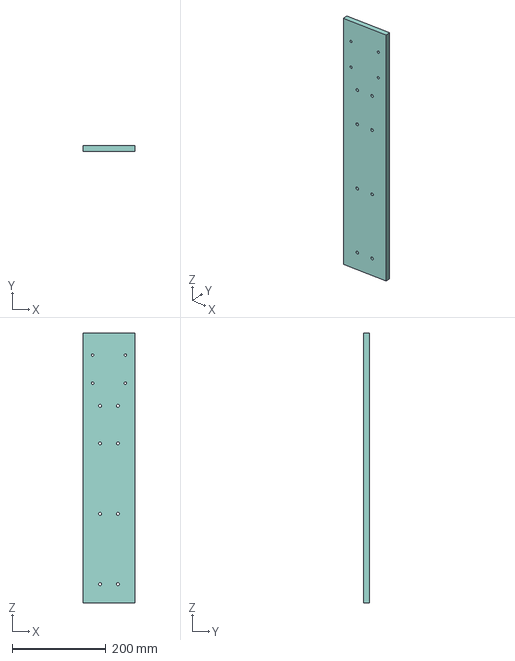
[picture p64: CAD file, 2026-10-11]
分件STEP/龙门机架与连接件/A_Z_fixed_backplate.step
110.0 x 12.0 x 575.0 mm
