Kaihongho/Powder_model_design/cad/parts/wxs_independent_base.step

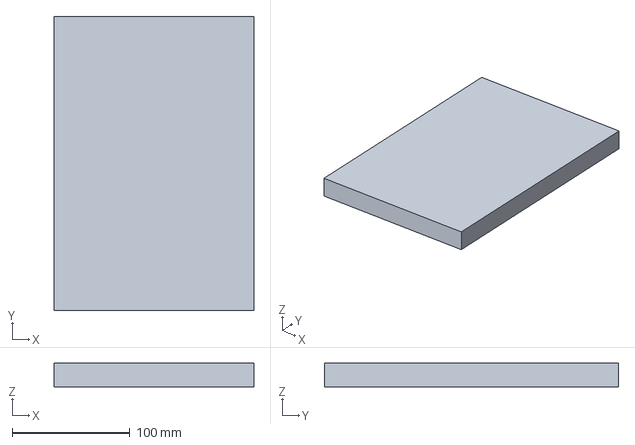
[picture p65: CAD file, 2026-10-09]
cad/parts/wxs_independent_base.step
170.0 x 250.0 x 20.0 mm
