Kaihongho/Powder_model_design/cad/parts/z_brake_motor_envelope.step

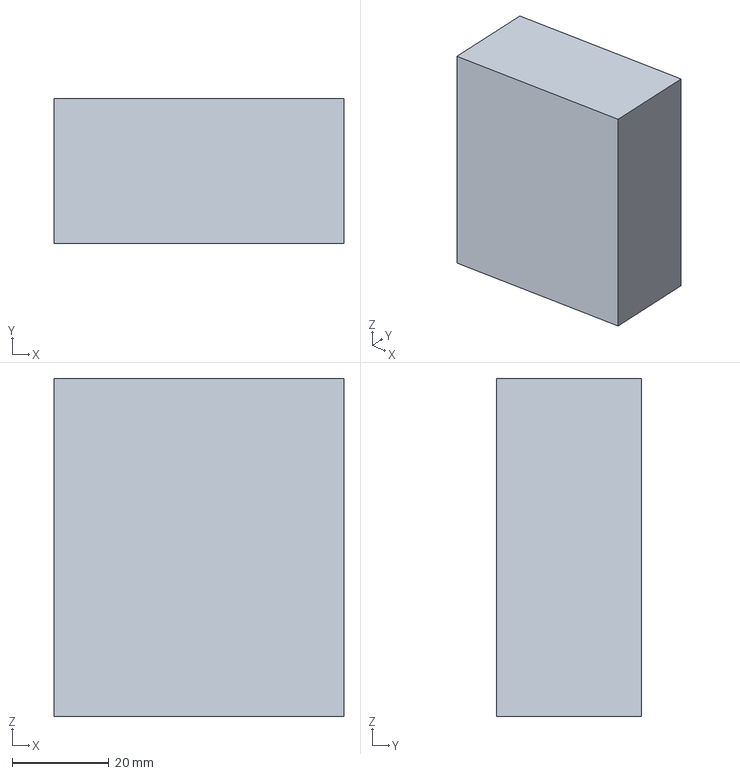
[picture p66: CAD file, 2026-10-09]
cad/parts/z_brake_motor_envelope.step
60.0 x 30.0 x 70.0 mm
