Kaihongho/Powder_model_design/分件STEP/龙门机架与连接件/B_sole_R.step

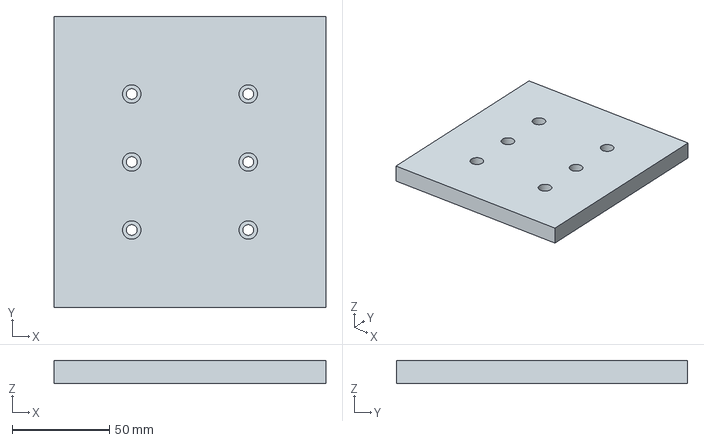
[picture p67: CAD file, 2026-10-11]
分件STEP/龙门机架与连接件/B_sole_R.step
140.0 x 150.0 x 12.0 mm
