Kaihongho/Powder_model_design/cad/parts/z_carriage.step

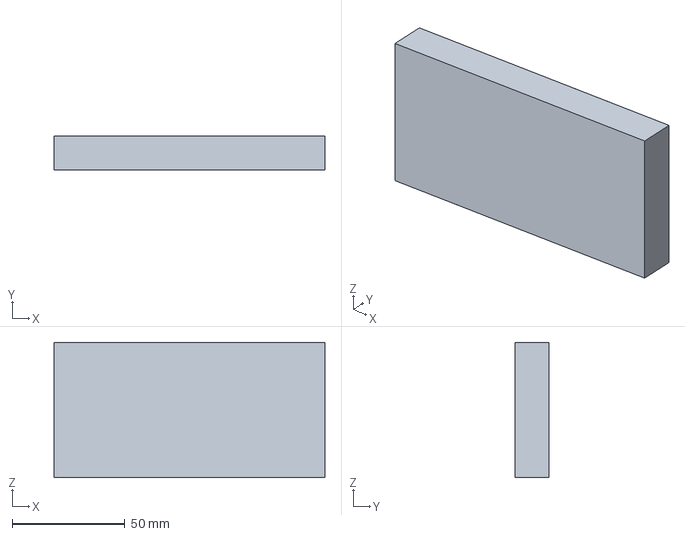
[picture p68: CAD file, 2026-10-09]
cad/parts/z_carriage.step
120.0 x 15.0 x 60.0 mm
