Kaihongho/Powder_model_design/cad/parts/z_axis_module.step

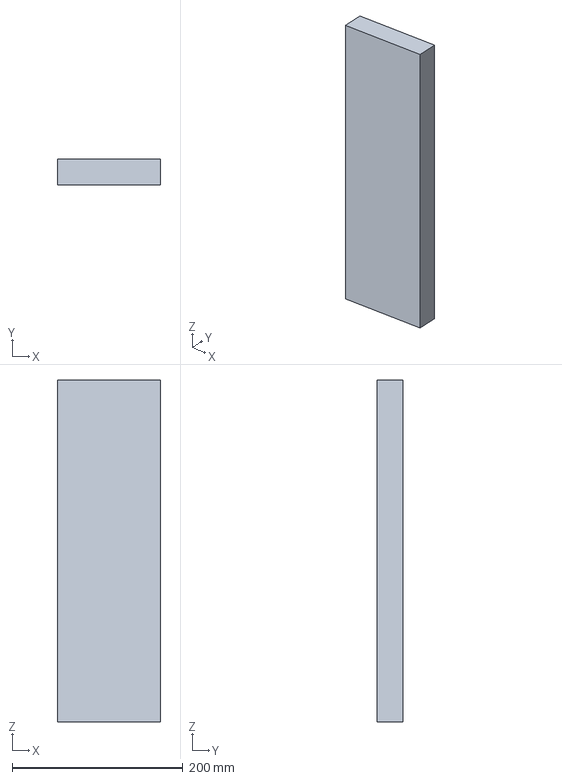
[picture p69: CAD file, 2026-10-09]
cad/parts/z_axis_module.step
120.0 x 30.0 x 400.0 mm
