Kaihongho/Powder_model_design/cad/parts/gantry_column_base_plates.step

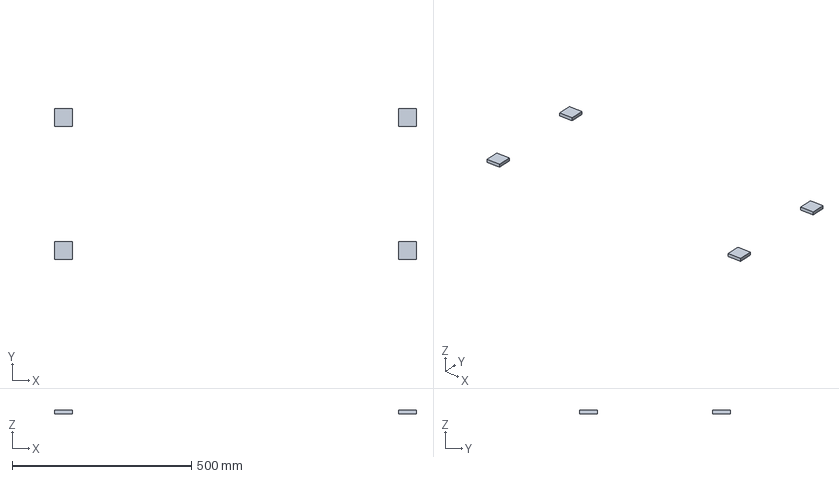
[picture p70: CAD file, 2026-10-09]
cad/parts/gantry_column_base_plates.step
1010.0 x 420.0 x 11.0 mm
