Kaihongho/Powder_model_design/cad/parts/z_limit_stops.step

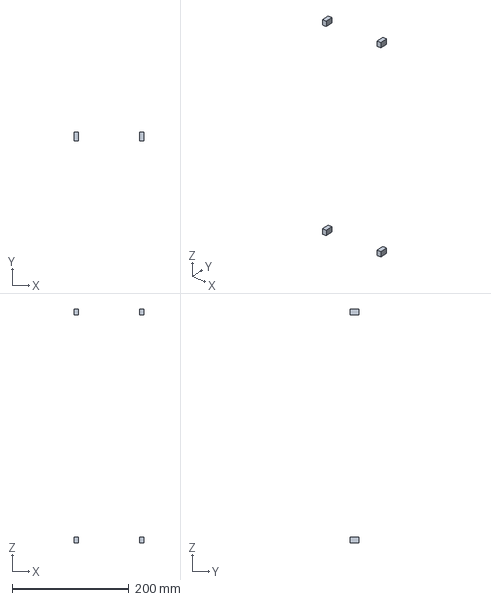
[picture p71: CAD file, 2026-10-09]
cad/parts/z_limit_stops.step
120.0 x 15.0 x 400.0 mm
