Kaihongho/Powder_model_design/cad/parts/x_crossbeam.step

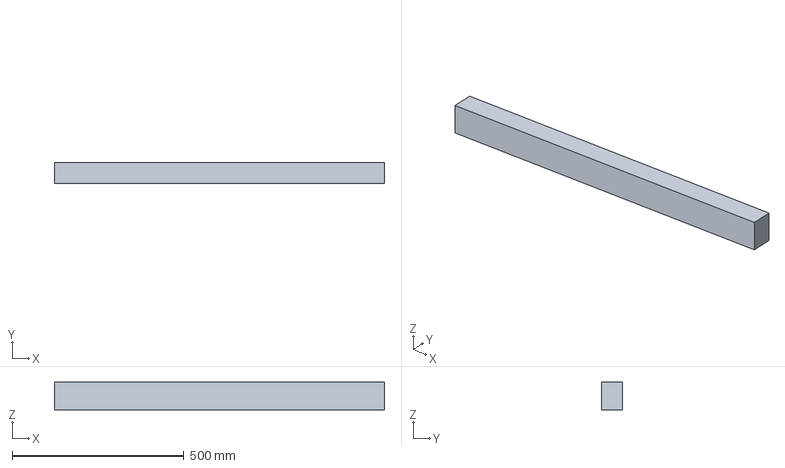
[picture p72: CAD file, 2026-10-09]
cad/parts/x_crossbeam.step
960.0 x 60.0 x 80.0 mm
