Kaihongho/Powder_model_design/cad/parts/z_motor_mount.step

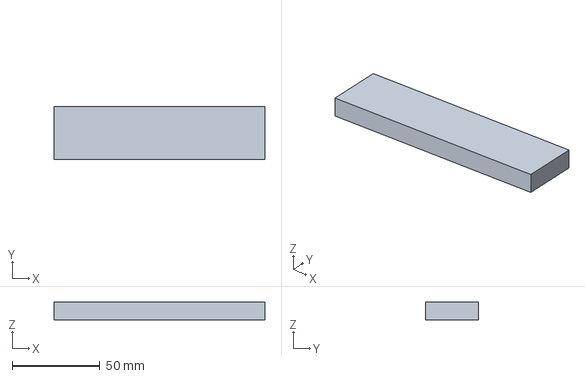
[picture p73: CAD file, 2026-10-09]
cad/parts/z_motor_mount.step
120.0 x 30.0 x 10.0 mm
