Kaihongho/Powder_model_design/cad/parts/gantry_posts.step

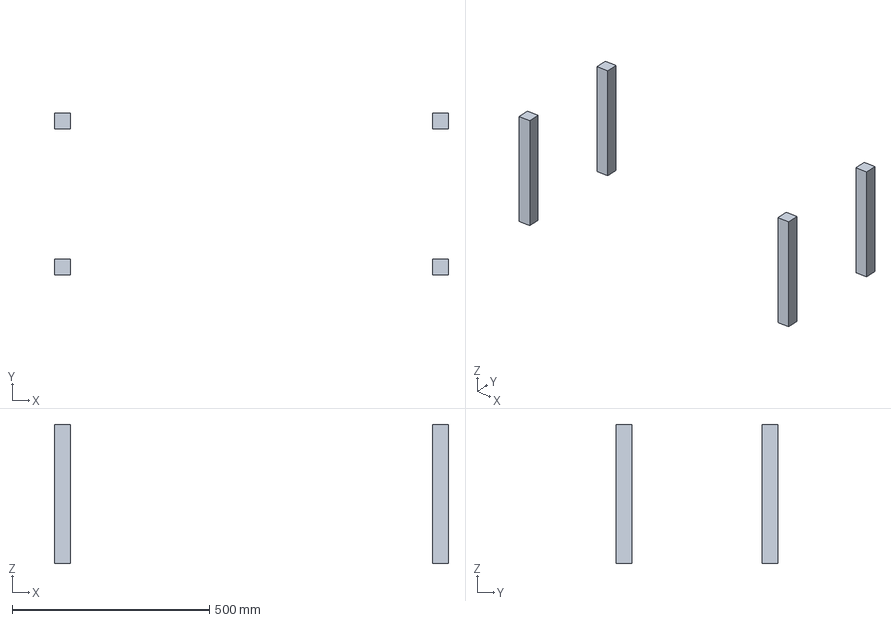
[picture p74: CAD file, 2026-10-09]
cad/parts/gantry_posts.step
1000.0 x 410.0 x 354.0 mm
