Kaihongho/Powder_model_design/cad/parts/y_axis_right.step

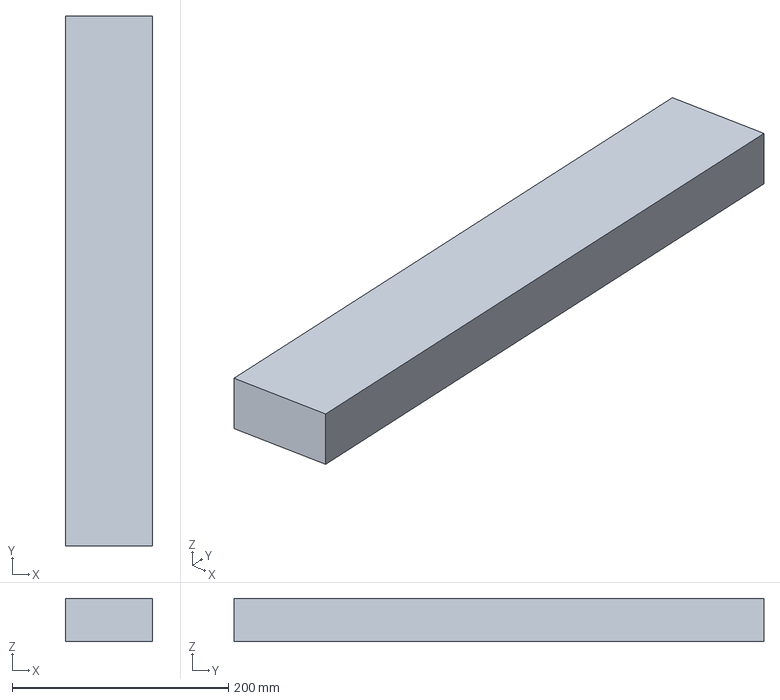
[picture p75: CAD file, 2026-10-09]
cad/parts/y_axis_right.step
80.0 x 490.0 x 40.0 mm
