Kaihongho/Powder_model_design/cad/parts/y_limit_stops_right.step

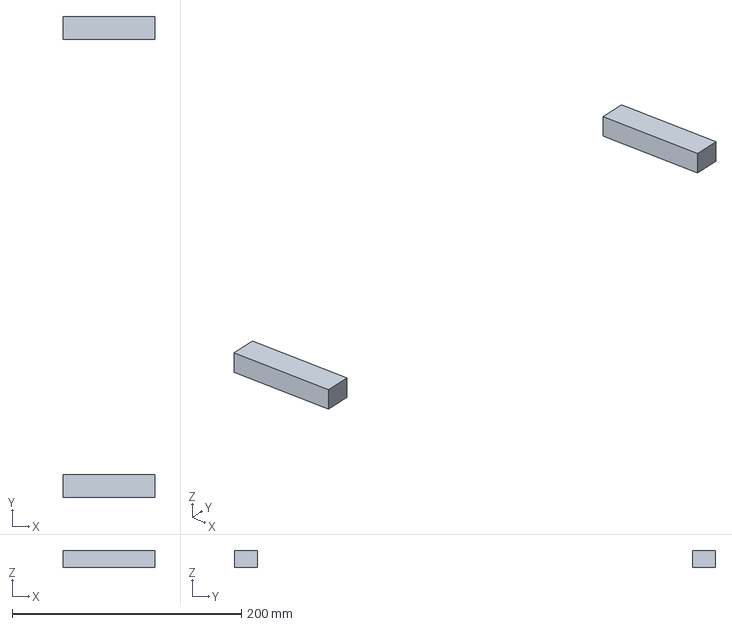
[picture p76: CAD file, 2026-10-09]
cad/parts/y_limit_stops_right.step
80.0 x 420.0 x 15.0 mm
