Kaihongho/Powder_model_design/cad/parts/deck_plate.step

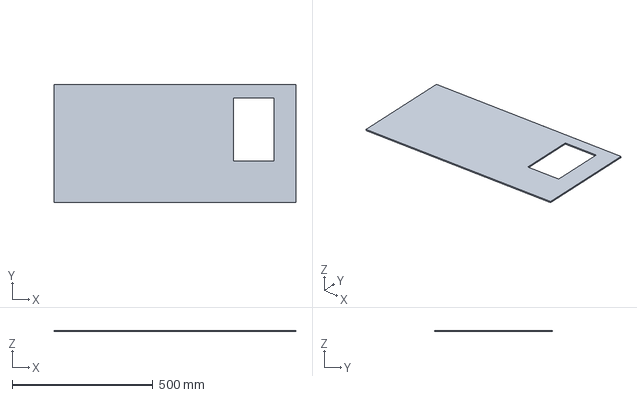
[picture p77: CAD file, 2026-10-09]
cad/parts/deck_plate.step
860.0 x 420.0 x 5.00 mm
