Kaihongho/Powder_model_design/cad/parts/ion_bar_envelope.step

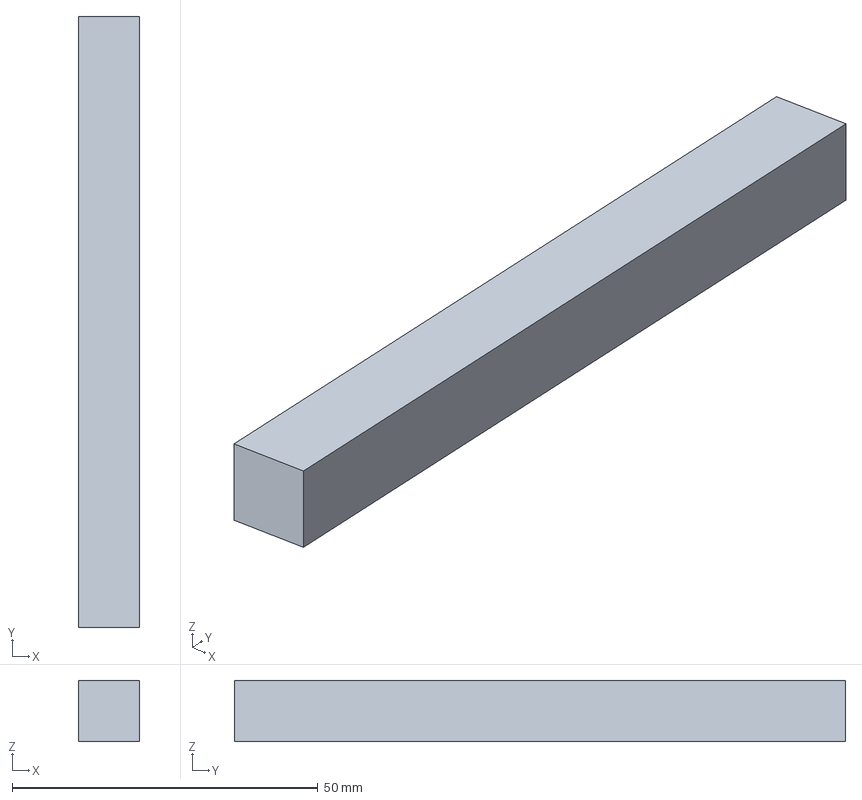
[picture p78: CAD file, 2026-10-09]
cad/parts/ion_bar_envelope.step
10.0 x 100.0 x 10.0 mm
