Kaihongho/Powder_model_design/cad/parts/quick_change_reserved_plate.step

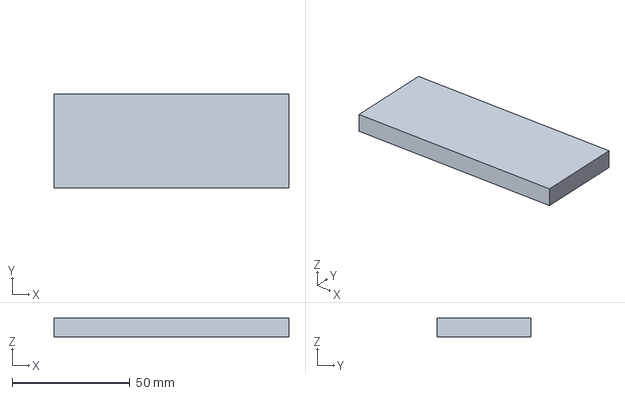
[picture p79: CAD file, 2026-10-09]
cad/parts/quick_change_reserved_plate.step
100.0 x 40.0 x 8.00 mm
