Kaihongho/Powder_model_design/cad/parts/wxs_connected_tray_seat.step

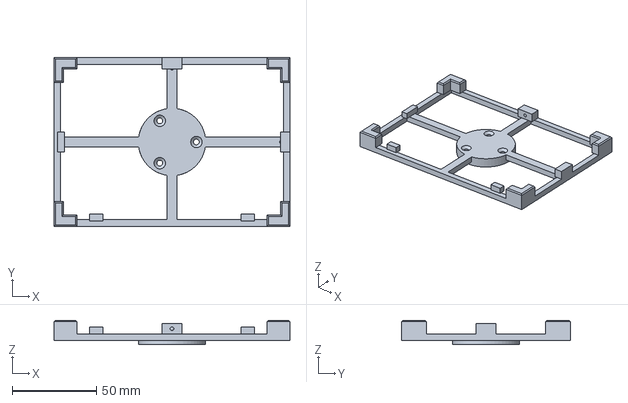
[picture p80: CAD file, 2026-10-09]
cad/parts/wxs_connected_tray_seat.step
140.0 x 100.0 x 14.5 mm
