Kaihongho/Powder_model_design/cad/parts/wxs204s_envelope.step

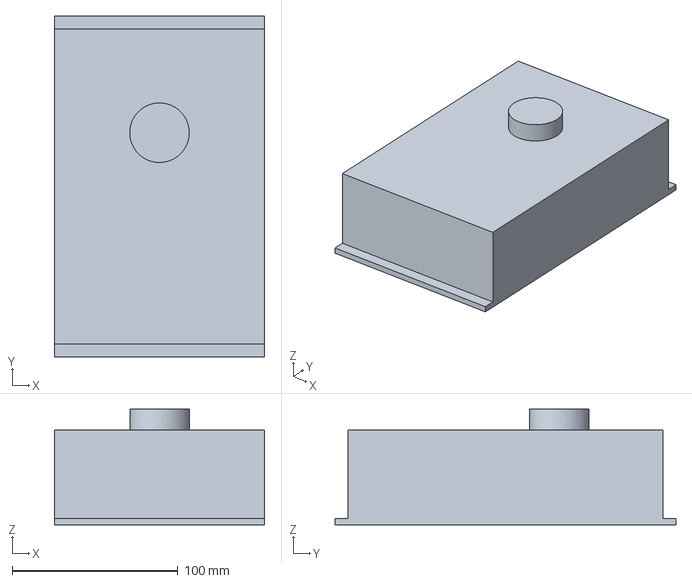
[picture p81: CAD file, 2026-10-09]
cad/parts/wxs204s_envelope.step
127.0 x 206.0 x 70.0 mm
