Kaihongho/Powder_model_design/cad/parts/tool_rack.step

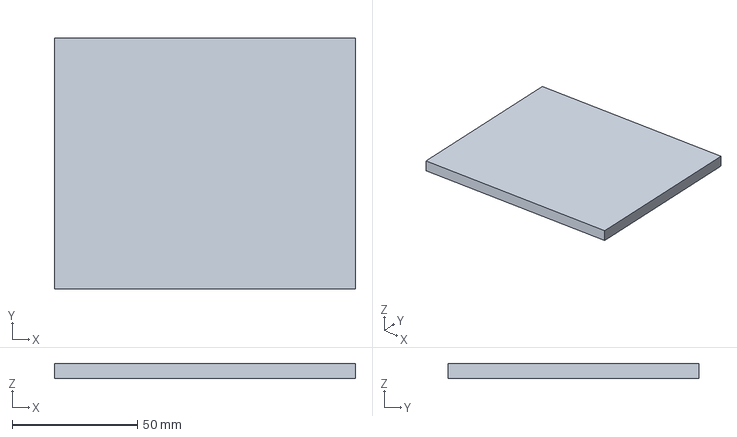
[picture p82: CAD file, 2026-10-09]
cad/parts/tool_rack.step
120.0 x 100.0 x 6.00 mm
