Kaihongho/Powder_model_design/cad/parts/x_limit_stops.step

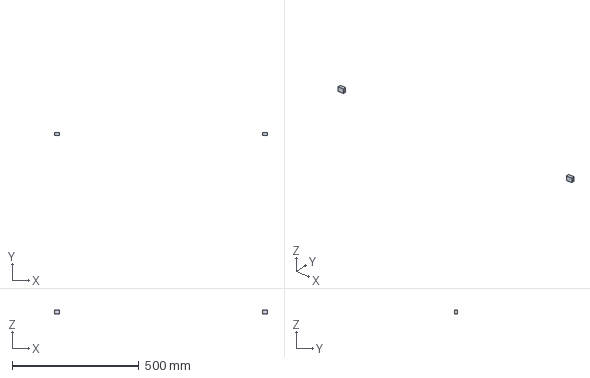
[picture p83: CAD file, 2026-10-09]
cad/parts/x_limit_stops.step
840.0 x 10.0 x 15.0 mm
