Kaihongho/Powder_model_design/cad/parts/x_carriage.step

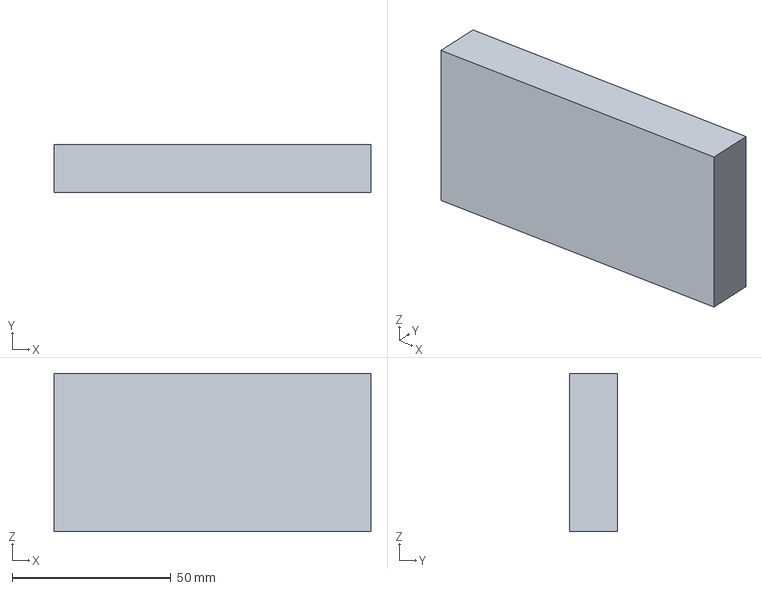
[picture p84: CAD file, 2026-10-09]
cad/parts/x_carriage.step
100.0 x 15.0 x 50.0 mm
