Kaihongho/Powder_model_design/粉桶图纸与说明/PB15_T2_PICKUP_MATED.SLDASM

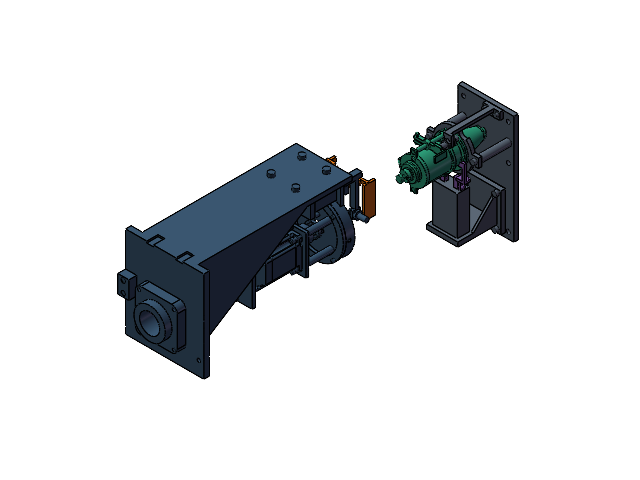
[picture p85: CAD file, 2026-10-16]
粉桶图纸与说明/PB15_T2_PICKUP_MATED.SLDASM
N15_DOCK_D-A02_flange_support_seat
N15_DOCK_D-A03_support_post_-1
N15_DOCK_D-A03_support_post_1
N15_DOCK_D-F01_top_M5x16_-1
N15_DOCK_D-F01_top_M5x16_1
N15_DOCK_D-F02_bottom_M5x16_-1
N15_DOCK_D-F02_bottom_M5x16_1
N15_DOCK_ED-A01_extended_flat_base
N15_DOCK_ED-A02_GEP_L_support
N15_DOCK_ED-A04_dock_sensor_stand
N15_DOCK_ED-A05_0_2mm_adjustment_shim
N15_DOCK_ED-F01_stand_M5x16_-28_-136
N15_DOCK_ED-F01_stand_M5x16_-28_-80
N15_DOCK_ED-F01_stand_M5x16_28_-136
N15_DOCK_ED-F01_stand_M5x16_28_-80
N15_DOCK_ED-F02_GEP_M3x10_-8
N15_DOCK_ED-F02_GEP_M3x10_8
N15_DOCK_ED-F03_GEP_D5_sleeve_-8
N15_DOCK_ED-F03_GEP_D5_sleeve_8
N15_DOCK_ED-F07_sensor_stand_M4x12_26
N15_DOCK_ED-F07_sensor_stand_M4x12_6
N15_DOCK_ED-F08_sensor_M8_nut_lower
N15_DOCK_ED-F08_sensor_M8_nut_upper
N15_DOCK_ED-P01_GEP2006IL03_2D_INTERFACE
N15_DOCK_ED-P02_IES215_M8_30_2D_INTERFACE
N15_CL_C-A01_head_capture_and_rear_bracket
N15_CL_C-A02_head_capture_cap
N15_CL_C-F01_cap_M3x18_0
N15_CL_C-F01_cap_M3x18_1
N15_CL_C-F01_cap_M3x18_2
N15_CL_C-F01_cap_M3x18_3
N15_CL_C-F02_GEP_M3x10_-8
N15_CL_C-F02_GEP_M3x10_8
N15_CL_C-F03_GEP_D5_sleeve_-8
N15_CL_C-F03_GEP_D5_sleeve_8
N15_CL_C-F07_ISO4026_M6x12_anti_rotation
N15_CL_C-P01_GEP2006IL03_2D_INTERFACE
N15_CL_C14_IES215_M8_30_INTERFACE
N15_CL_C14_probe_M8_nut_inner
N15_CL_C14_probe_M8_nut_outer
N15_PB_PB12_L12_fixed_01
N15_PB_PB12_L12_fixed_02
N15_PB_PB12_L12_fixed_03
N15_PB_PB12_L12_fixed_04
N15_PB_PB12_L12_fixed_05
N15_PB_PB12_L12_fixed_06
N15_PB_PB12_L12_fixed_07
N15_PB_PB12_L12_fixed_08
N15_PB_PB12_L12_fixed_12
N15_PB_PB12_L12_mount_M3_-6_-10
N15_PB_PB12_L12_mount_M3_-6_10
N15_PB_PB12_L12_mount_M3_6_-10
N15_PB_PB12_L12_mount_M3_6_10
N15_PB_PB12_L12_support_bridge
N15_PB_PB12_rear_pin_locknut
N15_PB_PB12_rear_shoulder_pin
N15_PB_PB12_rear_spacing_sleeve_L
N15_PB_PB12_rear_spacing_sleeve_R
N15_PB_PB12_stationary_wire_tube
N15_PB_PB12_wire_tube_M12_nut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
