Kaihongho/Powder_model_design/粉桶图纸与说明/PB15_T2_VALVE_ROTATION_MATED.SLDASM

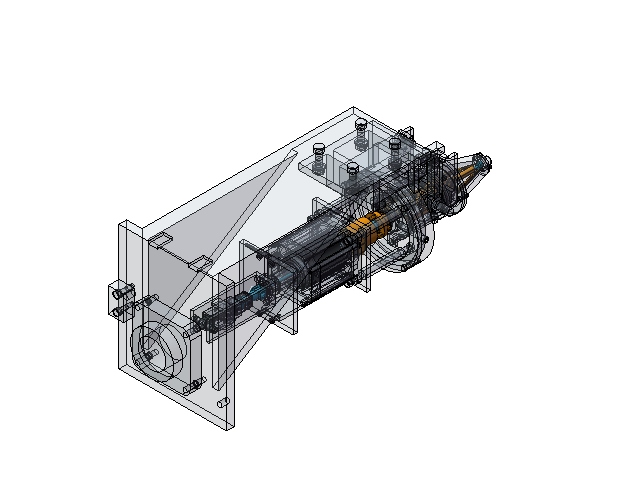
[picture p86: CAD file, 2026-10-16]
粉桶图纸与说明/PB15_T2_VALVE_ROTATION_MATED.SLDASM
N15_CL_B14_steel_presence_target
N15_CL_B14_target_M3_nut
N15_CL_B14_target_M3x14
N15_CL_C-A01_head_capture_and_rear_bracket
N15_CL_C-A02_head_capture_cap
N15_CL_C-A03_positive_capture_finger_-1
N15_CL_C-A03_positive_capture_finger_1
N15_CL_C-F01_cap_M3x18_0
N15_CL_C-F01_cap_M3x18_1
N15_CL_C-F01_cap_M3x18_2
N15_CL_C-F01_cap_M3x18_3
N15_CL_C-F02_GEP_M3x10_-8
N15_CL_C-F02_GEP_M3x10_8
N15_CL_C-F03_GEP_D5_sleeve_-8
N15_CL_C-F03_GEP_D5_sleeve_8
N15_CL_C-F05_finger_M3x10_-1_0
N15_CL_C-F05_finger_M3x10_-1_1
N15_CL_C-F05_finger_M3x10_1_0
N15_CL_C-F05_finger_M3x10_1_1
N15_CL_C-F06_finger_D5_sleeve_-1_0
N15_CL_C-F06_finger_D5_sleeve_-1_1
N15_CL_C-F06_finger_D5_sleeve_1_0
N15_CL_C-F06_finger_D5_sleeve_1_1
N15_CL_C-F07_ISO4026_M6x12_anti_rotation
N15_CL_C-P01_GEP2006IL03_2D_INTERFACE
N15_CL_C-P03_original_jaw_-1
N15_CL_C-P03_original_jaw_1
N15_CL_C14_IES215_M8_30_INTERFACE
N15_CL_C14_probe_M8_nut_inner
N15_CL_C14_probe_M8_nut_outer
N15_PB15_refill_cap_M24x1
N15_PB15_refill_flat_gasket_20p2x22p4
N15_PB_B-A01_lid_AUTO_SWAP_derived
N15_PB_B-A02_bucket_tie_post_-1
N15_PB_B-A02_bucket_tie_post_1
N15_PB_B-A03_bucket_retention_foot_-1
N15_PB_B-A03_bucket_retention_foot_1
N15_PB_B-F01_flush_M3x10_-1
N15_PB_B-F01_flush_M3x10_1
N15_PB_B-F02_bottom_M3x12_-1
N15_PB_B-F02_bottom_M3x12_1
N15_PB_PB12_L12_fixed_01
N15_PB_PB12_L12_fixed_02
N15_PB_PB12_L12_fixed_03
N15_PB_PB12_L12_fixed_04
N15_PB_PB12_L12_fixed_05
N15_PB_PB12_L12_fixed_06
N15_PB_PB12_L12_fixed_07
N15_PB_PB12_L12_fixed_08
N15_PB_PB12_L12_fixed_12
N15_PB_PB12_L12_mount_M3_-6_-10
N15_PB_PB12_L12_mount_M3_-6_10
N15_PB_PB12_L12_mount_M3_6_-10
N15_PB_PB12_L12_mount_M3_6_10
N15_PB_PB12_L12_support_bridge
N15_PB_PB12_nozzle_seat_onepiece
N15_PB_PB12_rear_pin_locknut
N15_PB_PB12_rear_shoulder_pin
N15_PB_PB12_rear_spacing_sleeve_L
N15_PB_PB12_rear_spacing_sleeve_R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
