Kaihongho/Powder_model_design/(list of files, cad)

Other CAD files:
分件STEP/龙门机架与连接件/F_post_L_rear.step
分件STEP/龙门机架与连接件/F_foot_boss_R_rear.step
cad/parts/y_carriage_right.step
分件STEP/龙门机架与连接件/F_top_rail_L.step
分件STEP/龙门机架与连接件/F_top_cap_L.step
分件STEP/龙门机架与连接件/F_foot_boss_L_front.step
cad/parts/locator_A4.step
cad/parts/locator_A1.step
分件STEP/龙门机架与连接件/F_side_lower_R.step
分件STEP/龙门机架与连接件/F_post_R_front.step
分件STEP/龙门机架与连接件/F_cross_lower_front.step
分件STEP/龙门机架与连接件/B_sole_L.step
分件STEP/龙门机架与连接件/F_foot_boss_L_rear.step
分件STEP/龙门机架与连接件/F_post_L_front.step
cad/parts/locator_B1.step
cad/parts/locator_B2.step
cad/parts/locator_A3.step
cad/parts/locator_A2.step
cad/parts/locator_B3.step
cad/parts/y_limit_stops_left.step
cad/parts/y_axis_left.step
cad/powder_weighing_xyz_platform_RevB.SLDPRT
cad/powder_weighing_xyz_platform_RevB.stl
cad/sldprt_parts/deck_plate.SLDPRT
cad/sldprt_parts/gantry_column_base_plates.SLDPRT
cad/sldprt_parts/gantry_posts.SLDPRT
cad/sldprt_parts/ion_bar_supported_bracket.SLDPRT
cad/sldprt_parts/locator_A1.SLDPRT
cad/sldprt_parts/locator_A2.SLDPRT
cad/sldprt_parts/locator_A3.SLDPRT
cad/sldprt_parts/locator_A4.SLDPRT
cad/sldprt_parts/locator_B1.SLDPRT
cad/sldprt_parts/locator_B2.SLDPRT
cad/sldprt_parts/locator_B3.SLDPRT
cad/sldprt_parts/locator_B4.SLDPRT
cad/sldprt_parts/main_frame_risers.SLDPRT
cad/sldprt_parts/main_lower_frame.SLDPRT
cad/sldprt_parts/quick_change_reserved_plate.SLDPRT
cad/sldprt_parts/spill_tray_front_left.SLDPRT
cad/sldprt_parts/spill_tray_front_right.SLDPRT
cad/sldprt_parts/spill_tray_rear_right.SLDPRT
cad/sldprt_parts/tool_rack.SLDPRT
cad/sldprt_parts/wxs_connected_tray_seat.SLDPRT
cad/sldprt_parts/wxs_flat_mount_plate.SLDPRT
cad/sldprt_parts/wxs_independent_base.SLDPRT
cad/sldprt_parts/x_crossbeam.SLDPRT
cad/sldprt_parts/z_backplate.SLDPRT
cad/sldprt_parts/z_motor_mount.SLDPRT
cad/sldprt_parts/z_mount_adapter.SLDPRT
分件STEP/夹具与随桶保持件/B-A02_bucket_tie_post_1.step
分件STEP/夹具与随桶保持件/B-A03_bucket_retention_foot_1.step
分件STEP/夹具与随桶保持件/C-A03_positive_capture_finger_1.step
分件STEP/独立停车座/D-A03_support_post_1.step
分件STEP/龙门机架与连接件/FSL60_M6_slot_nut_local.step
分件STEP/龙门机架与连接件/FSL80_M6_slot_nut_local.step
