Kaihongho/Powder_model_design/粉桶图纸与说明/PB15_三个分装配预览.png

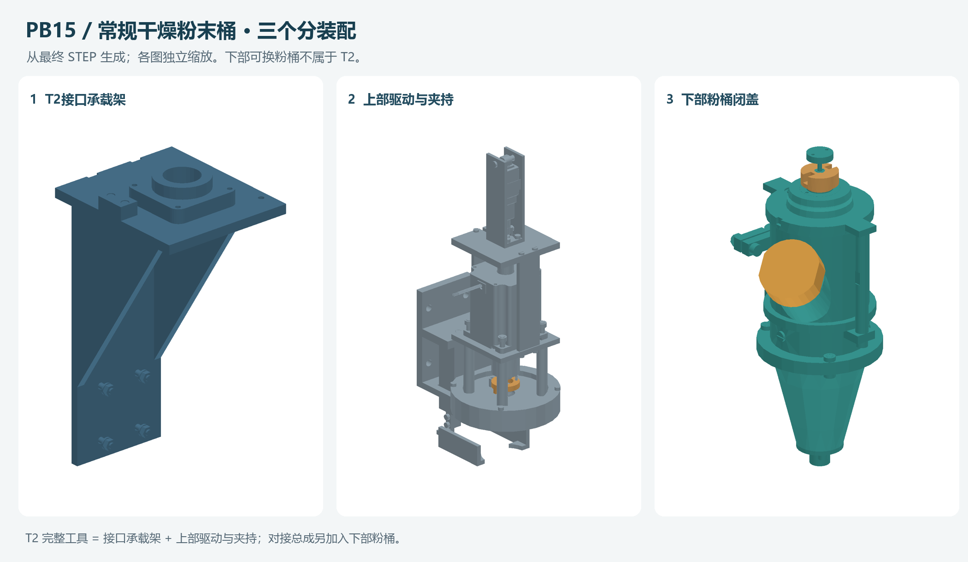
粉桶图纸与说明/PB15_三个分装配预览.png
